NadavOsh/music-notes-detection-system/book/Project's Book.pdf

## הפקולטה להנדסת חשמל ואלקטרוניקה

ספר פרויקט – תואר ראשון

## פיתוח מערכת לזיהוי תווים מוסיקליים

## מאת:

## נדב אושרוב

## מנחה: ד"ר נונל טירר

## תאריך: 06/06/2025

Faculty of Electrical Engineering and Electronics

Bachelor’s Degree Project Book

## Development of a System for Musical Note Recognition

BY:

Nadav Osherov

## Supervisor: Dr. Nonel Tirer

## Date:06/06/2025

תקצירים

תקציר

הפרויקט הוא מערכת לזיהוי תווים מוסיקליים המשתמשת בחומרה ותוכנה משולבת.

המערכת כוללת בין היתר:מצלמה ,FPGA ,ארדואינו וממשק משתמש גרפי ב Python.

המצלמה לוכדת תמונה של תווים על תווים מוסיקליים, ה FPGA-מעבד את התמונה ושולח אותה למחשב, שם ממשק ה GUI-מזהה את התו המוסיקלי בעזרת אלגוריתם זיהוי קווים אדומים ושחורים. לאחר מכן, הארדואינו מפיק את הצליל המתאים דרך באזר פסיבי. הפרויקט משלב רכיבי חומרה ותוכנה לפתרון מעשי לזיהוי תווים בזמן אמת.

Summary

The project is a system for musical note recognition that uses integrated hardware and software. The system includes, among other components, a camera, FPGA, Arduino, and a Python-based graphical user interface. The camera captures an image of notes on a musical staff, the FPGA processes the image and sends it to a computer, where the GUI identifies the musical note using an algorithm that detects red and black lines. Then, the Arduino generates the corresponding sound through a passive buzzer. The project combines hardware and software components to provide a practical solution for real-time note recognition.

EXECUTIVE SUMMARY

Abstract

Music is an integral part of human culture and graphic records of it can be found since the early Middle Ages. Almost a millennium ago, the most common method of graphically recording notes that has survived to this day was developed, the "Staff" method, in which notes are written on five horizontal lines.

Despite the great affinity people have for music, the vast majority of them do not know how to read musical notes, let alone know how they sound from reading alone (which is a skill that most musicians do not have neither).

In recent years, there have been numerous attempts to develop systems that can play notes by photographing them. Most of them are applications rather than stand-alone systems and use machine learning models to perform the OMR, although the models do not work optimally at recognizing musical notes at the same level as they do on other characters [1].

Target

The goal of the project is to develop a system that includes a camera and a passive buzzer, which will enable capturing musical notes from a sheet and playing them using the buzzer.

Project Process:

This project integrates FPGA, Arduino, a camera module, and a Python-based GUI to identify and play musical notes. The system captures a photo of a musical note (with a red line below it), processes the image to detect the note, and then plays the corresponding sound through a passive buzzer.

The project involves four main development parts:

1. Writing code for the FPGA
2. Writing code for the Arduino
3. Developing the Python GUI
4. Creating the note recognition mechanism in Python
1. FPGA Code Development

The FPGA (implemented using a development board with MicroBlaze soft processor) handles the following tasks:

OV7670 Camera Configuration:
The camera is initialized using the SCCB protocol (similar to I2C). A dedicated module with a configuration ROM sends the necessary settings.

Image Capture:
The cam_capture module receives pixel data from the camera and stores it into BRAM (Block RAM). Only a 170×200 pixel region containing the note is captured.

VGA Display Output:
A VGA module reads from BRAM and displays the image on a screen using standard 640×480 VGA timing. A red reference line is drawn to help in note identification.

UART Communication with PC:
MicroBlaze sends the stored image over UART to the PC in text format (as pixel values). The data is processed later by the GUI.

Additional Components:

Clock Generator: Produces 25 MHz and 24 MHz clocks for VGA and camera.

Debouncer: Stabilizes push-button input.

Rising Edge Detector: Ensures single BRAM read per press.

Seven-Segment Display: Shows photo index and total requests.

LED Indicators: Reflect system status (controlled by C code).

2. Arduino Code Development

The Arduino receives the detected musical note via UART and plays the appropriate sound using a passive buzzer connected to pin 8. The code uses a frequency mapping of notes (e.g., DO, RE, MI...) to output PWM signals with the correct tone and duration.

3. GUI Development (Python)

The GUI, built with tkinter, allows the user to:

Initiate the photo-taking process.

Visualize the received image.

Trigger note recognition.

Send the detected note to the Arduino.

It acts as the central interface that connects the FPGA's image output with the Arduino’s sound output.

4. Note Recognition Mechanism in Python

Once the image (with the red line) is received from the FPGA in text format, the recognition process includes several steps:

Step 1: Image Reconstruction

The image is reconstructed from the text file using cv2 and numpy.

Step 2: Binarization and Preprocessing

The image is converted to binary (black and white).

A Gaussian blur is applied to reduce noise and improve line detection accuracy.

Step 3: Detecting the Staff Lines

A function is used to find the five black lines of the musical staff:

staff_lines = find_and_filter_staff_lines(binary, max_lines=5)

Uses np.sum(binary_image, axis=1) to project image brightness along rows.

A threshold is set at 70% of the maximum intensity to identify potential horizontal lines:

threshold = 0.7 * np.max(projection)

potential_lines = np.where(projection > threshold)[0]

The code then merges lines that appear in continuous rows (i.e., thick lines), treating them as one.

Further filtering is done to eliminate false positives: if two lines are closer than 60% of the average distance between staff lines, one of them is removed.

Only the first five valid staff lines are stored for further comparison.

Step 4: Red Line Detection

The RGB image is loaded using:

image = cv2.imread(uploaded_filename)

The image is converted to HSV (Hue, Saturation, Value) color space, which is more effective for color-based segmentation.

The red hue is found in two ranges: 0–10 and 170–180. Additional constraints on saturation (70–255) and value (50–255) ensure only strong reds are captured.

A binary mask is created where the red line appears as white, and everything else is black.

The vertical position (row) of the red line is then calculated.

Step 5: Note Identification

Now with:

An array of five staff line heights (from black line detection)

The vertical height of the red line

The system identifies the note by comparing the red line’s position relative to the black lines.

A predefined array of note names (from highest to lowest) is declared.

The red line's location is compared with each pair of adjacent black lines.

If it falls between two lines, the note is interpolated based on its relative distance.

Slight deviations are accounted for to correct minor noise or imperfect placement.

To sum up, this project demonstrates an end-to-end system combining hardware and software:

Hardware (FPGA + Camera + VGA + UART + BRAM)

Software (Python + OpenCV + GUI + UART)

Microcontroller (Arduino + Buzzer)

The modular design and well-defined stages make it a strong educational example of real-time embedded image processing.

Project Result Summary

In our project, we implemented a musical note recognition system based on simple image processing algorithms. We achieved nearly 100% accuracy in identifying basic white musical notes using a red reference line for detection.

While the recognition was highly successful within our limited set of test images, the project faced several constraints, mainly due to the low-quality camera and the slow UART communication between the FPGA and PC, which limited both data transfer speed and the number of samples we could test.

Some of the key limitations observed:

1. The system cannot currently recognize sharps, flats, or natural signs.
2. It does not identify note durations (whole, half, quarter).
3. Initial attempts using ellipse detection yielded less reliable results on low-resolution images, leading us to switch to the red-line method, which proved more robust under our conditions.

Overall, the system demonstrates that simple tools can achieve effective results in note recognition, and it provides a solid foundation for future enhancements such as duration detection and full music sheet interpretation.

## תוכן עניינים

### 1 מבוא

### 1.2 מטרת הפרויקט14 |

### 1.3 דרישות הפרויקט14 | 2 רקע תיאורטי 14

15 | | FPGA | 2.1
17 | I2C | פרוטוקול | 2.3.3
19 | | VGA | 2.4.2
21 | OpenCV | 2.4.4

### 3 פיתוח מערכת לזיהוי תויוים מוסיקליים 24

### 3.2 פתרונות אלטרנטיביים26 |

### 3.3 שאלת המחקר 27 | 4 מהלך העבודה 28

### 4.2 מימוש 28 |

31 | cam_init 4.2.1.3.1.1

31 | cam_capture 4.2.1.3.1.2
31 | debouncer 4.2.1.3.2
32 | VGA_TOP 4.2.1.3.3
32 | design_1 4.2.1.3.4
33 | simple_seven_segment 4.2.1.3.5
33 | Signal_generator 4.2.1.3.6
33 | BRAM 4.2.1.3.7
33 | Rising_edge_detector 4.2.1.3.8
34 | Clock_gen 4.2.1.3.9
34 | ILA 4.2.1.3.10

### 4.2.1.3.11 תיאור לחצנים, LEDS ו SW בשימוש בערכת הפיתוח פרויקט | 34

35 | Python | מבוסס | GUI | 4.2.2

### 4.2.2.1 מסך -1 פתיחה | 35

36 | Power UP -2 | מסך | 4.2.2.2

4.2.2.3 מסך -3 שאלה למשתמש | 37 4.2.2.4 מסך -4 כמות התמונות | 38 4.2.2.5 מסך -5 הוראות לצילום התמונה | 39 4.2.2.6 מסך -6 הגדרות | 39 4.2.2.7 מסך -7 הרצת ויטיס | 40 4.2.2.8 מסך -8 העלאת קובץ טקסט | 41 4.2.2.9 מסך -9 מסך הזיהוי | 42 4.2.2.10 מסך -10 מסך החלטה | 44 4.2.2.11 מסך -11 מסך ניגון התווים | 45 4.2.2.12 מסך -12 מסך פרידה | 46
47 | | | Arduino | 4.2.3
48 | | | OV7670 | 4.2.4

### 4.2.5 תרשים זרימה של הפרויקט | 48 5 תוצאות והצעות להמשך מחקר 49 6 מסקנות 57 7 ביבליוגרפיה 59

## רשימת איורים

## רשימת טבלאות

טבלה :1 תיאור לחצנים, LEDS ו- SW בשימוש בערכת הפיתוח פרויקט 34 |
טבלה :2 תוצאות של מספר דגימות של תמונות של תווים49 |
טבלה :3 תוצאות של רצף תווים עם משקלים שונים 51 |
טבלה :4 תוצאות של רצף תווים עם סימנים שונים 54 |
טבלה :5 תוצאות של רצף התווים הראשונים של יונתן הקטן55 |

## רשימת קיצורים

OMR – Optical Music Recognition

FPGA – Field-Programmable Gate Array

IP- Instruction Pointer

IC- Integrated Circuit

CPU- Central Processing Unit

I/O- Input/Output

RISC- Reduced Instruction Set Computing

PWM- Pulse-Width Modulation

ICSP- In-Circuit Serial Programming

EEPROM- Electronically Erasable Programmable Read-Only Memory

UART- Universal Asynchronous Receiver-Transmitter

SPI – Serial Peripheral interface

SCLK- Serial Clock

MOSI- Master Out Slave In

MISO- Master In Slave Out

SS- Slave Select

I

2C- Inter-Integrated Circuit

SDA- Serial Data

SCL- Serial Clock

RGB- Red Green Blue

VGA- Video Graphics Array

HDMI- High-Definition Multimedia Interface

RAM- Random Access Memory

USB- Universal Serial Bus

PMOD- Peripheral Module Interface

PC- Personal Computer

SCCB – Serial Camera Control Bus

ROM – Read-Only Memory

LED – Light Emitting Diode

GUI – Graphical User Interface

ILA-Integereted Logic Analyzer

## 1 מבוא 1.1 רקע כללי

מוזיקה היא חלק בלתי נפרד מהתרבות האנושית וניתן למצוא תיעודים גרפים שלה עוד מימי הביניים המוקדמים. לפני כמעט מילניום התפתחה השיטה הנפוצה ביותר לרישום תווים שנופצה עד ימינו אנו, היא שיטת ה"חַ מְ שָׁ ה" בה התווים כתובים על גבי חמישה קווים אופקיים.

אף על פי הזיקה הרבה שיש לאנשים למוזיקה, רובם המוחלט לא יודע לקרוא תווים מוסיקליים, על אחת כמה וכמה לדעת איך הם נשמעים מקריאה בלבד )שזו מיונות שגם למרבית המוזיקאים אין(.

בשנים האחרונות נעשה מספר רב של ניסיונות לפתח מערכות שיידעו לנגן תווים על ידי צילום שלהם. רובן ככולן הן אפליקציות ולא מערכות שעומדות בפני עצמן ומשתמשות במודלים של למידת מכונה על מנת לבצע את ה OMR, אם כי המודלים אינם עובדים בצורה מיטבית על זיהוי תווים מוסיקליים באותה רמה של זיהוי תווים שאינם מוסיקליים ]1[.

## 1.2 מטרת הפרויקט

מטרת הפרויקט היא לפתח מערכת הכוללת מצלמה ובאזר פאסיבי שבאמצעותה יהיה ניתן לצלם את התווים השונים מתוך דף התווים לשמוע אותם מתנגנים על ידי הבאזר.

## 1.3 דרישות הפרויקט

- הכרת העקרונות של כתיבת תווים ברמה בסיסית
- שימוש במצלמה בעזרת FPGA
- למידת והכרת העקרונות של עיבוד תמונה וראייה ממוחשבת
- מימוש התקשורת בין הרכיבים השונים
- תיעוד בספר הפרויקט
- עמידה בלוחות זמנים

## 2 רקע תאורטי

– FPGA 2.1
רכיב חומרה הניתן לתכנות ומאפשר יצירת מעגלים דיגטליים מותאמים אישית. ההבדל העיקרי בינוי לבין מעבד הוא שה-FPGA יכול לעבוד בצורה מקבילית כלומר לבצע מספר פעולות במקביל.
ה-FPGA בנוי ממספר חלקים עיקריים: א. בלוקים לוגיים- יחידות עיבוד בסיסיות שמבצעות פעולות לוגיות ואריתמטיות. ב. רשת חיבור- מערכת של קווים שמחברת בין הבלוקים הלוגיים השונים. ג. יחידות זיכרון- מאפשרות אחסון נתונים. ד. חיבורי O/I- מאפשרים תקשורת עם רכיבים חיצוניים.

ה-FPGA יכול להגיע לקצבים גבוהים מאוד וניתן למצוא אותו בתעשיות הביטחוניות והרפואיות.

-MICROBLAZE 2.1.1
מעבד תוכנתי שנמצא בשימוש בפךטפורמות FPGA של חברת XILINX. הוא נבנה כמעבד גמיש אשר ניתן להגדירו בקלות. המיקרובלייז נותן אפשרות למפתחים לכתוב קוד בשפת תכנות ספציפיות )לדוגמה: שפת C ) ו"להשתיל" את הקוד הזה בתוך ה-FPGA. יתרון מרכזי של מיקרובלייז הוא שדרכו ניתן לכתוב ולקרוא מתוך רגיסטרים של s'IP מסוימים של חברת XILINX דרך קריאה וכתיבה של מזיכרון בשפת תכנות ספציפיות וללא צורך בכתיבת קוד בשפת חומרה.

### 2.2 מיקרובקרים –

מיקרובקר הוא מערכת מחשב קטנה ועצמאית המיועדת לבצע משימות ספציפיות. המיקרובקרים הם בעצם מעגלים משולבים )IC )המשלבים מעבד )CPU), רכיבי זיכרון, רכיבי קלט\פלט )O/I )ועוד.
מיקרו בקרים נמצאים בשימוש נרחב ביישומים שונים כגון רובוטיקה, מכשור רפואי, אוטומצייה תעשייתית וכו'.
למיקרו בקרים יש זיכון שאינו נדיף, מה שמאפשר להם לשמור נתונים גם לאחר שהם מנותקים מהחשמל.

-Arduino Uno 2.2.1
בין מוצרי המיקרו בקרים הנפוצים למשל ניתן למצוא את Uno Arduino. ערכה זו מכילה את המיקרובקר 328ATmega ממשפחת megaAVR של Atmel. מיקרובקר זה מכיל יחידת עיבוד שבנויה בארכיטקטורת הרווארד )בה יש הפרדה בין הזיכרון קוד לזיכרון דאטה( RISC bit8-)מקבלת בכל פעם דאטה של 8 בתים ומשתמשת בסט הוראות פשוטות ומהירות(. ה Uno Arduino מכיל 14 כניסות\יציאות דיגיטליות )מתוכם 6 יכולות לשמל כ יציאות PWM, 6 כניסות אנלוגיות, כניסת USB ואפשרות לחבר לחשמל ישירות ע"י Jack Power, ICSP )המאפשרים להעלות את התוכנה באופן ישיר מבלי לגעת בחומרה( כפתור אתחול ושעון בתדר 16 MHz. ה ATmega מכיל EEPROM( זיכרון לקריאה בלבד הניתן למחיקה אלקטרונית( בגודל kb.1 בתמונה למטה ניתן לראות את הערכה עם הפורטים השונים שלה.

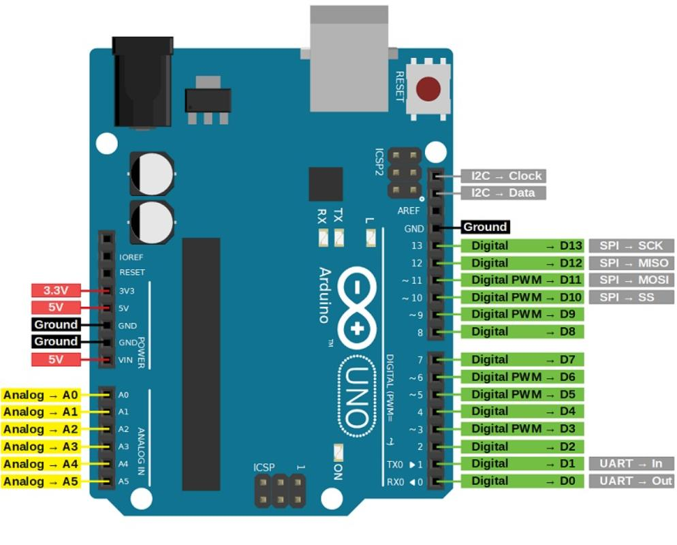
[picture p1: figure]

איור :1 הפורטים של ארדואינו אונו

-Raspberry Pi 2.2.2
עוד ערכה שנחשבת לעיתים דחופות למיקרובקר היא רסאפברי פאי. דבר זה הוא למעשה טעות מאחר מכיוון שראספברי פאי אינו מיקרו בקר אלא מחשב board-single. לעומת המיקרו בקרים, ראספברי פאי מריץ מערכת הפעלה שלמה )למשל לינוקס( ויכול לעשות פעולות רבות במקביל. ניתן בעזרתו להתחבר לאינטרנט, להריץ סקריפטים של פייתון ועוד. עם זאת עקב הדמיון הרב נהוג לעיתים להתייחס אליו כאל מיקרובקר.

### 2.3 פרוטוקולי תקשורת-

פרוטוקול תקשורת מתייחס למערכת של כללים, מוסכמות ונהלים המסדירים את חילופי המידע בין שתי ישויות או יותר ברשת תקשורת. הוא מגדיר כיצד נתונים מועברים מתקבלים ומתפרשים, יכול להכיל אימותים ותיקוני שיגאות ומבטיח תקשורת אמינה ויעילה בין מכשירים או מערכות.

### 2.3.1 פרוטוקול UART-

פרוטוקול תקשורת סדרתית שמטרתו העברת נתונים בין שני מכשירים בצורה פשוטה ויעילה.

בין המכשירים אין חיבור של שעון, כלומר התקשורת היא אסינכרונית.

כל מכשיר שולח את הנתונים בקצב גבוה והקבלה מתבצעת לי הזמן המתואם בין שני הקווים.

בפרוטוקול זה יש שני קווים עיקריים:

TX- משמש לשליחת המידע.

RX- משמש לקבלת המידע.

הפרוטוקול כולל סנכרון כמו bit start לסימון התחלת העברת המידע ו- bit stop לסימון סיום העברת המידע.

ה-UART נמצא בשימוש רחב מכיוון שכמות ההקווים הדרוש לשימוש הוא נמוך מאוד )2 עבור השימוש הפשוט בפרוטוקול( ובשל הפשטות שלו.

### 2.3.2 פרוטוקול SPI-

פרוטוקול של תקשורת טורית סינכרונית בשימוש רב. פרוטוקול זה הוא דופלקס מלא המאפשר העברת נתונים בין התקן מאסטר למספר התקני עבדים. הממשק מכיל ארבעה קווים.

קו SCLK המשמש לסנכרון העברת הנתונים בין המאסטר לעבדים.

קו MOSI המשמש להעברת הנתונים מהמאסטר לעבד.

קו MISO המשמש להעברת הנתונים מהעבד למאסטר.

קו SS המשמש לבחירת התקן העבד שיתקשר עם המאסטר.

פרוטוקול זה נחשב לפרוטוקול פשוט ומהיר.

| 2.3.3 פרוטוקול
- C
2 | פרוטוקול
הוא פרוטוקול תקשורת סינכרונית טורית. בתקשורת זו משתמשים בשני חוטים בלבד.

קו SDA המשמש להעברת הנתונים מהמאסטר לעבד ולהפך.

קו SCL המשמש לסנכרון התקשורת בין המכשירים.

פרוטוקול C2I משתמש בשיטת התחלה-עצירה של תקשורת.

לפני שהמכשיר הראשי יכול לתקשר עם התקן עבד, עליו לשלוח תחילה אות התחלה כדי לציין את תחילת השידור.

אות ההתחלה הוא מעבר נמוך לגבוה בקו SDA בעוד קו SCL גבוה.

לאחר שליחת אות ההתחלה, המכשיר הראשי שולח את הכתובת של מכשיר העבד איתו הוא רוצה לתקשר.

הכתובת היא בדרך כלל באורך של 7 ביטים, אך ניתן להרחיב אותה ל10- ביטים עבור מערכות גדולות יותר.

מכשיר העובד עם הכתובת המתאימה יגיב באות אישור.

לאחר שהתקן העבד אישר את ההתקן הראשי, המאסטר יכול לשלוח או לקבל נתונים מהעבד.

המאסטר שולח נתונים על קו SDA בעוד קו SCL גבוה. התקן העבד מקבל את הנתונים ושולח אות אישור למכשיר הראשי.

כאשר המכשיר הראשי סיים לשלוח או לקבל נתונים, הוא שולח אות עצור כדי לציין את סיום השידור.

אות העצירה הוא מעבר גבוה לנמוך בקו SDA בעוד שקו SCL גבוה.

### 2.4 ראייה ממוחשבת-

ראייה ממוחשבת היא ענף מרכזי של מדעי המחשב העוסק בעיבוד אוטומטי של תמונות, במטרה לחלץ ולפרש מידע חזותי. דבר זה משמש לזיהוי עצמים, סיווג תמונות, זיהוי תמונות וכו'. אלגוריתמים של ראייה ממוחשבת עושים זאת ע"י שימוש במודלים מתמטיים על התמונות. התמונות מיוצגות מתמטית ע"י מטריצות המייצגות את ערכי הפיקסלים. ניתן לעשות זאת במודלים שונים, כגון RGB, Grayscale, ייצוג בינארי ועוד.

### 2.4.1 מודלים לקידוד תמונות-

RGB

מודל צבעים שבו כל צבע נוצר משילוב של שלושה צבעים בסיסיים: אדום,ירוק וכחול.

המודל מבוסס על עקרון של שילוב צבעים כך שכל ערוץ מקבל ערך בטווח מסויים וכך ניתן לייצר צבעים רבים.

נמצא בשימוש נרחב במכשירים אלקטרוניים כמו מסכים ומצלמות דיגיטליות.

מודל זה מאפשר יצירת צבעים רבים תוך השתמשות בשלושה צבעים בלבד.

Grayscale

מודל בו המטריציות הן דו מימדיות וכל ערך מייצג צבע "אפור" שנע בין לבן )לרוב 255( לשחור )לרוב 0(

Binary

תמונות בינאריות מכילות ערכים 0 או 1 וכך מציגות רק את הצבעים שחור ולבן מבלי האפור שבאמצע.

בתמונה הבאה ניתן לראות תמונה של פרח בשלושת המודלים המוזכרים לעיל )כש a זה RGB, b זה Grayscale ו c זה binary)

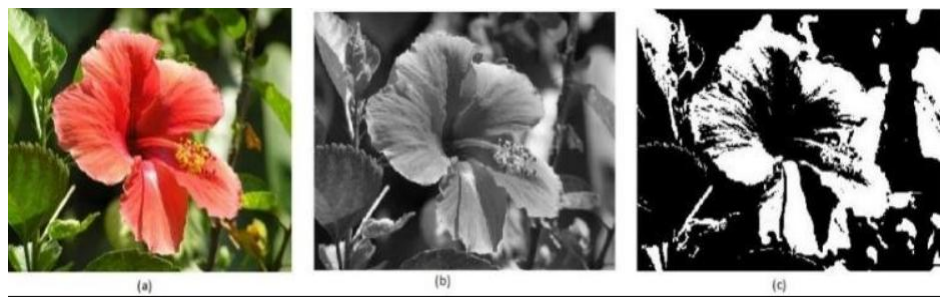
[picture p2: figure]

איור :2 תמונה של פרח ב RGB Grayscale ו Binary[ 2]

## -VGA 2.4.2

פורמט תצוגה ותקן לקישור בין מחשב למסך.

הוא תומך ברזולוציה של 640 על 480 פיקסלים ומשתמש במספר פורטים למעבר נתוני ה-RGB ומספר פורטים לסנכרון.

למרות שה-VGA הוא תקן ישן יחסית ובתעשייה ישנם ממשקים אחרים כמו DisplayPort ו-HDMI ה-VGA נשאר תקן נפוץ במערכות מסוימות.

### 2.4.3 פילטרים לעיבוד תמונה-

בשביל להריץ אלגוריתמים של ראייה ממוחשבת צריך תחילה לבצע עיבוד תמונה ברמה המיטבית. חלק חשוב בתהליך זה הוא שימוש במסננים )פילטרים( שישנו את התמונה כך שיהיה ניתן לעבוד איתה ביתר קלות. קיים מספר רב של פילטרים בתחום עיבוד תמונה.

Median Filter

מסנן זה הוא מסנן נפוץ בתחום העיבוד תמונה. הוא משמש בעיקר להורדת רעש "פלפל ומלח". המסנן הוא מסנן לא לינארי והוא עובד כך שהוא לוקח "חלון" עם מספר מסויים של ערכים, מוצא בין ערכים אלו את המספר שהוא החציון ומשאיר רק אותו.

לדוגמה עבור חלון בגדול 3x3 שמקבל את הערכים הבאים
[

1 2 3
4 8 6
7 5 9

]

האלגוריתם תחילה יסדר את המספרים לפי סדר עולה [1,2,3,4,5,6,7,8,9], ואז ייקח את המספר באמצע, זה החציון. החציון הוא ,5 לכן הערך במרכז, ,8 יוחלף ב .5
[

1 2 3
4 5 6
7 5 9

]

ככה עושים עבור כל הערכים. עבור הקצוות יש גישות שונות, הנפוצה מבניהן היא להוסיף ריפוד של ערכים שזהים לערכים בקצוות. כך למשל מקבלים בסוף את מהמטריצה הראשונה את המטריצה
[

2 3 3
4 5 6
7 7 8

]

Gaussian Filter
טשטוש גאוסיאני הינו טשטוש המשתמש בעקומת גאוס כבסיס ההתמרה. פילטר זה גורם לקווי המתאר בתמונה להיות קלים יותר לזיהוי. הוא גורם לכך שהערכים במרכז מקבלים ערכים גבוהים יותר לפי עקומת גאוס. הפילטר פועל לפי הפונקציה הבאה:

G(x, y) =

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
כש (y,x (הן הקואורדינטות

זה הסטיית תקן. הגדלת סיגמא תיצור טשטוש גדול יותר.

ניקח לדוגמה חלון 3x.3 הסטיית תקן תהיה .1 ערכי y,x יראו כך:
[
(−1,1) | (0,1) | (1,1)
(−1,0) | (0,0) | (1,0)
(−1, −1) (0, −1) (1, −1)

]

לאחר מכן נבצע את החישובים:

G(0,0) =

1
2π ∙ 1

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
≅ 0.159

G(−1,0) =

1
2π ∙ 1

2

e

−

(−1)

2+0

2
2∙1

2 =

1
2π

e

−0.5 ≅ 0.096

וכן הלאה. ניתן לשים לב לסימטריה של הפונקציה וכך לחסוך בחישובים מיותרים. לבסוף נקבל את המטריצה:
[

0.058 0.096 0.058
0.096 0.159 0.096
0.058 0.096 0.058

]

השלב הבא הוא ביצוע נורמליזציה. כלומר לחלק כל ערך הסכום של כל הערכים יחדיו.

SUM = 0.058 + 0.096 + 0.058 + 0.096 + 0.159 + 0.096 + 0.058 + 0.096
+ 0.058 = 0.775

כעת מקבלים את המטריצה
[

0.075 0.124 0.075
0.124 0.205 0.124
0.075 0.124 0.075

]

בקירוב ניתן להציג את המטריצה הזאת כ

1

16 [

1 2 1
2 4 2
1 2 1

]

לצורך הדגמה ניקח שוב את המטריצה הקודמת
[

1 2 3
4 8 6
7 5 9

]

כעת הערך שבמרכז )8( יקבל את הערך הבא:

(1x0.075) + (2x0.124) + (3x0.075) + (4x0.124) + (8x0.205) + (6x0.124) + (7x0.075) + (5x0.124) + (9x0.075) = 5.25

אם עובדים עם תמונות עם point floating( bit32- או bit64- )הערך יוכל להישאר כך. אם עובדים עם תמונות bit8- המספר יעוגל ל .5
[

1 2 3
4 5 6
7 5 9

]

כך ממשיכים עבור כל הפיקסלים. עבור הקצוות עושים padding בדומה ל Filter Median.

-OpenCV 2.4.4

OpenCV היא חבילת תוכנה שנועדה לעזור למתכנתים לפתח יישומים של ראייה ממוחשבת. התוכנה היא בעלת קוד פתוח. התוכנה נכתבה ב ++C אך עם השנים פותחה ספרייה עבור פייתון )2cv )שמאפשרת להשתמש באלגוריתמים אלה בפייתון וכך מקלה על השימוש בהם. החבילה מכילה פילטרים, זיהוי אובייקטים, הסרת אובייקטים ועוד.

### 2.5 בסיס תאורטי במוזיקה:

### 2.5.1 צליל כתופעה פיזיקלית-

התופעה של קול נוצרת כתוצאה של עלייה וירידה של לחץ בתווך מסוים. על תופעה זאת ניתן לחשוב כעל גל המייצג את התפשטות התופעה של שינוי הלחץ בזמן ובמרחב. כך למשל באיור הבא ניתן לראות גרף בו הציר האנכי מייצג את הלחץ )מה שמתורגם לאמפליטודה, או לווליום של הצליל, אשר לרוב נמדד בדציבלים( והאופקי את הזמן:

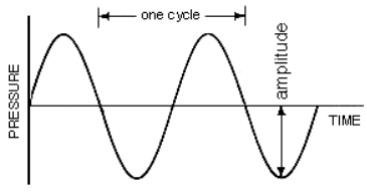
[picture p3: figure]

איור :3 גרף סינוסואידלי של לחץ כתלות בזמן נהוג לחשוב על צליל "טהור" כגל סינוס, אז ניתן גם להגדיר את התדירות של הגל. במקרה הריאלי הגל הוא אינו גל סינוס, עדיין לפי התמרות פורייה ]3[ אפשר לפרק אותו למספר )סופי או אינסופי( של גלים סינוסואידלים שונים ולקבוע את תדר הצליל לפי הדומיננטי מבניהם. כך אפשר למשל לקבוע תווים מוזיקליים. למשל גל בעל Hz440 בעולם המוזיקה ייקרא 4A( לה באוקטבה הרביעית( וכו'. ככל שהתדירות תהיה נמוכה יותר, כך גובה הצליל יהיה נמוך יותר ולהפך. באיור הבא למשל ניתן לראות בצורה איכותית את ההבדל בין התו דו )בכחול( לתו סול שגבוה ממנו )באדום(.

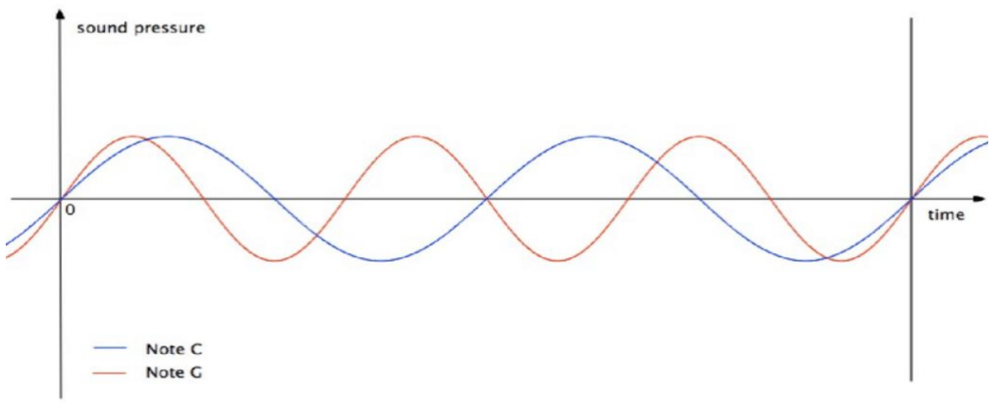
[picture p4: figure]

איור :4 השוואה גרפית בין תווים שונים

### 2.5.2 באזרים-

באזר, או בעברית זמזם, הוא רכיב המפיק צליל. באזרים יכולים להיות מכאניים, אלקטרומכניים, או פיאזואלקטרים. פיאזואלקטריות היא תכונה של גבישים קרמיים מסוימים ליצור מתח חשמלי כתוצאה מלחץ מכני ולהפך. עוד הבחנה חשובה היא ההבחנה בין באזרים אקטיביים לבאזרים פאסיביים. באזרים אקטיביים מכילים מעגל פנימי שמפיק צליל קבוע כאשר הוא מקבל זרם חשמלי. באזרים פאסיביים לעומת זאת יכולים להפיק תדרים שונים לפי המתח שמופעל עליהם.

### 2.5.3 רקע בסיסי בקריאת תווים-

על מנת להבין הפרויקט נדרש ידע בסיסי בקריאת תווים מוזיקליים. כאמור השיטה שמשתמשים בה היום היא שיטת החמשה, בה יש חמישה קווים ואליפסה עליהם\ביניהם. האליפסה מייצגת את גובה הצליל. ככל שהאליפסה נמצאת גבוה יותר כך גם התו נמצא גבוה יותר. האליפסה יכולה להיות מתחת לקו, על הקו או מעליו, כל עלייה אחת כזאת מייצגת עליה בתו אחד. בתמונה הבאה ניתן לראות את רצף התווים דו, רה, מי, פה, סול, לה, סי, דו.

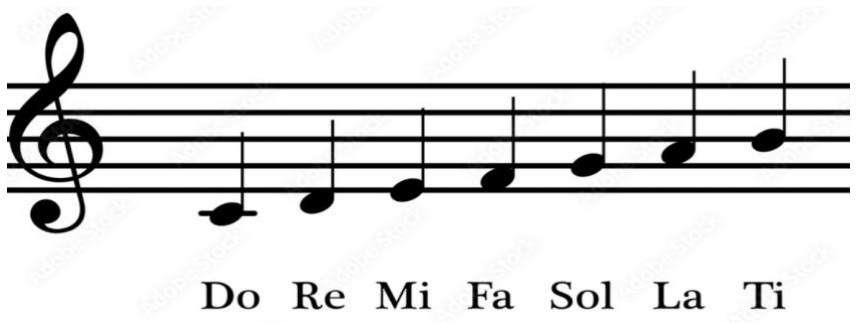
[picture p5: figure]

איור :5 רצף תווים של אוקטבה רביעית הדבר הבסיסי השני שצריך לדעת בקריאת תווים הוא זיהוי המשקלים. המשקל של התו אומר כמה זמן הוא נמשך )זמן זה הוא היחס בינו לבין אורך התיבה, אך אין צורך להתעמק בזה כעת(. עיגול חלול בלי קו הוא שלם, אחריו עיגול חלול עם קו שמסמל חצי, אחריו עיגול מלא עם קו שמסמן רבע, אם מוסיפים עוד קו אחד הצידה זה שמינית. ניתן לראות את התווים באיור הבא.

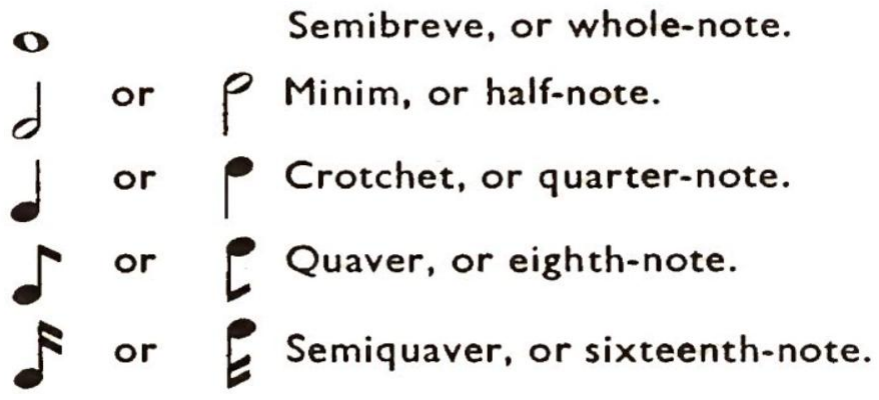
[picture p6: figure]

איור :6 צורות שונות של התווים לפי משקלים

### 3 פיתוח מערכת לזיהוי תווים מוזיקליים:

### 3.1 הצגת המערכת-

תרשים בלוקים:

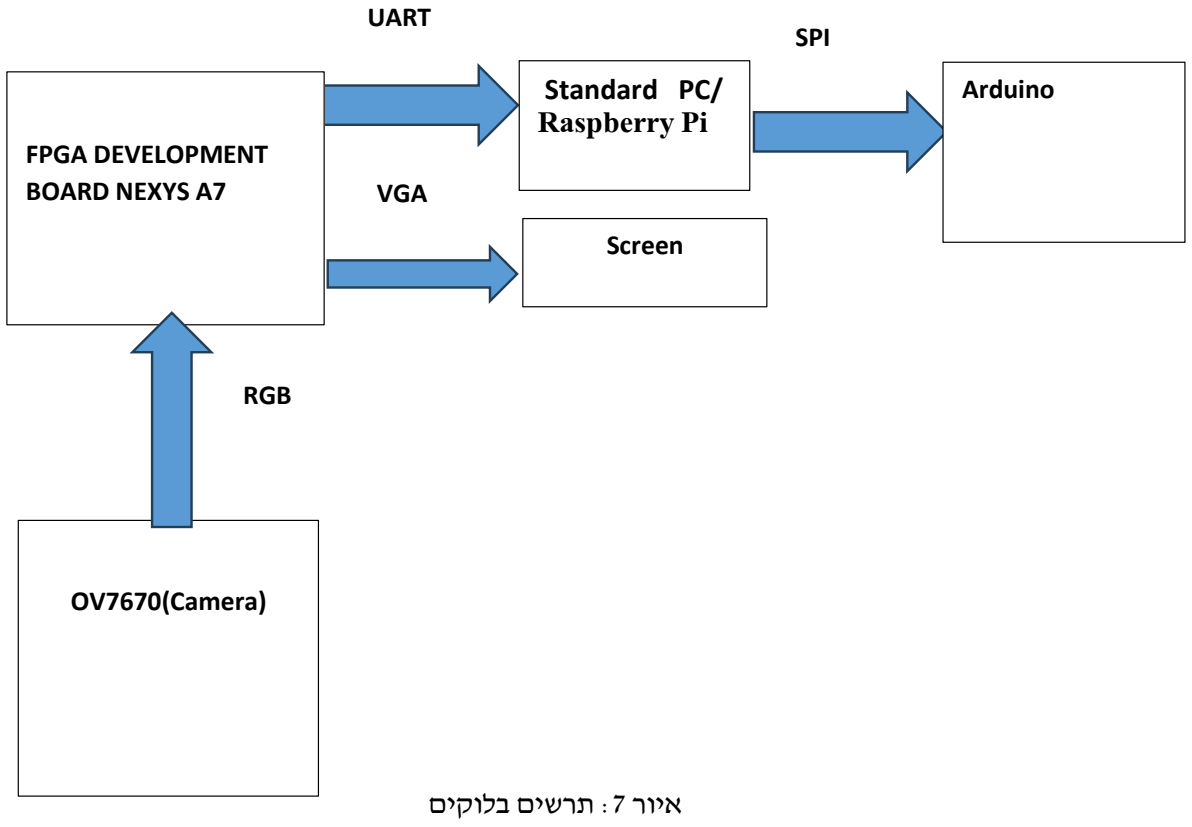
[picture p7: figure]
איור :7 תרשים בלוקים; FPGA DEVELOPMENT BOARD NEXYS A7; Standard PC/ Raspberry Pi; Arduino; OV7670(Camera); UART; SPI; RGB; Screen; VGA

הסבר על הבלוקים:
– OV7670(Camera)
מודל מצלמה בסיס וקטן.
המודל מצויד בחיישן תמונה מסוג CIS ומספק תמונות בחדות גבוהה יחסית למצלמות אחרות בגודל דומה.
פועל על פי פרוטוקול RGB המצלמה מצוידת בפרוטוקול C2I לשליטה בהגדרות המצלמה. בפרויקט שלנו המצלמה מחוברת דרך פרוטוקול RGB לערכת הפיתוח הכוללת FPGA.
חברת | של FPGA | מבוסס | פיתוח | לוח - FPGA DEVELOPMENT BOARD NEXYS A7
.XILINX
הלוח מציע מגוון רחב של יישום פרויקטים בתחומים רבים. הלוח כולל בין היתר:

- 7A ARTIX XILINX ה-FPGA עליו מבוססת ערכת הפיתוח.
- זיכרון RAM.
- כניסות ויציאות.
- חיבור USB לשם צריבה ו-DEBUG. בפרויקט שלנו ערכת הפיתוח משמשת לקבלת המידע מהמצלמה דרך חיבור ה-PMOD בפרוטוקול RGB ,שליטה בפעולות המצלמה ושליחת הפיקסלים של התמונה שצולמה לכיוון ה-PC דרך פרוטוקול UART.
Screen - מסך מחשב סטנדרטי שתפקידו להראות על המסך את התמונה המשודרת מהמצלמה. PC Standard – מחשב סטנדרטי שתפקידו לקבל את התמונה המצולמת על ידי המשתמש ודרך כלים מתקדמים בשפת python לבצע עיבוד לתמונה ולזהות באיזה תו מדובר. את התו המזוהה המחשב שולח דרך ממשק USB וממיר USB ל-SPI אל הארדואינו. Arduino – פלטפורמת חומרה פתוחה פשוטה ונגישה במיוחד. הפלטפורמה כולל לוחות מיקרובקרים שמאפשרים למשתמשים ליצור ולבצע פרויקטים אלקטרוניים בצור קלה ומהירה. תפקיד הפלטפורמה בפרויקט שלנו הוא לקבל את הנתונים לאחר זיהוי התו בתמונה במחשב הסטנדרטי בפרוטוקול SPI ולפי התו שיתקבל מהמחשב לנגן אותו דרך הבאזר.

תיאור הפתרון המוצע בפרויקט: תפקידו המרכזי של הפרויקט הינו לעזור בלימודי המוזיקה כך שדף תווים יוכל להישמע בצורה קלה כך שהנגן יוכל להבין איך נשמעת המנגינה שעליו לנגן. המשתמש ישתמש בממשק המשתמש ושם יובאו הוראות מדויקת מרגע סריקת התווים ועד להשמעתם.
לאחר מסך הפתיחה בממשק על המשתמש לכוון את המצלמה לכיוון התווים שאותם הוא רוצה לנגן.
הוא יצטרך לבחור לכמה תווים הוא מעוניין להאזין ובהתאם לכך יהיה מספר התמונות שעליו לצלם.
לדוגמה: אם ירצה להאזין למנגינה בת 8 תווים עליו לצלם 8 תמונות. במסך הסטנדרטי תופיע התמונה מהמצלמה ועליה קו אדום. על המשתמש לכוון את הקו האדום לקצה התחתון של התו שאותו הוא מצלם. לאחר צילום התו עליו לעקוב אחר ההוראות על מנת לשלוח את התמונה המצולמת אל המחשב שם.
לאחר כל שליחה למחשב, המחשב יבצע באופן אוטומטי את זיהוי התו מתוך התמונה ויאגור את התוצאות במקום המיועד לכך.
כך שוב ושוב עד לקבלה וזיהוי של כל התווים אותם המשתמש מעוניין לסרוק. לאחר מכן, התווים יישלחו אל ערכת הארדואינו והבאזר שאליו מחוברת ערכת הארדואינו ינגן את התווים שצולמו על ידי המשתמש.

### 3.2 פתרונות אלטרנטיביים:

### 3.2.1 שימוש במודלים של למידה עמוקה-

בעידן בו אנו חיים כיום השימוש במודלים של למידה עמוקה נהיה יותר ויותר נפוץ והמודלים נהיים יותר ויותר טובים. בנוסף לכך השימוש בשיטה זו יכול להיות מתאים בעיקר כשהתווים אותם אנו מנסים לזהות כתובים ע"י מחשב בפורמטים די אחידים. עם זאת השימוש במודלים של למידת מכונה לא תמיד תואם את התחום של זיהוי תווים מוזיקליים כמו שכבר צוין קודם לכן ]1[. צריך גם לקחת בחשבון ששימוש במודלים אלו יכול להכביד על המכשירים בהם אנו עובדים. הבעיה העיקרית בשימוש ביצירת מודלים של למידת מכונה הוא שנרדש dataset גדול ומתאים לבעיה עליה אנו עובדים. עם זאת לא נראה שקיימים dataset-ים מספיק טובים לבעיה שאנו מנסים לפתור. רובם נועדו לזיהוי של תווים בכתב יד ולא נותנים תוצאות של תווים בודדים אלא של כל העמוד ביחד. דבר זה נועד לבעיה הרבה יותר קשה ולכן גם בתחומם הם לא תמיד מביאים תוצאות מספקות ולשימוש בבעיות כמו שלנו הם פשוט לא תואמים. עם זאת ניתן למצוא dataset-ים שהם יותר תואמים לבעיה שלנו, אך התמונות שם הן הומוגניות מדי, וכמו שכבר ניסינו במהלך הפרויקט אפשר לפתח עליהם מודלים שמגיעים למעל ל 95% על סט המבחן שלנקח מהדאטה סט ועדיין לא לקבל תוצאות טובות בתמונות אחרות. בנוסף חלק גדול מהם נועד לזהות רק את צורת התו )כלומר את המשקל שלו( ולא את התו עצמו )דבר שלמעשה גם מקשה לזיהוי הצורה של התו בגלל השוני בתמונות(. ייתכן והפתרון האידיאלי עבור הבעיה שלנו היה יצירת dataset תואם בעזרת הכלים בהם אנו עובדים, אך בהינתן הזמן, המאשבים ועצם העובדה שמספר הלייבלים בדאטה סט יהיה כה רב וכל לייבל יצטרך כמה מאות או אלפי תמונות פתרון זה אינו ראליסטי אך ייתכן שאם מערכת כזאת הייתה מפותחת עבור חברה או יזמים עם מספיק זמן משאבים פתרון זה היה הפתרון המועדף.

### 3.2.2 יצירת כל המערכת על מחשב בודד-

פתרון מתבקש אחר לבעיה בה אנו עוסקים הוא עבודה על מחשב בודד. דבר זה יכול להיות אפשרי על מחשב אישי סטנדרטי או אפילו על ראספבריי פאי. ככה ניתן לחסוך את העבודה של התקשורת בין הרכיבים, להוריד מכמות הרעשים וההפרעות, ואולי לעבוד עם מכשיר קומפקטי יותר ולזרז תהליכים. עוד יתרון למשל בשימוש במחשב אישי או פלאפון זה שאין בהכרח צורך במצלמה חיצונית ובאזר. אנחנו בחרנו לא ללכת בדרך זו בעיקר למטרות למידה ולרכישת ניסיון במהלך הפרויקט עם כלים וטכניקות שונות.

### 3.2.3 שימוש באלגוריתמים של ראייה ממוחשבת בלבד-

השימוש במערכת נעשה כך שהמשתמש מצלם בכל פעם תו אחד בנפרד ויש אפשרות לסמן בקו אדום את האליפסה ואז לשלוח את התמונה. אומנם ניתן לחסוך זאת על ידי שימוש באלגוריתמים לזיהוי אובייקטים, אז היה ניתן לצלם את כל התווים בתמונה אחת, ובאלגוריתם של זיהוי אליפסות. כאן בנו צריכים להזכיר שהציוד איתו אנו עובדים נחשב ליחסית פשוט וישן והמצלמה עצמה שאנחנו מחברים ל FPGA אינה נותנת תוצאות מספיק איכותיות. כך למשל יצרנו קוד המכיל שימוש בפונקציה של זיהוי אליפסות עם המון עיבוד מקדים וקיבלנו תוצאות די מספקות על תמונות שנלקחו מהאינטרנט אך תוצאות עם הרבה יותר שגיאות על תמונות שלקנו מה FPGA עמו אנו עובדים. בעקבות כך הועלה הרעיון של שימוש בקו עזר אותו המשתמש ישים ולאחר שליחת התמונה יהיה צורך לזהות רק את הקווים האופקים, שזה אלגוריתם עם הרבה פחות שגיאות מאלגוריתמים של זיהוי אליפסות, ויהיה ניתן לזהות את מיקום האליפסה לפי זיהוי הקו האדום ביחס לשאר הקווים.

### 3.3 שאלת המחקר:

כפי שכבר צוין לעיל, מערכות שיודעות לקרוא תווים הן נדירות וקשות ליישום. אנו ניסינו לבחון דרך מקורית לגשת לבעיה בה אנו משתמשים בכלים שונים )FPGA, מיקרובקר ומחשב( ובעזרתם מפרקים את הבעיה לחלקים שונים ומנסים לפתור אותה. בנוסף אנחנו לא השתמשנו בלמידת מכונה, כך שאין חשש לאוברפיטינג של המודל. ניסנו לבדוק איך ניתן לנסות לגשת לבעיה המורכבת הזאת על ידי שימוש בכלים פשוטים יותר ובגישה חדשה ומקורית.

### 4 מהלך העבודה:

### 4.1 מתודולוגיה-

בחלק התוצאות בהמשך הספר מפורטים אופן איסוף התוצאות בפרויקט שלנו. שיטת איסוף התוצאות שבה נעשה שימוש היא בדיקה כמותית של כמה שיותר תווים מסוגים שונים ובדיקת הזיהוי שלהם.
קיימים כמה מודלים לזיהוי תווים העיקריים ביניהם נותנים דיוק של מעל 90% בזיהוי התו. הפרויקט שלנו התקרב מאוד ל100%- מבחינת זיהוי התווים, אך יש לזכור שבדקנו מספר מאוד מוגבל של תווים.
בין המגבלות המשמעותיות שחווינו בפרויקט זה היה איכות המצלמה. רצינו לבצע את הפרויקט עם כמה שפחות משאבים ושיהיה שווה לכל כיס, ולכן היה צריך להשתמש במודל מצלמה לא יקר. בנוסף מפאת חוסר הזמן נאלצנו להשתמש בפרוטוקול UART בין ה-FPGA למחשב שהוא יחסית איטי מה שגרם לזמני המתנה ארוכים לזיהוי של כל תו. זמן נוסף בפרויקט היה גורם לנו לנסות להשתמש בפרוטוקולים חדשים ומהירים )כמו SPI ) לשליחת התמונה מה שהיה יכול לקצר מאוד את זמני הזיהוי עבור כל תו. בנוסף, לשם הפשטות החלטנו לוותר על השימוש ב-SPI בפרויקט עבור התקשורת בין המחשב ל-.Arduino

### 4.2 מימוש-

בפרויקט שלנו יש ארבעה חלקים מרכזיים: .1 ערכת פיתוח מבוססת FPGA- אחראית על הגדרת המצלמה ,צילום, הצגת התמונה במסך ושמירת התמונה בזיכרון הפנימי של ה-FPGA וכן שליחת התמונה דרך פרוטוקול ה-UART אל המחשב.
.2 GUI מבוסס פייתון- אחראי על ממשק המשתמש, קבלת התמונה מה-FPGA שליחת התמונה אל הArduino וזיהוי התו שצולם. .3 Arduino- אחראי על קבלת התמונה דרך הUART והפקת הצלילים בהתאם לתמונה. .4 7670OV מודל מצלמה שאחראי על הפקת התמונה ושליחתו דרך קווי המידע )להוסיף פרוטוקול( אל ערכת הפיתוח.

בפרק זה נפרט על כל חלק ונתאר איך הוא בנוי ואיך הוא מתחבר לשאר הרכיבים בפרויקט.

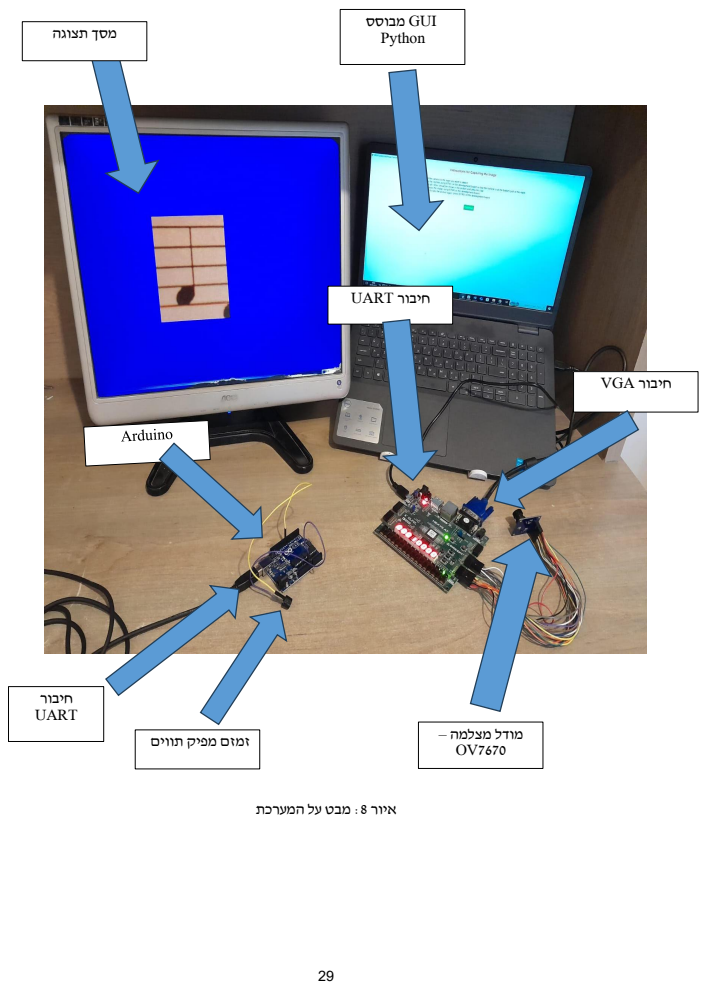
[picture p8: page 29]
מודל מצלמה – OV7670; חיבור VGA; מסך תצוגה; GUI מבוסס Python; חיבור UART

זמזם מפיק תווים

איור :8 מבט על המערכת

### 4.2.1 ערכת פיתוח מבוססת FPGA 4.2.1.1 דיאגרמת בלוקים

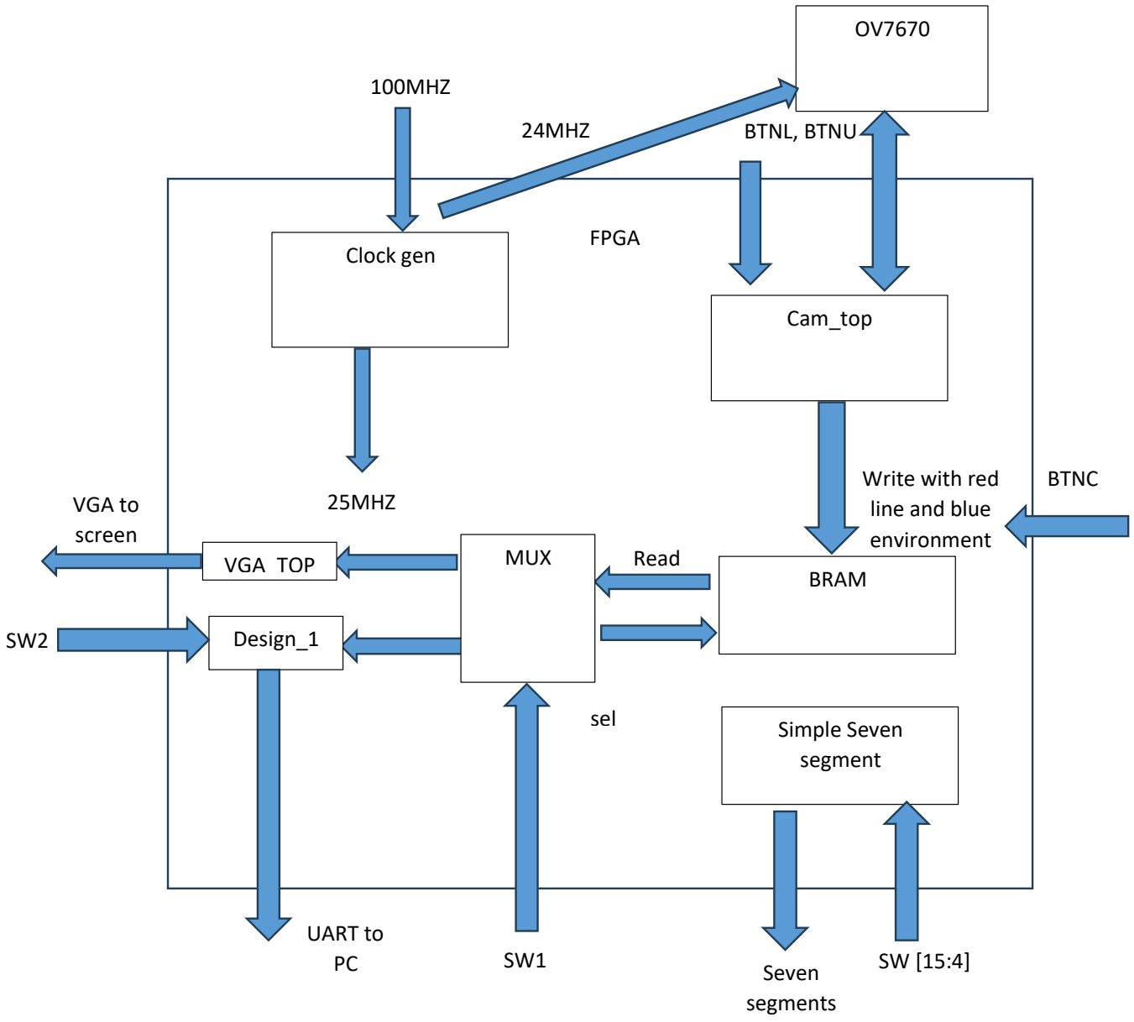
[picture p9: figure]
Cam_top; BRAM; MUX VGA_TOP; Design_1; VGA to screen; UART to PC; Write with red line and blue environment; Read; sel; Clock gen; 100MHZ; 24MHZ; 25MHZ; BTNL, BTNU; BTNC; Simple Seven segment; Seven segments; FPGA

איור :9 דיאגרמת בלוקים

### 4.2.1.2 תיאור שעונים:

בפרויקט קיימים שני domains clock. הראשון הוא domain clock של MHz100 שאיתו עובד החלק של המצלמה ב-FPGA והכתיבה ל-.BRAM

השני הוא domain clock של MHz25 שאיתו עובד החלק של ה-VGA והקריאה מה-BRAM. קיים שעון נוסף בפרויקט שהוא של MHz24 שהולך אל מודל המצלמה מחוץ ל-FPGA.

### 4.2.1.3 תיאור חלקי ה-FPGA:

4.2.1.3.1 מודל המצלמה 7670OV – מודל Verilog שמבוסס על קוד שפורסם בgit.

מודל זה אחראי על אתחול המצלמה מסוג 7670OV באמצעות פרוטוקול
.)I2C של | גרסה | )SCCB
גם מודל זה מחולק לכמה חלקים.: 4.2.1.3.1.1 init_cam –מודל שאחראי על שליחת ההגדרות הרצויות לרכיב המצלמה.

חלק זה בנוי משלושה תתי חלקים: א. זיכרון ROM שתפקידו לאחסן את הגדרות האתחול של המצלמה.
ב. מודל config שתפקידו לשלוף את הערכים מה-ROM ולשלוח למודל
ה- SCCB.
ג. מודל ה- SCCB מנהל את השליחה בפועל אל מודל המצלמה דרך קו
.SIO_C | השעון | וקו SIO_D | הנתונים
באופן כללי המודל עובד כך שהוא מחכה לאות start_init_cam_i ולאחר מכן המודל מחכה שהמודל SCCB יאותת כשהוא מוכן. רק לאחר מכן המודל יתחיל לקחת את ההגדרות השמורות ב- ROM ולשלוח אותם למודל המצלמה.
לאחר שכל ההגדרות נשלחו האות done_init_cam_o עולה ל-'1' מה שמעיד על סיום שלב ההגדרה של המצלמה.
בפרויקט שלנו done_init_cam_o מחובר ל- 1LED בערכת הפיתוח והדלקה שלו מעידה על כך ששלב הגדרות המצלמה הסתיים והמצלמה מוכנה לשימוש.

### 4.2.1.3.1.2 capture_cam – חלק זה מקבל את נתוני הפיקסלים מהמצלמה וממפה אותם

לכתובות בזיכרון ה-BRAM שנמצא ב-FPGA. המודל מתחיל לפעול לאחר סיום האתחול של המצלמה שתואר קודם. הוא כולל מכונת מצבים המורכבת מארבעה מצבים: init_Cam- המתנה לאתחול המצלמה וקליטת פריים חדש מהמצלמה. במודל זה קיימת מכונת מצבים נוספת אשר בוחרת על פי לחצני BTND( מעבר למצב וידאו( ולחצן BTNR( מעבר למצב סטילס-צילום התמונה( את מעברי המצבים במכונת המצבים הראשית שתוארה מוקדם יותר.
4.2.1.3.2 debouncer מודל לסינון רעשים המשמש עבור הלחצנים BTND ו- BTNR.

מטרת מודל זה הוא לוודא שהשינוי בלחצן הוא "אמיתי" ואינו זמני או שנגרם כתוצאה מרעש על הקו.
מודל זה משתמש ב-DELAY של מספר מחזורי שעון )240,000 במקרה שלנו( כאשר אם המצב של הלחצן שונה מהמצב האחרון שהוא שהה בו למספר מחזורי השעון כמו ב-DELAY מכניסים את הערך של הלחצן אל היציאה של המודל וזהו הערך האמיתי של הלחצן שאיתו משתמשים במודל המצלמה.
ה-debouncer במודל זה מוגדר ל-ms.2.4

כלומר שינוי ברמת הקלט תתקבל רק אם המשתמש לחץ על הלחצן למשך ms2.4 ויותר.

### 4.2.1.3.3 TOP_VGA - מודל שנלקח מה- git שתפקידו לקרוא את הנתונים מה-BRAM

ולהמיר אותם לנתונים בפרוטוקול VGA. מודל זה מארגן תזמון תצוגת הווידאו ואת קריאת הפיקסלים מהזיכרון לאורך הצגת התמונה. מודל זה משתמש במודל אחר שנקרא timing_vga שתפקידו לספק תזמון VGA תקני לפורמט )640x480 )שבו אנו משתמשים בפרויקט. בסטנדרט VGA תקני יש כמה שלבים חוץ משלב בתצוגה שבו נתוני הפיקסל האמיתיים של התמונה.
מודל ה- timing_vga מספק את הקואורדינטות של כל פיקסל כך שניתן לדעת מתי יש אות וידאו תקף ומתי הפיקסל שייך לשוליים או לסנכרון. לפי מודל זה מודל ה- top_vga יודע מתי יש לשלוח נתוני תמונה ומתי יש לשלוח אותו סנכרון וכך ניתן לדעת מתי ניתן לקרוא נתונים מה-BRAM. גודל יציאת bus הנתונים של המודל הוא 12 סיביות שמורכבות מארבע סיביות לכל צבע מבין אדום, ירוק וכחול וכך מורכב הפיקסל השלם שנשלח למסך התצוגה ובו גם אנחנו נשתמש לשם זיהוי התו המוסיקלי.
4.2.1.3.4 1 design – מודל מבוסס Microblaze שהוא ליבת מעבד שתפקידה בפרויקט הוא לקבל את נתוני הפיקסלים ולשלוח אותם למודל ה-UART_AXI שמקבל את נתוני הפיקסלים דרך פרוטוקול )Mapped Memory AXI (MM_AXI ושולח אותם דרך פרוטוקול UART אל המחשב.
ה-Microblaze הוא בסופו של דבר ליבת מעבד לכן הוספנו לפרויקט קוד C שרץ על ה Microblaze והוא זה שאחראי על העברת הנתונים אל ה-UART AXI דרך דרייברים מובנים שמסופקים עם אפליקציית Vitis שזוהי הסביבה שעליה נכתב קוד ה- C. בשל שיקולי זמן והאיטיות היחסית של ה-UART החלטנו שהתמונה הנשלחת תהיה קטנה יותר מגודל ה- frame בפרוטוקול ה-VGA שבחרנו. כלומר במקום לשלוח אל המחשב נתוני פיקסלים של 640x480 פיקסלים אנו שולחים רק נתונים רק של 200x170 וכך אנו חוסכים זמן שליחה יקר. עוד לפני השליחה הקוד ממתין ל2-SW בערכת הפיתוח שיהיה ב-'1' ורק לאחר מכן מתחילה הקריאה מה-BRAM ושליחת הנתונים אל ה-UART.ה-MICROBALZE קורא ערכים מה-BRAM שם נשמרת התמונה אך ורק מכתובות שם נמצאת התמונה ורק אותן הוא שולח לUART. לאחר סיום קריאה ושליחת הערכים הרלוונטיים דרך ה-UART יש המתנה ל4-SW שיהיה ב-'1' וזה מסמן על תמונה חדשה שצריכה להישלח ושוב מחכים ל- 2SW שיהיה ב-'1' ושליחה של תמונה נוספת תתחיל לאחר מכן ה MICROBLAZE מקבל את ערכי נתוני החומרה )4SW2,SW )ושולח אל נתוני החומרה דרך CORE IP של חברת Xilinx שנקרא GPIO AXI.ב-IP זה הנתונים מועברים דרך פרוטוקול MM-AXI שממפה את נתוני החומרה אל כתובות AXI שאליהם ניתן לגשת דרך המעבד בקלות. כלומר, כדי לקרוא את מצב ה-SW נצטרך לקרוא מכתובת מסוימת דרך קוד ה- C וכדי לשלוט על רכיבי חומרה אחרים )לדוגמה LEDS )נצטרך לכתוב לכתובות מסוימות שאליהן מופו ה-LEDS. מיפוי הכתובות מתבצע דרך tab ה-Editor Address ביצירת הdesign block ב- Vivado. ה-MICROBLAZE שלנו שולט גם על כמה LEDS: 1LED - חיווי שקוד ה- C עלה בצורה תקינה. 2LED- חיווי שמתבצעת שליחה של נתוני התמונה. 3LED- חיווי ששליחת נתוני התמונה אל המחשב הסתיימה.

### 4.2.1.3.5 segment_seven_simple- מודל זה נועד להציג 8 ספרות על 2 מסכי ה seven

segment בערכת הפיתוח בסדר הבא: 4 הספרות הימיניות מציגות את הערך הדצימלי של [15:5]SW וזה נועד לחיווי מספר התמונות אותם רוצים לצלם.
4 הספרות השמאליות מציגות את ערך התמונה הנוכחית שמנותחת. ערך זה עולה בכל עלייה של 4SW.
במודל זה קיים גם debouncer בשביל 4SW שפועל כמתואר קודם, אך עם DELAY של 1,000,000 מחזורי שעון.
כלומר ms.10

### 4.2.1.3.6 generator Signal- מודל שנועד לייצור אות שעולה בקפיצות של 10 בכל פעם שיש

עלייה בלחצן BTNC בערכת הפיתוח. כאשר עוברים את 340 שהוא הקו התחתון של התמונה חוזרים חזרה לתחילת התמונה שהיא 140 )גבולות התמונה האמיתיים ללא הרקע הכחול(. לשם זיהוי התו במחשב יש לשלוח תמונה שבה יש קו אדום מתחת לתו המוזיקלי. בפרויקט שלנו אנו נותנים הוראה למשתמש למקם את הקו האדום שנוצר בתמונת הווידאו מתחת לתו המצולם.
כדי שלמשתמש תהיה גמישות מרבית במיקום הקו יש לו אופציה לשנות את מיקום התו בתוך התמונה שהוא מצלם וזה קורה דרך המודל הזה.

### 4.2.1.3.7 BRAM- זיכרון פנימי בתוך ה-FPGA שנועד לשמור את נתוני הפיקסלים של

התמונה המצולמת.
ערכי הנתונים שנשלחים אל ה-BRAM נבחרים דרך MUX שנשלט על ידי ערך הכתובת ב-.BRAM
אם ערך הכתובת הוא באחד בין ערכי התמונה האמיתיים נשלח אל ה-BRAM הערך שהגיע מהמצלמה.
אם ערך הכתובת הוא בערך אחד מהערכים התקניים של הקו האדום נשלח פיקסל בצבע אדום בלבד )כך נוצר קוד אדום אנכי שתואר בסעיף הקודם(. אם ערך הכתובת אינו בין ערכי התמונה האמיתיים )170-340 עבור ערכי ה-x ו- 140-340 עבור ערכי ה-y )נשלח אל ה-BRAM פיקסל בצבע כחול בלבד. כך מתקבלת תמונה שמורכבת מרקע בצבע כחול, תמונה מהמצלמה וקו אדום)ניתן לראות דוגמה באיור 8(.
שינוי זה נעשה כדי לחסוך זמן יקר בשליחת התמונה למחשב. אנו שולחים אל המחשב רק את התמונה ללא הרקע הכחול לכן אנו שולחים פחות פיקסלים וזמן זיהוי התו הכולל מתקצר.
היעד של הנתונים הנשלחים מה-BRAM נבחרים על ידי MUX שנשלט על ידי 1SW. אם 1SW נמצא ב-'0' הנתונים יישלחו אל המודל ה-VGA והתמונה תופיע על מסך התצוגה. אם 1SW נמצא ב-'1' הנתונים יישלחו אל מודל ה-wrapper_design ונתוני התמונה )ללא הרקע הכחול אך כולל הקו האדום( יישלחו דרך ה-UART אל המחשב.

### 4.2.1.3.8 detector edge Rising- - מודל שתפקידו לזהות עלייה של signal ודרכו לבצע

פקודת read מה- BRAM.

דרך קוד ה-C אנו גורמים לעלייה של סיגנל זה אך אנו רוצים לקרוא כל פעם רק מכתובת אחת לכן יש צורך לזהות עלייה שכזאת ושהסיגנל ביציאה שקורא מה- BRAM יהיה ב-'1' למחזור שעון אחד בלבד.
100MHz | בתדר | clock | לקבל | שנועד | Xililnx | חברת | של IP CORE -Clock gen 4.2.1.3.9
ולייצר שני שעונים חדשים בתדרים של:MHz25 עבור ה-DOMAIN VGA ו-MHz24 עבור מודל המצלמה החיצוני.
4.2.1.3.10 ILA- CORE IP של חברת Xilinx הנועד ל-debug של סיגנלים מסוימים.

פועל כמעין סקופ דיגיטלי.

### 4.2.1.3.11 תיאור לחצנים, LEDS ו-SW בשימוש בערכת הפיתוח פרויקט:

| שם תפקיד
| BTNC שולט במיקום הקו האדום בתמונה
| BTNR צילום תמונה
| BTNL התחלת הגדרות מודל המצלמה
| BTND מעבר מצב מסטילס לוידאו
| BTNU אתחול מודל המצלמה
| 0LED סיום אתחול מודל המצלמה
| 1LED טעינה מוצלחת של ה-FPGA
המחשב | 2LED התחלת שליחת נתוני התמונה אל
| 3LED סיום שליחת נתוני התמונה אל המחשב
ל-VGA(0). | 1SW בחירה בין שליחת נתונים למחשב)1( או
| 2SW התחל בשליחת נתוני התמונה למחשב
| 4SW העלה את מונה התמונות ב1-
| 15-5SW שליטת בתצוגת ה-segment 7

טבלה :1 תיאור לחצנים, LEDS ו- SW בשימוש בערכת הפיתוח פרויקט

:Python | מבוסס | GUI 4.2.2

ממשק משתמש שנועד להדריך את המשתמש להשתמש באופן נכון בפרויקט שלנו. אנו משתמשים בספריית tkinter לשם יצירת ממשק המשתמש. תיאור המסכים ב-GUI:

4.2.2.1 מסך -1פתיחה- מסך פתיחה יש ללחוץ Start כדי להתחיל.

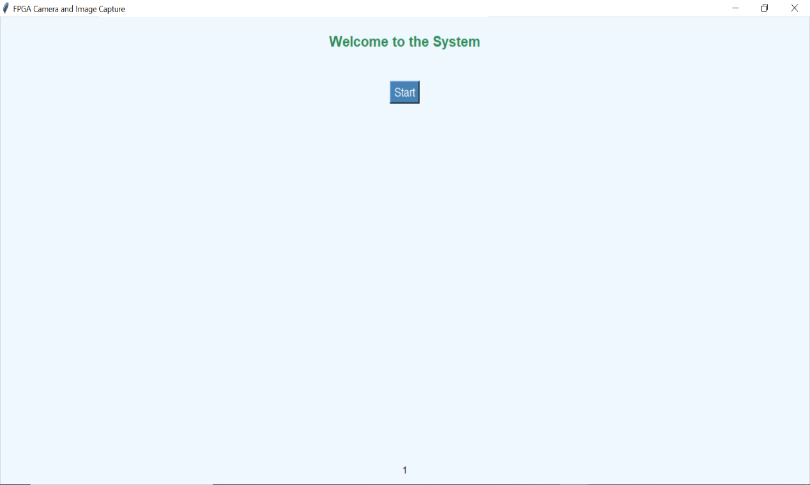
[picture p10: figure]

איור :10 מסך 1 - פתיחה

### 4.2.2.2 מסך 2 – UP Power- הדלקת ערכת הפיתוח והמתנה ל- 1 LED שיהיה דלוק

)נותן חיווי על טעינה מוצלחת של הערכה( לאחר מכן יש ללחוץ על BTNL אמורה להתחיל את כתיבת ההגדרות למצלמה.
לעיתים ה-FPGA אינו נטען כראוי ואז יש ללחוץ על לחצן PROG בערכת הפיתוח לטעינה חוזרת שלו. ה-bitfile שהוא קובץ הצריבה של ה-FPGA נמצא ברכיב FLASH בערכת הפיתוח כך שלחיצה של PROG גורמת לטעינה שלו מחדש.

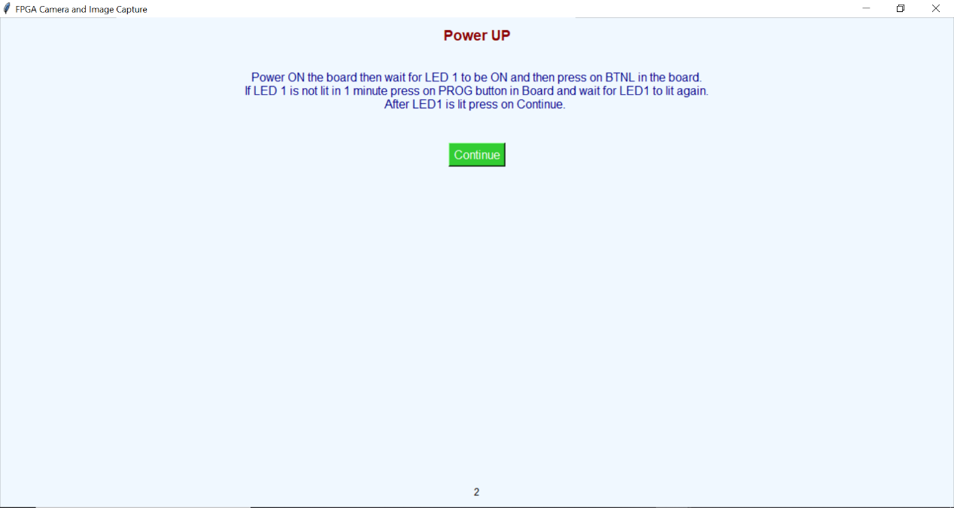
[picture p11: figure]

איור :11 מסך 2 – UP Power

### 4.2.2.3 מסך -3 שאלה למשתמש- שאלה האם רואים את התמונה על המסך. אם כן

מתקדמים הלאה.

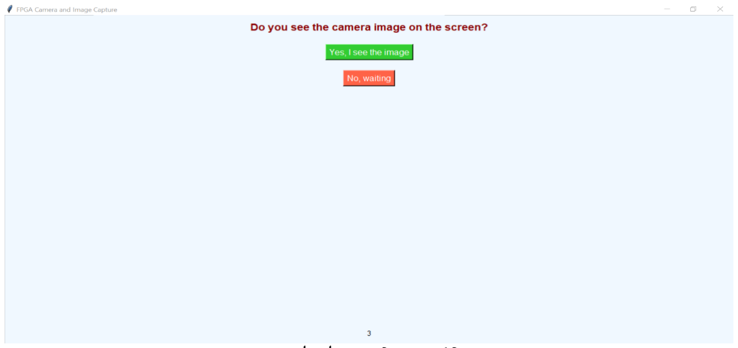
[picture p12: figure]

איור :12 מסך 3 - שאלה למשתמש

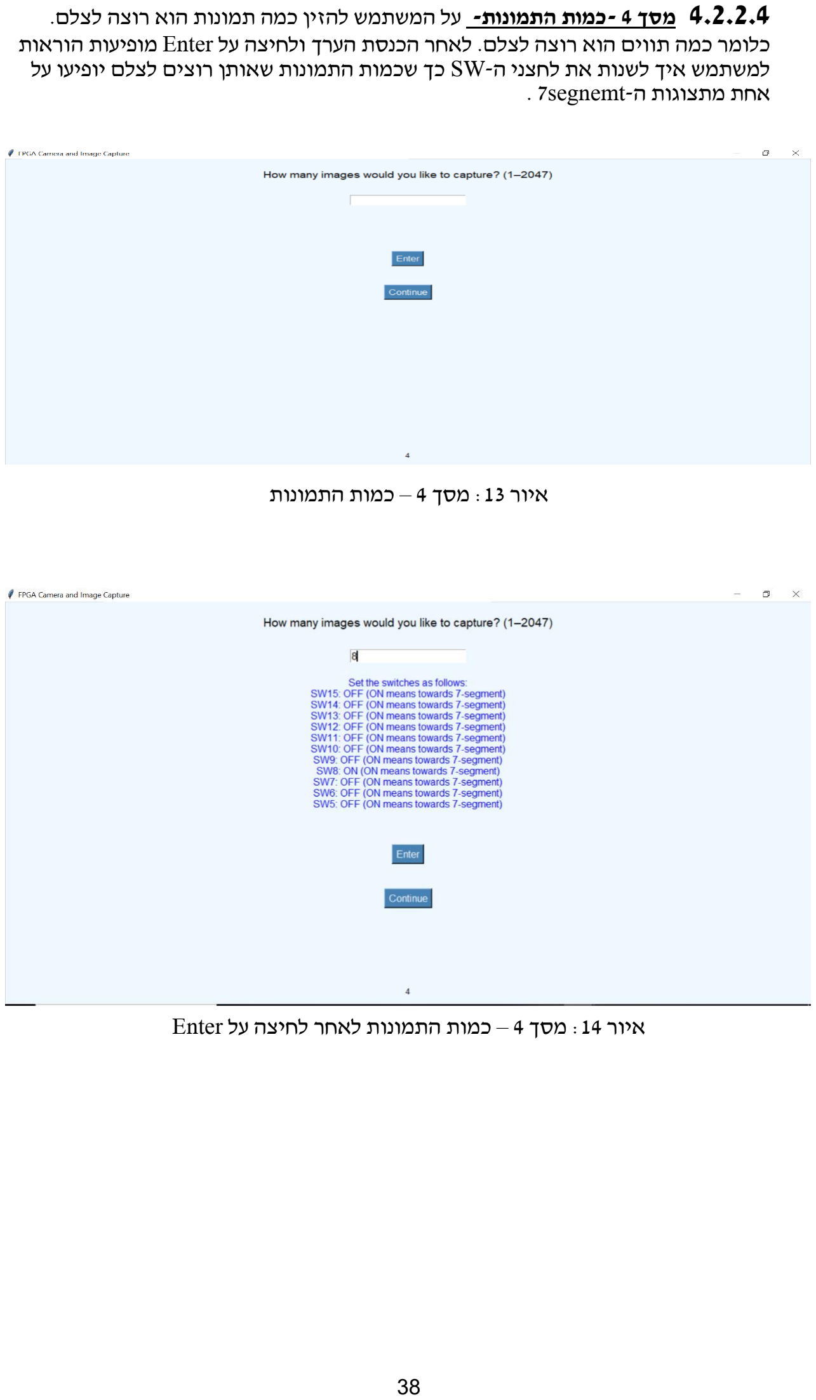
[picture p13: page 38]

4.2.2.4 מסך 4 -כמות התמונות- על המשתמש להזין כמה תמונות הוא רוצה לצלם. כלומר כמה תווים הוא רוצה לצלם. לאחר הכנסת הערך ולחיצה על Enter מופיעות הוראות למשתמש איך לשנות את לחצני ה-SW כך שכמות התמונות שאותן רוצים לצלם יופיעו על אחת מתצוגות ה-segnemt7 .

איור :13 מסך 4 – כמות התמונות

איור :14 מסך 4 – כמות התמונות לאחר לחיצה על Enter

### 4.2.2.5 מסך -5הוראות לצילום התמונה- מסך זה נותן דגשים לצילום התמונה. יש לכוון

את הקו האדום דרך לחצן BTNC בערכת הפיתוח כך שהקו האדום יופי מתחת לתו המצולם. לחיצה על BTNR תגרום לצילום התמונה. אם המשתמש לא מרוצה מהתמונה שצילם הוא יכול ללחוץ על BTND כדי לחוזר למצב ווידאו וצילום.

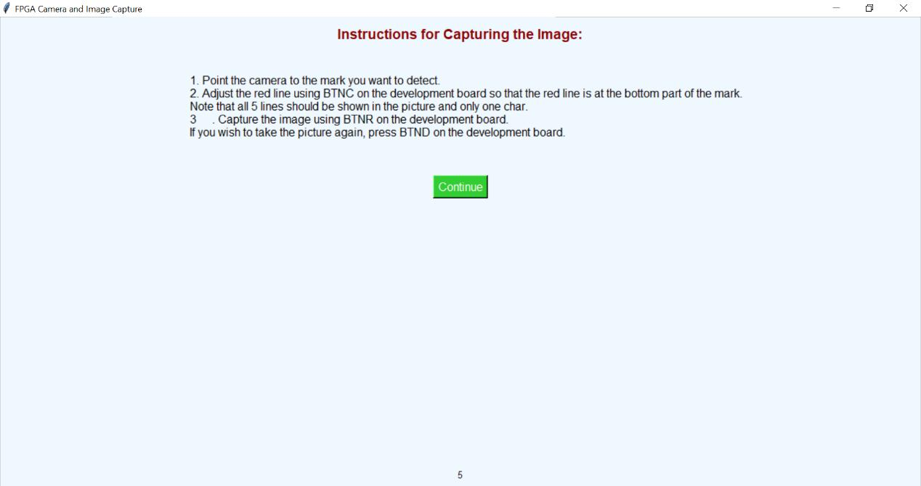
[picture p14: figure]

איור :15 מסך 5 – הוראות לצילום התמונה

### 4.2.2.6 מסך -6 הגדרות- במסך זה יש הוראות למשתמש כיצד להגדיר את תוכנת ה-

PuTTy שמקליטה את נתוני ה-UART שמגיעים אל המחשב מה-FPGA.נתוני ה-UART מכילים את התמונה שהמשתמש צילם. במסך זה על המשתמש להגדיר ל-PuTTy לכתוב את כל הנתונים שמתקבלים בקובץ. קובץ זה ישמש אותנו מאוחר יותר לזיהוי התו לפי נתוני הפיקסלים שמתקבלים. לאחר סיום ההגדרות על המשתמש לשנות את מצב 1sw לכיוון הלחצנים מה שיסמן ל-FPGA לשלוח נתונים אל ה-UART ולא אל ה-VGA.

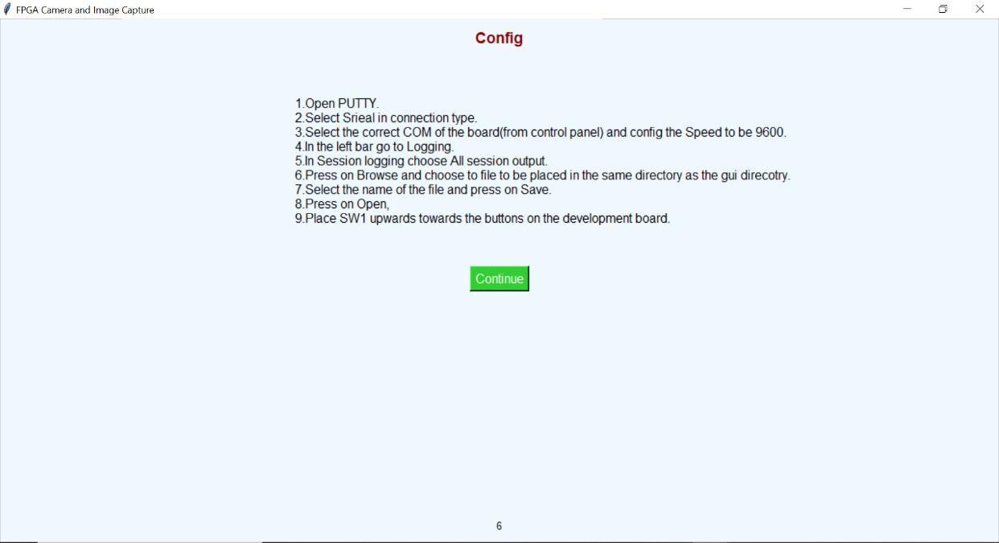
[picture p15: figure]

איור :16 מסך 6 – הגדרות

### 4.2.2.7 מסך -7 הרצת ויטיס- במסך זה על המשתמש לשנות את מצב 2sw לכיוון

הלחצנים מה שיסמן ל- Microblaze שבתוך ה-FPGA להתחיל לשלוח את נתוני התמונה אל המחשב דרך ממשק ה-UART. תהליך זה נמשך בערך 15 דקות ולאחר שהתהליך נגמר 3led נדלק ועל המשתמש לסגור את חלון ה-PuTTy. בשלב זה יש לנו קובץ טקסט עם נתוני הפיקסלים של התמונה שהמשתמש צילם.

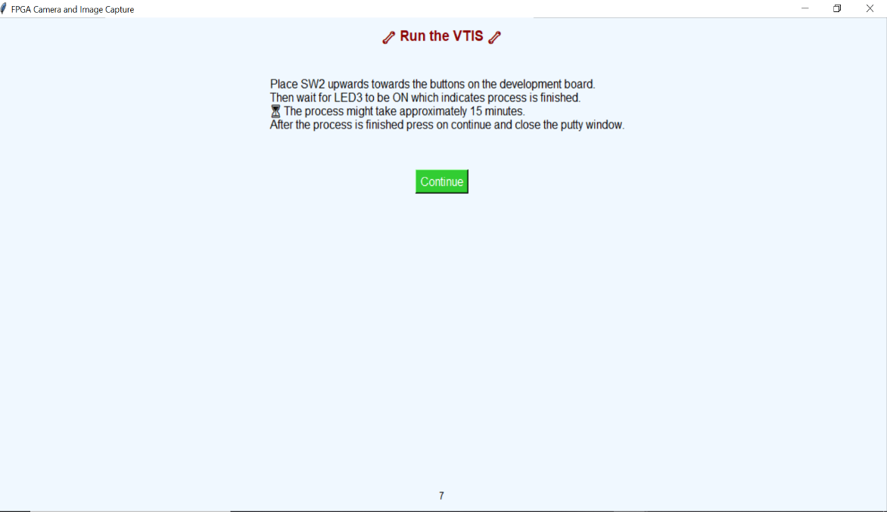
[picture p16: figure]

איור :17 מסך 7 – הרצת ויטיס

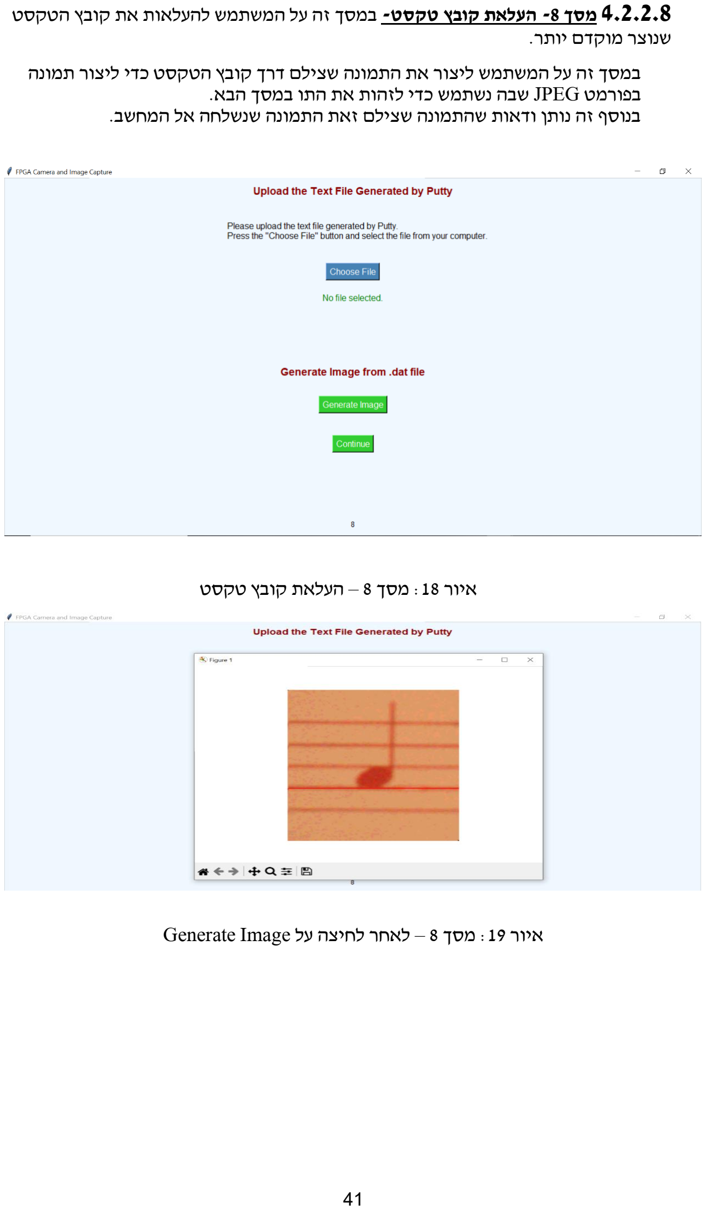
[picture p17: page 41]

### 4.2.2.8 מסך -8 העלאת קובץ טקסט- במסך זה על המשתמש להעלאות את קובץ הטקסט

שנוצר מוקדם יותר.
במסך זה על המשתמש ליצור את התמונה שצילם דרך קובץ הטקסט כדי ליצור תמונה בפורמט JPEG שבה נשתמש כדי לזהות את התו במסך הבא. בנוסף זה נותן ודאות שהתמונה שצילם זאת התמונה שנשלחה אל המחשב.

איור :18 מסך 8 – העלאת קובץ טקסט

איור :19 מסך 8 – לאחר לחיצה על Image Generate

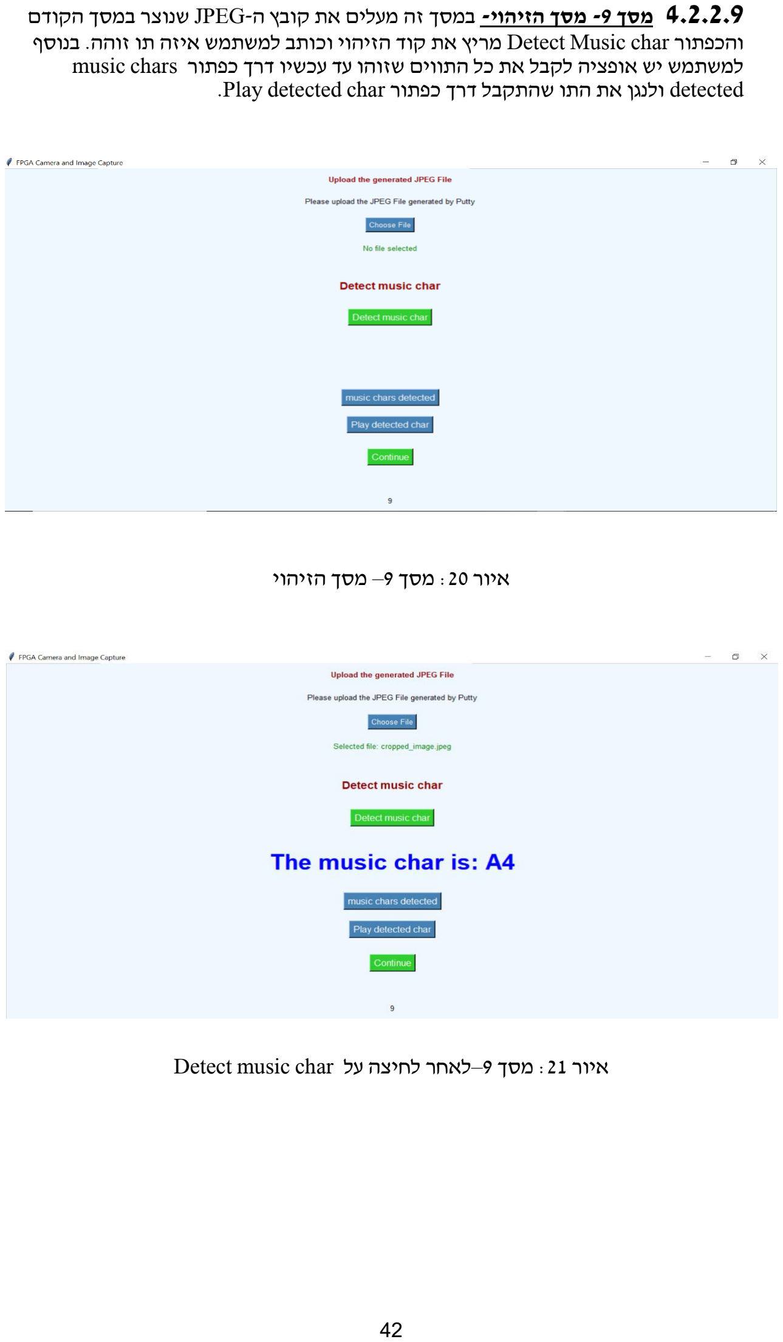
[picture p18: page 42]

### 4.2.2.9 מסך -9 מסך הזיהוי- במסך זה מעלים את קובץ ה-JPEG שנוצר במסך הקודם

והכפתור char Music Detect מריץ את קוד הזיהוי וכותב למשתמש איזה תו זוהה. בנוסף למשתמש יש אופציה לקבל את כל התווים שזוהו עד עכשיו דרך כפתור chars music detected ולנגן את התו שהתקבל דרך כפתור char detected Play.

איור :20 מסך 9– מסך הזיהוי

איור :21 מסך 9–לאחר לחיצה על char music Detect

מנגנון זיהוי התו:
לאחר קבלת התמונה מה FPGA שמכילה את התו עם הקו האדום כקובץ טקסט ושחזורה נעשה החלק של זיהוי התו. על מנת לבצע פעולה זו כתבנו קוד פייתון שמשתמש בעיקר בספריות 2cv ו .numpy
תחילה שחזרנו את התמונה מהקובץ טקסט. לאחר מכן העברנו את התמונה לפורמט בינארי ועשינו לה טשטוש גאוסייני על מנת להקל על הזיהוי. בשלב הבא יצרנו פונקציה שתזהה את חמשת הקווים השחורים בתמונה ותשים את הערכים של הגבהים שלהם במערך בערך חמישה איברים. קריאת הפונקציה נראית כך: staff_lines = find_and_filter_staff_lines(binary, max_lines=5) כש binary היא התמונה הבינארית לאחר הטשטוש. לאחר מכן השתמשנו בפונקציה sum של numpy שסוכמת את כל הערכים בציר שניתן לה. אנו השתמשנו ב 1=axis, כלומר ציר אופקי. projection = np.sum(binary_image, axis=1) הצעד הבא הוא זיהוי השורה עם הערך הכי גבוה ודרישה שהקווים יהיו לפחות 70% מהאינטנסיביות של אותה שורה, אותם אנו שומרים כקווים פוטנציאלים. threshold = 0.7 * np.max(projection) potential_lines = np.where(projection > threshold)[0] החלק הבא בקוד נועד לשלב בין קווים שנמצאים ברצף אחד אחרי השני, שהרי אם הם נמצאים ברצף מבחינת השורות של התמונה ניתן להסיק שמדובר בקו אחד עבה שתופס כמה שורות וצריך להתייחס אליו כאל קו אחד.
דבר דומה נעשה גם לאחר מכן כשאנו למעשה מחשבים את המרחק הממוצע בין שורות ומורידים שורות אם הן נמצאות בפחות מ 60% מהמרחק הממוצע, כך אנו נמנעים מזיהויים שגויים. בנוסף זה יכול לעזור להימנע מזיהוי הקו האדום שבלאו הכי הסיכוי יוסף לפונקציה הזאת קטן מאחר שהאינטנסיביות שלו לאחר ההמרה לבינארי קטנה באופן ניכר מהקווים השחורים. לבסוף אנו אוספים את הקווים עד שמגיעים לחמישה ערכים. הפונקציה הבאה היא זיהוי הקו האדום. לפונקציה זו אנו מעבירים את התמונה בפורמט RGB שנוצרת לאחר שיחזור התמונה: image = cv2.imread(uploaded_filename) בפונקציה עצמה תחילה אנו משנים את התמונה מ RGB ל HSV, זאת מכיוון שקל יותר לזהות צבעים בפורמט HSV שמייצג באופן ישיר את הצבע )מייצג גוון, רוויה וערך. הצבע יהיה לפי הגוון(. הצבע אדום נמצא בערכים שבין 0-10 וגם ב .170-180 בנוסף דרשנו שהרוויה תהיה בין 70-255 והערך 50-255 כך שנבטיח שזה יהיה צבע אדום בולט. לאחר מכן שינינו מחדש את התמונה כל שהאזור האדום נהיה לבן וכל השאר שחור, כך לאחר מכן זיהינו את גובה הקו. בשלב זה יש לנו משתנה אחד שמכיל את גובה חמשת הקווים השחורים ומשתנה אחר שמכיל את גובה הקו האדום. כעת נותר לנו להשתמש בעוד פונקציה אחת שתבע את התו לפי המיקום של הקו האדום ביחס לקווים השחורים. בפונקציה זו אנו תחילה מצהירים על מערך שמכיל את כל שמות התווים אותם אנו מצפים לקבל, מהגבוה לנמוך. בכל פעם אנו בודקים אם הקו האדום נמצא מתחת לקו השחור אותו אנו בודקים ולפי כך מתקדמים במערך. אם הקו האדום נמצא בין שני קווים אנו בודקים את המיקום היחסי שלו ולפי כך מחליטים אם הקו צריך להיות ביניהם או שמדובר בסטייה קלה.

4.2.2.10 מסך -10 מסך החלטה- במסך זה מספר הוראות הקשורות לערכת הפיתוח.

מעבר ל-OFF של 1SW ו2-SW מחזיר אותם לערכים ההתחלתיים שלהם לפני הזיהוי. עלייה וירידה של 4SW גורם לעלייה של מונה התמונות ב-segment 7 ולחיצה על BTND מחזירה את המצלמה למצב וידאו. לאחר מכן המשתמש אמור לראות תמונת וידאו על מסך התצוגה המחובר ל-VGA. על המשתמש לבחור אם המספר בתצוגת ה-segment 7 הימני גדול מהמספר בתצוגת ה- 7 segment השמאלי.
אם לא, יש להמשיך לתמונה הבאה ומתבצעת חזרה למסך .5 אם כן, יש מעבר לחלון הבא.

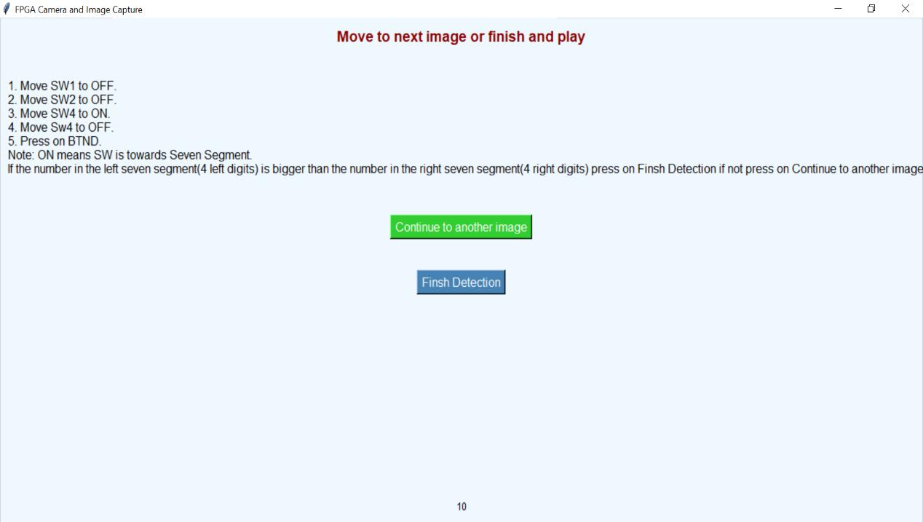
[picture p19: figure]

איור :22 מסך 10 – מסך החלטה

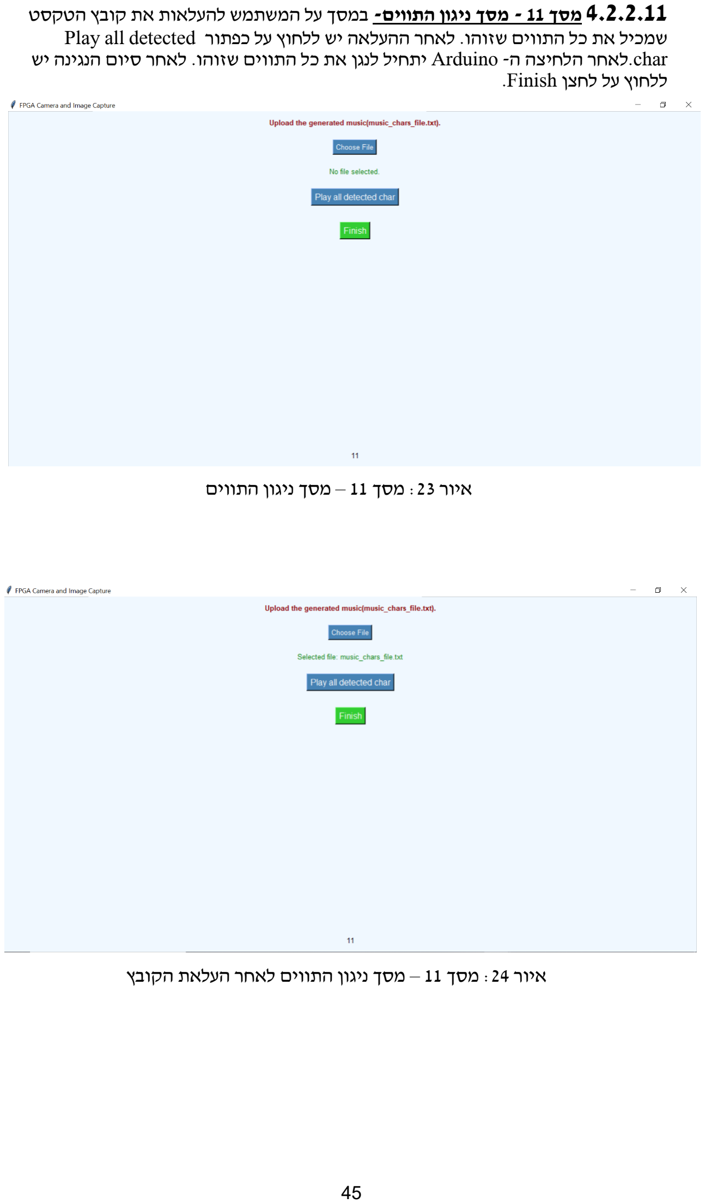
[picture p20: page 45]

### 4.2.2.11 מסך 11 - מסך ניגון התווים- במסך על המשתמש להעלאות את קובץ הטקסט

שמכיל את כל התווים שזוהו. לאחר ההעלאה יש ללחוץ על כפתור detected all Play char.לאחר הלחיצה ה- Arduino יתחיל לנגן את כל התווים שזוהו. לאחר סיום הנגינה יש ללחוץ על לחצן Finish.

איור :23 מסך 11 – מסך ניגון התווים

איור :24 מסך 11 – מסך ניגון התווים לאחר העלאת הקובץ

4.2.2.12 מסך 12 - מסך פרידה- סיום התהליך וברכת Goodbye על המסך.

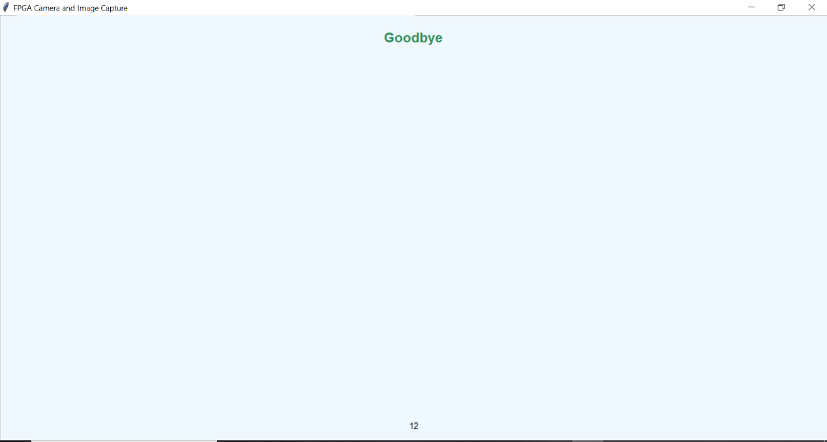
[picture p21: figure]

איור :25 מסך 12 – מסך פרידה

Arduino 4.2.3

פלטפורמה מבוססת מיקרובקר שתפקידה בפרויקט שלנו הוא לקבל דרך פרוטוקול UART את נתוני התווים שזוהו ודרך זמזם לנגן אותם. הזמזם מחובר ל8-PIN ול-GND והוא יודע להפיק תווים על פי התו שנשלח אליו. אנו שולח ב-UART את התו שזוהה אל הארדואינו שם הארדואינו שולח לזמזם את התו שזוהה ואנו שומעים את התווים שזוהו.

בקוד הארדואינו אנו תחילה מעניקים לשמות התווים את התדרים המתאימים באמצעות define #define B3 247
#define C4 262

#define D4 294

לאחר מכן אנו בודקים שנשלח מידע. במידה וכן אנו שומרים אותו במשתנה data. if (Serial.available() > 0) {
data = Serial.readStringUntil('\n'); // Read until newline

לבסוף אנו מנגנים את התו באמצעות הפונקציה tone. משך התווים מוגדר בקוד כחצי שנייה.

4.2.4 7670OV – מודל מצלמה דיגיטלית שמיועד ללכידת תמונות ווידאו ברזולוציה של 640*.480 בפרויקט שלנו אנו משתמשים במודל זה כדי לצלם את התו שברצוננו לזהות. המודל מתחבר ל-FPGA דרך קווי data- 8 ביט עבור זרם המידע וממשק SCCB להגדרות המצלמה. בנוסף קיימים קווי סנכרון, שעון ו-reset של המודל המחוברים ל-FPGA. שיקול מרכזי בבחירת מודל זה עבור הפרויקט שלנו היה מחיר יחסית נמוך שימוש נפוץ בפרויקטים אחרים מה שגורם למידע רב באינטרנט על המודל הזה וכמובן מודל ב-git עבור ההגדרה וההפעלה של המצלמה מה שהקל עלינו את עומס העבודה בפרויקט.

### 4.2.5 תרשים זרימה של הפרויקט:

פתיחת ממשק המשתמש

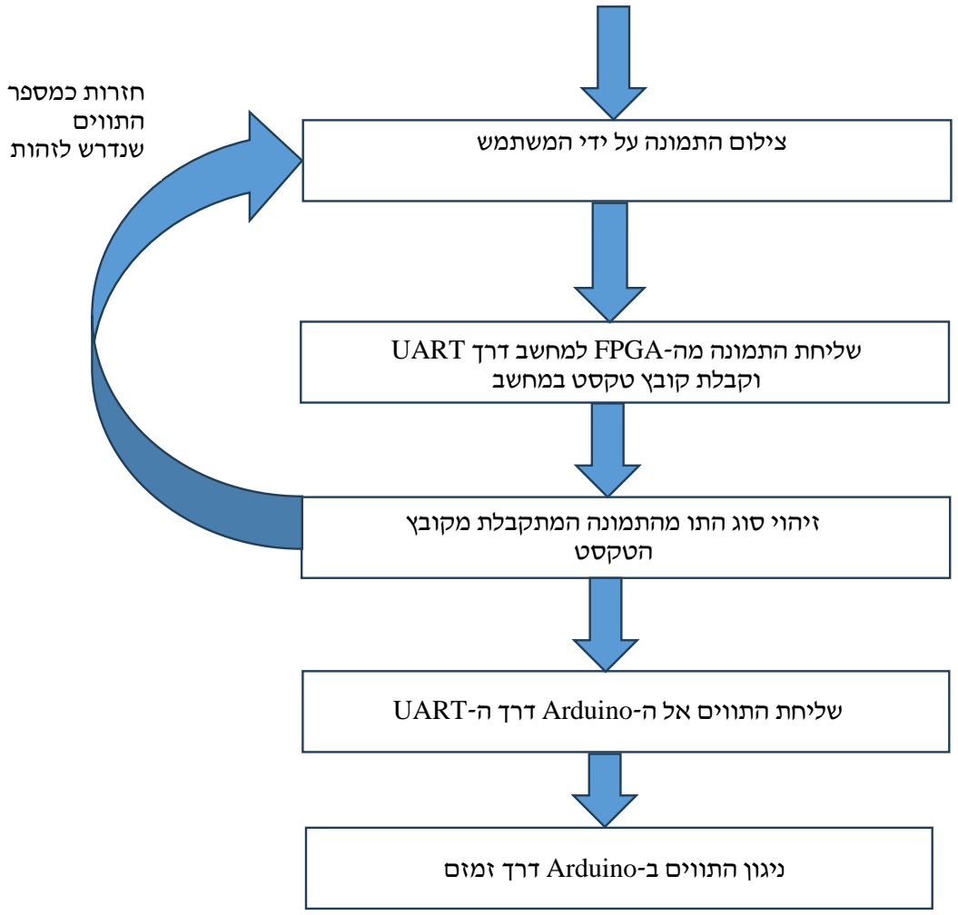
[picture p22: figure]
צילום התמונה על ידי המשתמש; שליחת התמונה מה-FPGA למחשב דרך UART וקבלת קובץ טקסט במחשב; זיהוי סוג התו מהתמונה המתקבלת מקובץ הטקסט; חזרות כמספר התווים שנדרש לזהות; ניגון התווים ב-Arduino דרך זמזם; שליחת התווים אל ה-Arduino דרך ה-UART

איור :26 תרשים זרימה של הפרויקט

### 5 תוצאות:

בטבלאות למטה ניתן לראות תיבות שנבדקו ואת התוצאות של הזיהוי תווים.

הבהרה: בטבלאות הבאות וכן בכל הפרויקט עצמו השתמשנו בשמות הלועזיים של התווים. כך יוצא ש דו- C, רה- D, מי- E, פה- F, סול- G, לה- A, סי- B. בנוסף לכל תו מוצמד מספר שמסמן את מספר האוקטבה כשהדו האמצעי הוא באוקטבה הרביעית. מיותר לציין שהתדירות של התווים עצמם מגיעה מהשיטה המודרנית בה 4A, לה באוקטבה הרביעית, הוא Hz.440

ראשית נתחיל ברצף של מספר תווים שנלקחו לבדיקה ראשונית בנפרד.

תמונה של התיבות:

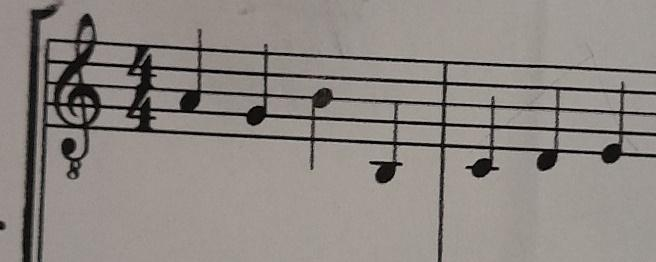
[picture p23: figure]

איור :27 רצף של תווים

| | | התמונה שנלקחה התו התו שזוהה התדר שנוגן

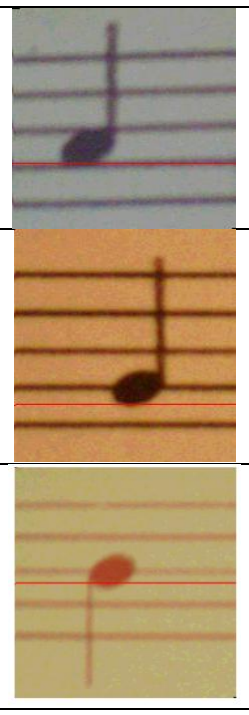
[picture p24: figure]

440Hz | A4 | A4
392Hz | G4 | G4
494Hz | B4 | B4

247Hz | B3 | B3
262Hz | C4 | C4
294Hz | D4 | D4
330Hz | E4 | E4

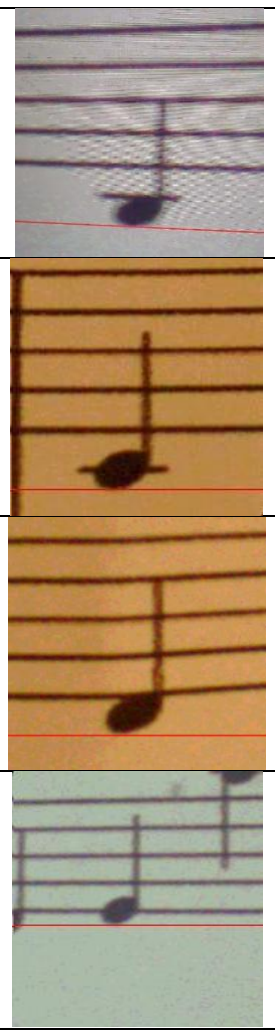
[picture p25: figure]

טבלה :2 תוצאות של מספר דגימות של תמונות של תווים

כעת נתבונן בתיבות הבאות המכילות תווים במשקלים שונים )כאן יש להזכיר שהמערכת אינה מזהה את המשקלים, אלא רק את התווים עצמם(.

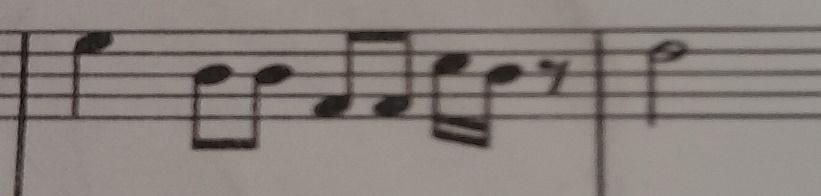
[picture p26: figure]

איור :28 רצף של תווים במשקלים שונים

| | | התמונה שנלקחה התו התו שזוהה התדר שנוגן

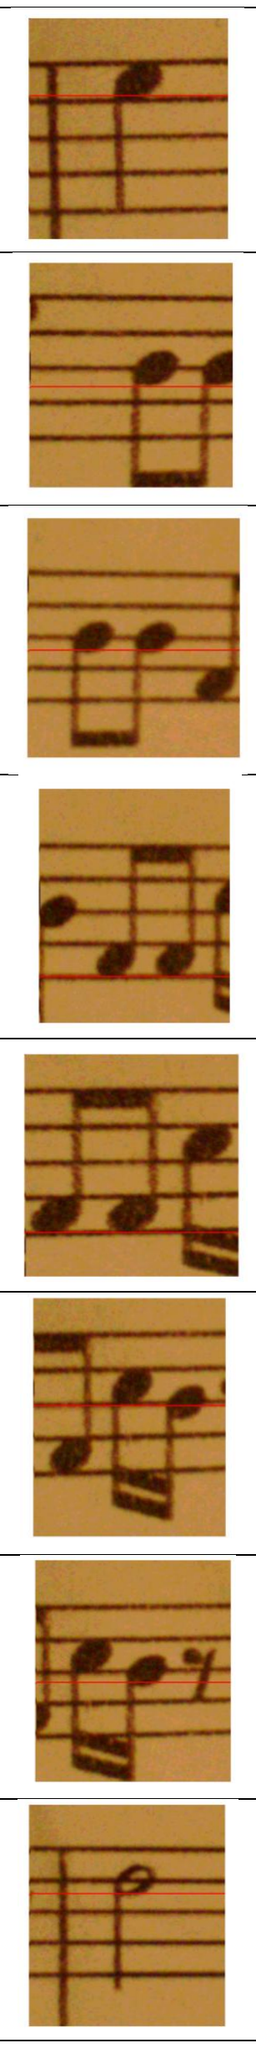
[picture p27: figure]

659Hz | E5 | E5
440Hz | A4 | B4
494Hz | B4 | B4
349Hz | F4 | F4
349Hz | F4 | F4
494Hz | B4 | C5
494Hz | B4 | B4
587Hz | D5 | D5

טבלה :3 תוצאות של רצף תווים עם משקלים שונים

לאחר זיהוי תווים אלו התקבל קובץ טקסט בו רשומים התווים שצריכים להתנגן בסוף הזיהוי.

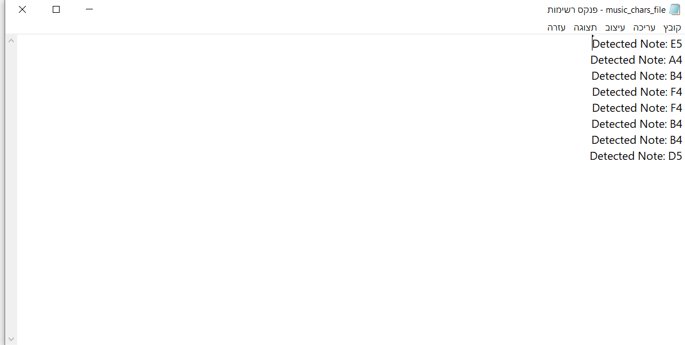
[picture p28: figure]

איור :29 קובץ טקסט של התווים שצריכים להתנגן

כעת נתבונן בתיבה בעלת תווים עם סימנים שונים סימנים שונים )שני תווים עם סימן דיאז, אחד עם במול ועוד אחד עם בקר(. גם כאן נזכיר שהמערכת אינה מזהה סימנים ולכן התווים שיתקבלו בסוף יהיו תווים "לבנים" )מבלי סימן(.

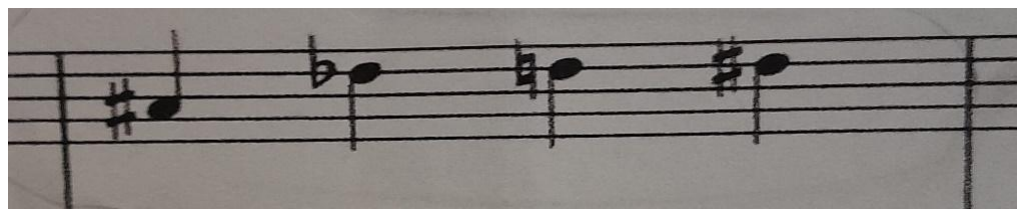
[picture p29: figure]

איור :30 רצף של תווים עם סימנים שונים

| | | התמונה שנלקחה התו התו שזוהה התדר שנוגן

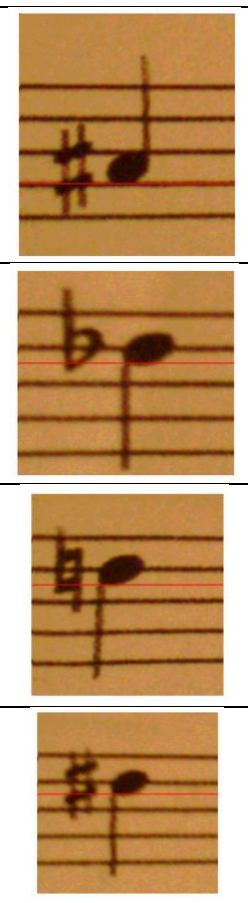
[picture p30: figure]

440Hz | A4 | A#4
587Hz | D5 | Db5
587Hz | D5 | D5
587Hz | D5 | D#5

טבלה :4 תוצאות של רצף תווים עם סימנים שונים

לאחר זיהוי תווים אלו התקבל קובץ טקסט בו רשומים התווים שצריכים להתנגן בסוף הזיהוי.

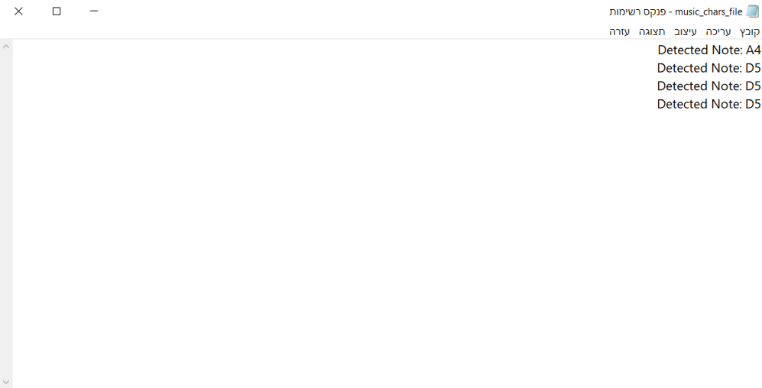
[picture p31: figure]

איור :31 קובץ טקסט של התווים

לסיום נבחן את ששת התווים הראשונים של יונתן הקטן.

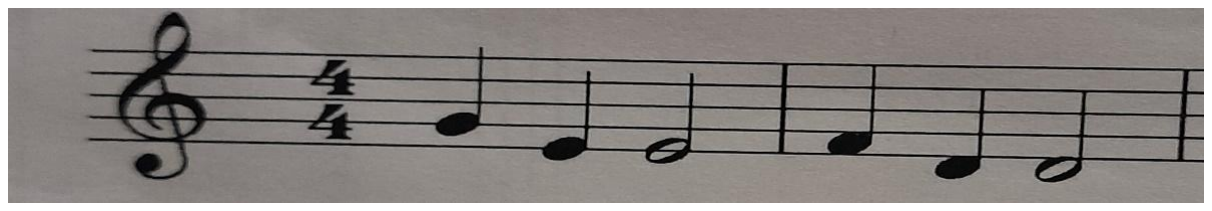
[picture p32: figure]

איור :32 רצף התווים הראשונים של יונתן הקטן

| | | התמונה שנלקחה התו התו שזוהה התדר שנוגן
392Hz | G4 | G4
330Hz | E4 | E4
330Hz | E4 | E4
349Hz | F4 | F4
294Hz | D4 | D4
294Hz | D4 | D4

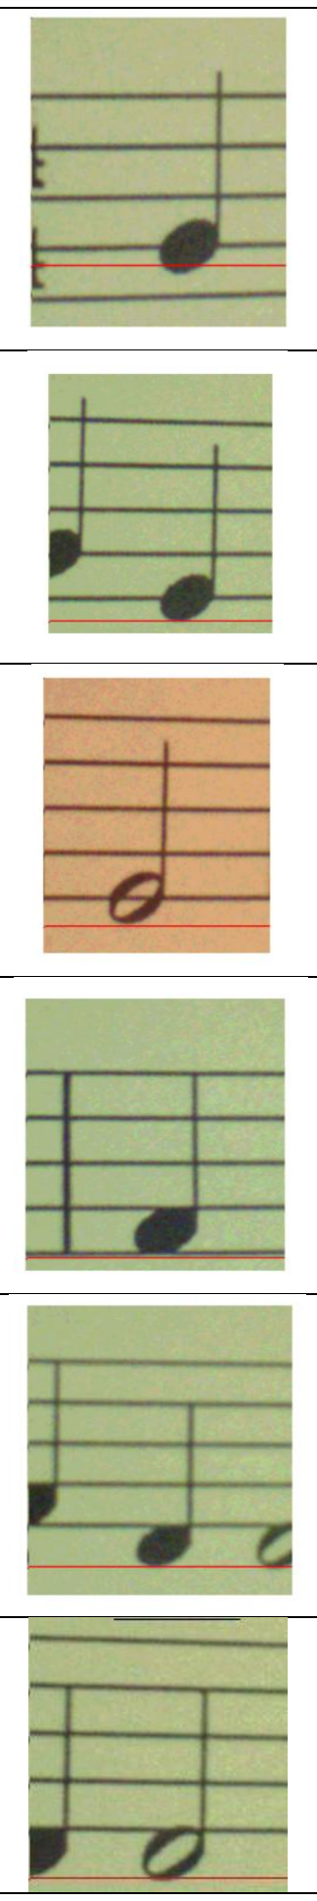
[picture p33: figure]

טבלה :5 תוצאות של רצף התווים הראשונים של יונתן הקטן

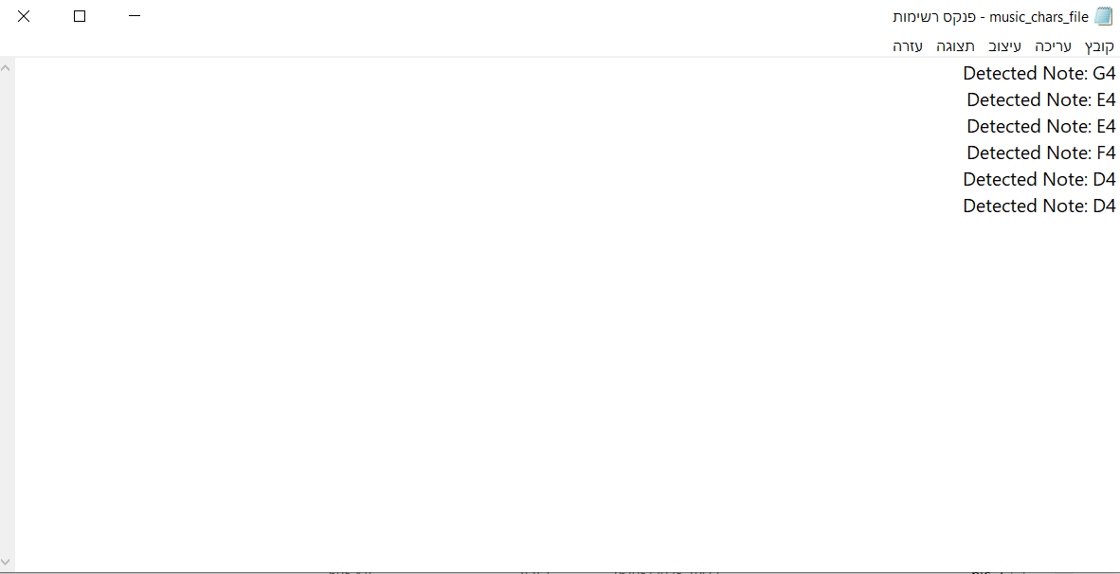
[picture p34: figure]

איור :33 קובץ טקסט של התווים הראשונים של יונתן הקטן

### 6 מסקנות והצעות להמשך מחקר:

מהבדיקות שנעשו ניתן להסיק מספר מסקנות. ראשית ניתן לראות שהדיוק בזיהוי התווים הלבנים )חסרי הסימן( הוא כמעט אבסולוטי, את השגיאות המועטות שהיו במקרים האלו סביר להניח שהיה ניתן למנוע על ידי הוספת דיוקים בלוגיקה של הזיהוי תווים, דבר שבהינתן יותר זמן וניסיונות היה ניתן בהחלט. עם זאת בבדיקות מוצגים שני החסרונות העיקריים של שיטה זאת. הראשונה היא זיהוי סימן. התוכנה אינה יודעת לזהות במולים ודיאזים. בעיה זו היא בעיה שקשה מאוד להתגבר עלייה, בעיקר מעצם העובדה שגם אם יש מודל שיודע לזהות את שלושת הסימנים האלה )דיאז, במול ובקר במקרה הצורך( עדיין סימנים אלה יכולים להופיע במקומות שונים על הדף, כלומר ליד התו, בתחילת השורה או ליד תו אחר שבאותה תיבה, ולפי כל אחד מהמקרים האלה צריך לנהוג בהתאם, כלומר יהיה צריך בנוסף לזהות גם התחלה של שורות והתחלה\סיום של תיבות, ועל כך לבנות לוגיקה מתאימה )כלומר להכפיל את התדר בפקטור של כ- 1.059463 במקרים המתאימים(. סביר להניח שהדרך הכי פשוטה לבצע פעולה זאת יהיה בעזרת למידה עמוקה, אבל לכך יידרש סט נתונים מתאים.

החיסרון השני שעולה מהתוצאות הוא זיהוי משקל התווים. המודל אינו יודע לזהות את המשקל של התו ומנגן את כולם באותו משך זמן. בשלב זה חשוב לחזור על הנאמר לעיל להזכיר שבגרסה מוקדמת יותר של המודל זיהוי התווים נעשה גם על ידי שימוש בפונקציה של פייתון מחבילת OpenCV שמשמשת לזיהוי אליפסות. שיטה זו הניבה תוצאות טובות עבור תמונות באיכויות גבוהות ותוצאות גבוליות על תמונות שנלקחו ישירות מהערכה שלנו. לבסוף החלטנו לשנות גישה ולהשתמש בשיטה של הקו האדום שמתכוונן לפי המשתמש. שיטה זו נתנה תוצאות הרבה יותר טובות עם דיוק כמעט אבסולוטי עבור התווים הלבנים. עם זאת ייתכן שאם היינו נשארים בגישה הראשונה של זיהוי האליפסה באמצעות ראייה ממוחשבת היה קל לנו יותר לאחר פיתוח המודל להוסיף לו את האפשרות לזהות אם האליפסה חלולה או לאו, ובכך להתחיל לזאת את משקל התו. לאחר מכן להוסיף זיהוי של קו אנכי )שאורכו לא יהיה כל התמונה, אלא מרחק מסוים שיינתן ביחס למרחק הממוצע בין הקווים האופקיים, שמחושב במודל בלאו הכי( ובכך יהיה אפשר לכסות את המקרים של שלם, חצי ורבע. סביר להניח שהמקרים שהם מתחת לרבע יהיו קשיים יותר לזיהוי בגלל הוורסטיליות שלהם והשינויים שקשה יותר לתפוס אותם באמצעות ראייה ממוחשבת )אם כי זה אפשרי(. בכל מקרה אנחנו העדפנו לבסוף לשנות גישה כך שמה שיהיה לנו ביד יהיה טוב יותר ולא ללכת בגישה שיהיה לנו דבר פחות טוב ביד אבל עם פוטנציאל עתידי טוב יותר. ככל הנראה אם היינו יכולים להמשיך מכאן את הפרויקט היה עדיף לנו לקחת את הדגימות שכבר יש לנו ולנסות לפתח עליהן את האלגוריתמים הנוספים של הראייה ממוחשבת. גם כאן יש לסייג את הדברים שוב ולהוסיף עוד שתי נקודות חשובות של המסקנות שמכריעות גם בנושא הזה. הראשונה היא שעדיין איכות המצלמה תישאר ירודה, וגם לאחר הפילטרים השונים שאנו משתמשים בקוד )מטשטוש גאוסייאני, לטשטוש מדיין, להעברת התמונות מצורות תצוגה שונות( התמונה יכולה לצאת באיכות שתקשה על אותם אלגוריתמים. הנקודה השנייה שמנעה מאיתנו לעשות מספיק בדיקות במהלך הפיתוח היא משך הזמן שלוקח לשלוח תמונה. כאמור בתחילת הפרויקט משך הזמן היה כשעה, אבל בהמשך הצלחנו להוריד את זמן השליחה משעה לבערך 15 דקות. שינוי זה נעשה בעזרת הקטנת גודל התמונה הנשלחת. עדיין

הדבר הקשה עלינו במהלך הפרויקט לקחת מספיק דגימות ולבנות את האלגוריתמים עליהן )שהרי אלגוריתמים של ראייה ממוחשבת דורשים המון ניסוי וטעייה(. משך הזמן של השליחה הוא בעיה שנשארה גם למוצר הסופי. ככל הנראה היה ניתן למנוע זאת על ידי שינוי הבאוד רייט ועל ידי שימוש שונה או באלטרנטיבה מתאימה ל PuTTY, למשל Term Tera או RealTerm שפועלות בצורה מהירה יותר.

לסיכום נראה שהתוצאות עבורן המודל מכוון הן מטיבות ביותר, ויחד עם זאת, התחום של קריאת תווים מוסיקליים הוא עצום ובעל המון אספקטים שונים שרובם אפילו לא נזכרו בכל הכתוב לעיל )למשל תיבות שחוזרות על עצמן, עם שינויים ובלי שינויים, מפתחות שונים כמו מפתח פה ודו וכו'( ולכן לבנות מודל שייחסה את כל המקרים הנ"ל זה דבר שאפתני שדורש זמן ומשאבים הרבה מעבר למה שניתן לנו בפרויקט. עם זאת הצלחנו להראות איך בכלים יחסית פשוטים ו"טפשיים" )כלומר ללא בינה מלאכותית( אפשר לבנות מודל פשוט, אינטראקטיבי, שעובד טוב בתחומו ומהווה תשתית טובה לפיתוחים עתידיים.

## 7 ביבליוגרפיה

[1] Calvo-Zaragoza, J.; Jr, J.H.; Pacha, A. Understanding Optical Music Recognition. ACM Comput. Surv. 2020, 53, 1–35.Pacha* , TU Wien
[2] I. Patel, S. Patel and A. Patel, “Analysis of various image preprocessing techniques for denoising of flower images,” International Journal of Computer Sciences and Engineering, vol. 6, pp. 1111–1117, 2018.
[3] N. Lenssen and D. Needell, "An Introduction to Fourier Analysis with Applications to Music", Journal of Humanistic Mathematics, vol. 4, no. 1, pp. 72-91, 2014.
