NadavOsh/music-notes-detection-system/src/FPGA/hardware/cam_top.v

`timescale 1ns / 1ps
`default_nettype none 

/*
 *  Instantiates debouncer to debounce cam start initialization button,
 *  cam_init to send cam ROM data to sccb_master, cam_capture to  
 *  sample and output incoming pixel data after cam is done initializing 
 *  based off frame sync signals (i_vsync, i_href)
 *
 */

module cam_top
#(parameter CAM_CONFIG_CLK = 100_000_000)
     (  input wire          i_clk,
        input wire          i_rstn_clk,
        input wire          i_rstn_pclk, 
       
        // Start/Done signals for cam init      
        input wire          i_cam_start,
        output wire         o_cam_done,
        input wire          i_top_cam_capture,
        input wire          i_top_cam_video,
        // I/O camera
        input wire          i_pclk, 
        input wire [7:0]    i_pix_byte, 
        input wire          i_vsync,
        input wire          i_href,
        output wire         o_reset,     
        output wire         o_pwdn,       
        output wire         o_siod,
        output wire         o_sioc,
        
        // Outputs to BRAM
        output wire         o_pix_wr, 
        output wire [11:0]  o_pix_data,
        output wire [18:0]  o_pix_addr,
        output wire [1:0]  state_out
    );
    
    assign o_reset = 1;       // 0: reset registers   1: normal mode
    assign o_pwdn  = 0;       // 0: normal mode       1: power down mode
       
    wire       w_start_db,w_capture_db,w_video_db;
        
    debouncer 
    #(  .DELAY(240_000)         )    
    cam_btn_start_db
    (   .i_clk(i_clk            ), 
        .i_btn_in(i_cam_start   ),
        
        // Debounced button to start cam init 
        .o_btn_db(w_start_db    )
    );
    
    debouncer 
    #(  .DELAY(240_000)         )    
    cam_btn_capture_db
    (   .i_clk(i_clk            ), 
        .i_btn_in(i_top_cam_capture   ),
        
        // Debounced button to start cam init 
        .o_btn_db(w_capture_db    )
    );
    
    debouncer 
    #(  .DELAY(240_000)         )    
    cam_btn_video_db
    (   .i_clk(i_clk            ), 
        .i_btn_in(i_top_cam_video   ),
        
        // Debounced button to start cam init 
        .o_btn_db(w_video_db    )
    );
    
    
    
    cam_init 
    #(  .CLK_F(CAM_CONFIG_CLK       ), 
        .SCCB_F(400_000)            )
    configure_cam
    (   .i_clk(i_clk                ),
        .i_rstn(i_rstn_clk          ),
        
        // Start/Done signals for cam init    
        .i_cam_init_start(w_start_db),
        .o_cam_init_done(o_cam_done ),
        
       
        
        // SCCB lines
        .o_siod(o_siod              ),
        .o_sioc(o_sioc              ),
        
        // Signals used for testbench
        .o_data_sent_done(          ),
        .o_SCCB_dout(               )
    );
    
    cam_capture
    cam_pixels
    (   // Cam VGA frame timing signals
        .i_pclk(i_pclk         ), 
        .i_vsync(i_vsync       ),
        .i_href(i_href         ),
        
        // Poll for when the cam is done init
        .i_cam_done(o_cam_done ),
        .i_cam_capture(w_capture_db),
        .i_cam_video(w_video_db),
        
        
        
        .i_D(i_pix_byte        ),
        .o_pix_addr(o_pix_addr ),
        .o_wr(o_pix_wr         ),           
        .o_pix_data(o_pix_data ),
        .state_out(state_out)  
    );
      
endmodule
