NadavOsh/music-notes-detection-system/src/FPGA/hardware/design_1.v

//Copyright 1986-2021 Xilinx, Inc. All Rights Reserved.
//--------------------------------------------------------------------------------
//Tool Version: Vivado v.2021.1 (win64) Build 3247384 Thu Jun 10 19:36:33 MDT 2021
//Date        : Fri Apr 11 18:01:51 2025
//Host        : DESKTOP-VHJE80L running 64-bit major release  (build 9200)
//Command     : generate_target design_1.bd
//Design      : design_1
//Purpose     : IP block netlist
//--------------------------------------------------------------------------------
`timescale 1 ps / 1 ps

(* CORE_GENERATION_INFO = "design_1,IP_Integrator,{x_ipVendor=xilinx.com,x_ipLibrary=BlockDiagram,x_ipName=design_1,x_ipVersion=1.00.a,x_ipLanguage=VERILOG,numBlks=25,numReposBlks=18,numNonXlnxBlks=0,numHierBlks=7,maxHierDepth=1,numSysgenBlks=0,numHlsBlks=0,numHdlrefBlks=0,numPkgbdBlks=0,bdsource=USER,da_axi4_cnt=2,da_board_cnt=1,da_mb_cnt=2,synth_mode=OOC_per_IP}" *) (* HW_HANDOFF = "design_1.hwdef" *) 
module design_1
   (Clk,
    ext_reset_in_0,
    gpio2_io_o_0,
    gpio2_io_o_1,
    gpio_io_i_0,
    gpio_io_o_0,
    run_vitis,
    usb_uart_rxd,
    usb_uart_txd,
    vitis_finish,
    vitis_led,
    vitis_led_for);
  (* X_INTERFACE_INFO = "xilinx.com:signal:clock:1.0 CLK.CLK CLK" *) (* X_INTERFACE_PARAMETER = "XIL_INTERFACENAME CLK.CLK, CLK_DOMAIN design_1_Clk, FREQ_HZ 25000000, FREQ_TOLERANCE_HZ 0, INSERT_VIP 0, PHASE 0.0" *) input Clk;
  (* X_INTERFACE_INFO = "xilinx.com:signal:reset:1.0 RST.EXT_RESET_IN_0 RST" *) (* X_INTERFACE_PARAMETER = "XIL_INTERFACENAME RST.EXT_RESET_IN_0, INSERT_VIP 0, POLARITY ACTIVE_HIGH" *) input ext_reset_in_0;
  output [31:0]gpio2_io_o_0;
  output [31:0]gpio2_io_o_1;
  input [31:0]gpio_io_i_0;
  output [31:0]gpio_io_o_0;
  input [0:0]run_vitis;
  (* X_INTERFACE_INFO = "xilinx.com:interface:uart:1.0 usb_uart RxD" *) input usb_uart_rxd;
  (* X_INTERFACE_INFO = "xilinx.com:interface:uart:1.0 usb_uart TxD" *) output usb_uart_txd;
  output [0:0]vitis_finish;
  output [0:0]vitis_led;
  output [0:0]vitis_led_for;

  wire [0:0]In0_0_1;
  wire [31:0]axi_gpio_0_gpio2_io_o;
  wire [31:0]axi_gpio_0_gpio_io_o;
  wire [31:0]axi_gpio_1_gpio2_io_o;
  wire [31:0]axi_gpio_2_gpio_io_o;
  wire [31:0]axi_interconnect_0_M00_AXI_ARADDR;
  wire axi_interconnect_0_M00_AXI_ARREADY;
  wire axi_interconnect_0_M00_AXI_ARVALID;
  wire [31:0]axi_interconnect_0_M00_AXI_AWADDR;
  wire axi_interconnect_0_M00_AXI_AWREADY;
  wire axi_interconnect_0_M00_AXI_AWVALID;
  wire axi_interconnect_0_M00_AXI_BREADY;
  wire [1:0]axi_interconnect_0_M00_AXI_BRESP;
  wire axi_interconnect_0_M00_AXI_BVALID;
  wire [31:0]axi_interconnect_0_M00_AXI_RDATA;
  wire axi_interconnect_0_M00_AXI_RREADY;
  wire [1:0]axi_interconnect_0_M00_AXI_RRESP;
  wire axi_interconnect_0_M00_AXI_RVALID;
  wire [31:0]axi_interconnect_0_M00_AXI_WDATA;
  wire axi_interconnect_0_M00_AXI_WREADY;
  wire [3:0]axi_interconnect_0_M00_AXI_WSTRB;
  wire axi_interconnect_0_M00_AXI_WVALID;
  wire [31:0]axi_interconnect_0_M01_AXI_ARADDR;
  wire axi_interconnect_0_M01_AXI_ARREADY;
  wire axi_interconnect_0_M01_AXI_ARVALID;
  wire [31:0]axi_interconnect_0_M01_AXI_AWADDR;
  wire axi_interconnect_0_M01_AXI_AWREADY;
  wire axi_interconnect_0_M01_AXI_AWVALID;
  wire axi_interconnect_0_M01_AXI_BREADY;
  wire [1:0]axi_interconnect_0_M01_AXI_BRESP;
  wire axi_interconnect_0_M01_AXI_BVALID;
  wire [31:0]axi_interconnect_0_M01_AXI_RDATA;
  wire axi_interconnect_0_M01_AXI_RREADY;
  wire [1:0]axi_interconnect_0_M01_AXI_RRESP;
  wire axi_interconnect_0_M01_AXI_RVALID;
  wire [31:0]axi_interconnect_0_M01_AXI_WDATA;
  wire axi_interconnect_0_M01_AXI_WREADY;
  wire [3:0]axi_interconnect_0_M01_AXI_WSTRB;
  wire axi_interconnect_0_M01_AXI_WVALID;
  wire [31:0]axi_interconnect_0_M02_AXI_ARADDR;
  wire axi_interconnect_0_M02_AXI_ARREADY;
  wire axi_interconnect_0_M02_AXI_ARVALID;
  wire [31:0]axi_interconnect_0_M02_AXI_AWADDR;
  wire axi_interconnect_0_M02_AXI_AWREADY;
  wire axi_interconnect_0_M02_AXI_AWVALID;
  wire axi_interconnect_0_M02_AXI_BREADY;
  wire [1:0]axi_interconnect_0_M02_AXI_BRESP;
  wire axi_interconnect_0_M02_AXI_BVALID;
  wire [31:0]axi_interconnect_0_M02_AXI_RDATA;
  wire axi_interconnect_0_M02_AXI_RREADY;
  wire [1:0]axi_interconnect_0_M02_AXI_RRESP;
  wire axi_interconnect_0_M02_AXI_RVALID;
  wire [31:0]axi_interconnect_0_M02_AXI_WDATA;
  wire axi_interconnect_0_M02_AXI_WREADY;
  wire [3:0]axi_interconnect_0_M02_AXI_WSTRB;
  wire axi_interconnect_0_M02_AXI_WVALID;
  wire [31:0]axi_interconnect_0_M03_AXI_ARADDR;
  wire axi_interconnect_0_M03_AXI_ARREADY;
  wire axi_interconnect_0_M03_AXI_ARVALID;
  wire [31:0]axi_interconnect_0_M03_AXI_AWADDR;
  wire axi_interconnect_0_M03_AXI_AWREADY;
  wire axi_interconnect_0_M03_AXI_AWVALID;
  wire axi_interconnect_0_M03_AXI_BREADY;
  wire [1:0]axi_interconnect_0_M03_AXI_BRESP;
  wire axi_interconnect_0_M03_AXI_BVALID;
  wire [31:0]axi_interconnect_0_M03_AXI_RDATA;
  wire axi_interconnect_0_M03_AXI_RREADY;
  wire [1:0]axi_interconnect_0_M03_AXI_RRESP;
  wire axi_interconnect_0_M03_AXI_RVALID;
  wire [31:0]axi_interconnect_0_M03_AXI_WDATA;
  wire axi_interconnect_0_M03_AXI_WREADY;
  wire [3:0]axi_interconnect_0_M03_AXI_WSTRB;
  wire axi_interconnect_0_M03_AXI_WVALID;
  wire axi_uartlite_0_UART_RxD;
  wire axi_uartlite_0_UART_TxD;
  wire ext_reset_in_0_1;
  wire [31:0]gpio_io_i_0_1;
  wire mdm_1_debug_sys_rst;
  wire microblaze_0_Clk;
  wire [31:0]microblaze_0_M_AXI_DP_ARADDR;
  wire [2:0]microblaze_0_M_AXI_DP_ARPROT;
  wire [0:0]microblaze_0_M_AXI_DP_ARREADY;
  wire microblaze_0_M_AXI_DP_ARVALID;
  wire [31:0]microblaze_0_M_AXI_DP_AWADDR;
  wire [2:0]microblaze_0_M_AXI_DP_AWPROT;
  wire [0:0]microblaze_0_M_AXI_DP_AWREADY;
  wire microblaze_0_M_AXI_DP_AWVALID;
  wire microblaze_0_M_AXI_DP_BREADY;
  wire [1:0]microblaze_0_M_AXI_DP_BRESP;
  wire [0:0]microblaze_0_M_AXI_DP_BVALID;
  wire [31:0]microblaze_0_M_AXI_DP_RDATA;
  wire microblaze_0_M_AXI_DP_RREADY;
  wire [1:0]microblaze_0_M_AXI_DP_RRESP;
  wire [0:0]microblaze_0_M_AXI_DP_RVALID;
  wire [31:0]microblaze_0_M_AXI_DP_WDATA;
  wire [0:0]microblaze_0_M_AXI_DP_WREADY;
  wire [3:0]microblaze_0_M_AXI_DP_WSTRB;
  wire microblaze_0_M_AXI_DP_WVALID;
  wire microblaze_0_debug_CAPTURE;
  wire microblaze_0_debug_CLK;
  wire microblaze_0_debug_DISABLE;
  wire [0:7]microblaze_0_debug_REG_EN;
  wire microblaze_0_debug_RST;
  wire microblaze_0_debug_SHIFT;
  wire microblaze_0_debug_TDI;
  wire microblaze_0_debug_TDO;
  wire microblaze_0_debug_UPDATE;
  wire [0:31]microblaze_0_dlmb_1_ABUS;
  wire microblaze_0_dlmb_1_ADDRSTROBE;
  wire [0:3]microblaze_0_dlmb_1_BE;
  wire microblaze_0_dlmb_1_CE;
  wire [0:31]microblaze_0_dlmb_1_READDBUS;
  wire microblaze_0_dlmb_1_READSTROBE;
  wire microblaze_0_dlmb_1_READY;
  wire microblaze_0_dlmb_1_UE;
  wire microblaze_0_dlmb_1_WAIT;
  wire [0:31]microblaze_0_dlmb_1_WRITEDBUS;
  wire microblaze_0_dlmb_1_WRITESTROBE;
  wire [0:31]microblaze_0_ilmb_1_ABUS;
  wire microblaze_0_ilmb_1_ADDRSTROBE;
  wire microblaze_0_ilmb_1_CE;
  wire [0:31]microblaze_0_ilmb_1_READDBUS;
  wire microblaze_0_ilmb_1_READSTROBE;
  wire microblaze_0_ilmb_1_READY;
  wire microblaze_0_ilmb_1_UE;
  wire microblaze_0_ilmb_1_WAIT;
  wire [0:0]rst_Clk_100M_bus_struct_reset;
  wire [0:0]rst_Clk_100M_interconnect_aresetn;
  wire rst_Clk_100M_mb_reset;
  wire [0:0]rst_Clk_100M_peripheral_aresetn;
  wire [31:0]xlconcat_0_dout;
  wire [30:0]xlconstant_0_dout;
  wire [0:0]xlslice_0_Dout;
  wire [0:0]xlslice_1_Dout;
  wire [0:0]xlslice_2_Dout;

  assign In0_0_1 = run_vitis[0];
  assign axi_uartlite_0_UART_RxD = usb_uart_rxd;
  assign ext_reset_in_0_1 = ext_reset_in_0;
  assign gpio2_io_o_0[31:0] = axi_gpio_0_gpio2_io_o;
  assign gpio2_io_o_1[31:0] = axi_gpio_1_gpio2_io_o;
  assign gpio_io_i_0_1 = gpio_io_i_0[31:0];
  assign gpio_io_o_0[31:0] = axi_gpio_0_gpio_io_o;
  assign microblaze_0_Clk = Clk;
  assign usb_uart_txd = axi_uartlite_0_UART_TxD;
  assign vitis_finish[0] = xlslice_2_Dout;
  assign vitis_led[0] = xlslice_0_Dout;
  assign vitis_led_for[0] = xlslice_1_Dout;
  design_1_axi_gpio_0_0 axi_gpio_0
       (.gpio2_io_o(axi_gpio_0_gpio2_io_o),
        .gpio_io_o(axi_gpio_0_gpio_io_o),
        .s_axi_aclk(microblaze_0_Clk),
        .s_axi_araddr(axi_interconnect_0_M00_AXI_ARADDR[8:0]),
        .s_axi_aresetn(rst_Clk_100M_peripheral_aresetn),
        .s_axi_arready(axi_interconnect_0_M00_AXI_ARREADY),
        .s_axi_arvalid(axi_interconnect_0_M00_AXI_ARVALID),
        .s_axi_awaddr(axi_interconnect_0_M00_AXI_AWADDR[8:0]),
        .s_axi_awready(axi_interconnect_0_M00_AXI_AWREADY),
        .s_axi_awvalid(axi_interconnect_0_M00_AXI_AWVALID),
        .s_axi_bready(axi_interconnect_0_M00_AXI_BREADY),
        .s_axi_bresp(axi_interconnect_0_M00_AXI_BRESP),
        .s_axi_bvalid(axi_interconnect_0_M00_AXI_BVALID),
        .s_axi_rdata(axi_interconnect_0_M00_AXI_RDATA),
        .s_axi_rready(axi_interconnect_0_M00_AXI_RREADY),
        .s_axi_rresp(axi_interconnect_0_M00_AXI_RRESP),
        .s_axi_rvalid(axi_interconnect_0_M00_AXI_RVALID),
        .s_axi_wdata(axi_interconnect_0_M00_AXI_WDATA),
        .s_axi_wready(axi_interconnect_0_M00_AXI_WREADY),
        .s_axi_wstrb(axi_interconnect_0_M00_AXI_WSTRB),
        .s_axi_wvalid(axi_interconnect_0_M00_AXI_WVALID));
  design_1_axi_gpio_0_1 axi_gpio_1
       (.gpio2_io_o(axi_gpio_1_gpio2_io_o),
        .gpio_io_i(gpio_io_i_0_1),
        .s_axi_aclk(microblaze_0_Clk),
        .s_axi_araddr(axi_interconnect_0_M01_AXI_ARADDR[8:0]),
        .s_axi_aresetn(rst_Clk_100M_peripheral_aresetn),
        .s_axi_arready(axi_interconnect_0_M01_AXI_ARREADY),
        .s_axi_arvalid(axi_interconnect_0_M01_AXI_ARVALID),
        .s_axi_awaddr(axi_interconnect_0_M01_AXI_AWADDR[8:0]),
        .s_axi_awready(axi_interconnect_0_M01_AXI_AWREADY),
        .s_axi_awvalid(axi_interconnect_0_M01_AXI_AWVALID),
        .s_axi_bready(axi_interconnect_0_M01_AXI_BREADY),
        .s_axi_bresp(axi_interconnect_0_M01_AXI_BRESP),
        .s_axi_bvalid(axi_interconnect_0_M01_AXI_BVALID),
        .s_axi_rdata(axi_interconnect_0_M01_AXI_RDATA),
        .s_axi_rready(axi_interconnect_0_M01_AXI_RREADY),
        .s_axi_rresp(axi_interconnect_0_M01_AXI_RRESP),
        .s_axi_rvalid(axi_interconnect_0_M01_AXI_RVALID),
        .s_axi_wdata(axi_interconnect_0_M01_AXI_WDATA),
        .s_axi_wready(axi_interconnect_0_M01_AXI_WREADY),
        .s_axi_wstrb(axi_interconnect_0_M01_AXI_WSTRB),
        .s_axi_wvalid(axi_interconnect_0_M01_AXI_WVALID));
  design_1_axi_gpio_0_2 axi_gpio_2
       (.gpio2_io_i(xlconcat_0_dout),
        .gpio_io_o(axi_gpio_2_gpio_io_o),
        .s_axi_aclk(microblaze_0_Clk),
        .s_axi_araddr(axi_interconnect_0_M03_AXI_ARADDR[8:0]),
        .s_axi_aresetn(rst_Clk_100M_peripheral_aresetn),
        .s_axi_arready(axi_interconnect_0_M03_AXI_ARREADY),
        .s_axi_arvalid(axi_interconnect_0_M03_AXI_ARVALID),
        .s_axi_awaddr(axi_interconnect_0_M03_AXI_AWADDR[8:0]),
        .s_axi_awready(axi_interconnect_0_M03_AXI_AWREADY),
        .s_axi_awvalid(axi_interconnect_0_M03_AXI_AWVALID),
        .s_axi_bready(axi_interconnect_0_M03_AXI_BREADY),
        .s_axi_bresp(axi_interconnect_0_M03_AXI_BRESP),
        .s_axi_bvalid(axi_interconnect_0_M03_AXI_BVALID),
        .s_axi_rdata(axi_interconnect_0_M03_AXI_RDATA),
        .s_axi_rready(axi_interconnect_0_M03_AXI_RREADY),
        .s_axi_rresp(axi_interconnect_0_M03_AXI_RRESP),
        .s_axi_rvalid(axi_interconnect_0_M03_AXI_RVALID),
        .s_axi_wdata(axi_interconnect_0_M03_AXI_WDATA),
        .s_axi_wready(axi_interconnect_0_M03_AXI_WREADY),
        .s_axi_wstrb(axi_interconnect_0_M03_AXI_WSTRB),
        .s_axi_wvalid(axi_interconnect_0_M03_AXI_WVALID));
  design_1_axi_interconnect_0_0 axi_interconnect_0
       (.ACLK(microblaze_0_Clk),
        .ARESETN(rst_Clk_100M_interconnect_aresetn),
        .M00_ACLK(microblaze_0_Clk),
        .M00_ARESETN(rst_Clk_100M_peripheral_aresetn),
        .M00_AXI_araddr(axi_interconnect_0_M00_AXI_ARADDR),
        .M00_AXI_arready(axi_interconnect_0_M00_AXI_ARREADY),
        .M00_AXI_arvalid(axi_interconnect_0_M00_AXI_ARVALID),
        .M00_AXI_awaddr(axi_interconnect_0_M00_AXI_AWADDR),
        .M00_AXI_awready(axi_interconnect_0_M00_AXI_AWREADY),
        .M00_AXI_awvalid(axi_interconnect_0_M00_AXI_AWVALID),
        .M00_AXI_bready(axi_interconnect_0_M00_AXI_BREADY),
        .M00_AXI_bresp(axi_interconnect_0_M00_AXI_BRESP),
        .M00_AXI_bvalid(axi_interconnect_0_M00_AXI_BVALID),
        .M00_AXI_rdata(axi_interconnect_0_M00_AXI_RDATA),
        .M00_AXI_rready(axi_interconnect_0_M00_AXI_RREADY),
        .M00_AXI_rresp(axi_interconnect_0_M00_AXI_RRESP),
        .M00_AXI_rvalid(axi_interconnect_0_M00_AXI_RVALID),
        .M00_AXI_wdata(axi_interconnect_0_M00_AXI_WDATA),
        .M00_AXI_wready(axi_interconnect_0_M00_AXI_WREADY),
        .M00_AXI_wstrb(axi_interconnect_0_M00_AXI_WSTRB),
        .M00_AXI_wvalid(axi_interconnect_0_M00_AXI_WVALID),
        .M01_ACLK(microblaze_0_Clk),
        .M01_ARESETN(rst_Clk_100M_peripheral_aresetn),
        .M01_AXI_araddr(axi_interconnect_0_M01_AXI_ARADDR),
        .M01_AXI_arready(axi_interconnect_0_M01_AXI_ARREADY),
        .M01_AXI_arvalid(axi_interconnect_0_M01_AXI_ARVALID),
        .M01_AXI_awaddr(axi_interconnect_0_M01_AXI_AWADDR),
        .M01_AXI_awready(axi_interconnect_0_M01_AXI_AWREADY),
        .M01_AXI_awvalid(axi_interconnect_0_M01_AXI_AWVALID),
        .M01_AXI_bready(axi_interconnect_0_M01_AXI_BREADY),
        .M01_AXI_bresp(axi_interconnect_0_M01_AXI_BRESP),
        .M01_AXI_bvalid(axi_interconnect_0_M01_AXI_BVALID),
        .M01_AXI_rdata(axi_interconnect_0_M01_AXI_RDATA),
        .M01_AXI_rready(axi_interconnect_0_M01_AXI_RREADY),
        .M01_AXI_rresp(axi_interconnect_0_M01_AXI_RRESP),
        .M01_AXI_rvalid(axi_interconnect_0_M01_AXI_RVALID),
        .M01_AXI_wdata(axi_interconnect_0_M01_AXI_WDATA),
        .M01_AXI_wready(axi_interconnect_0_M01_AXI_WREADY),
        .M01_AXI_wstrb(axi_interconnect_0_M01_AXI_WSTRB),
        .M01_AXI_wvalid(axi_interconnect_0_M01_AXI_WVALID),
        .M02_ACLK(microblaze_0_Clk),
        .M02_ARESETN(rst_Clk_100M_peripheral_aresetn),
        .M02_AXI_araddr(axi_interconnect_0_M02_AXI_ARADDR),
        .M02_AXI_arready(axi_interconnect_0_M02_AXI_ARREADY),
        .M02_AXI_arvalid(axi_interconnect_0_M02_AXI_ARVALID),
        .M02_AXI_awaddr(axi_interconnect_0_M02_AXI_AWADDR),
        .M02_AXI_awready(axi_interconnect_0_M02_AXI_AWREADY),
        .M02_AXI_awvalid(axi_interconnect_0_M02_AXI_AWVALID),
        .M02_AXI_bready(axi_interconnect_0_M02_AXI_BREADY),
        .M02_AXI_bresp(axi_interconnect_0_M02_AXI_BRESP),
        .M02_AXI_bvalid(axi_interconnect_0_M02_AXI_BVALID),
        .M02_AXI_rdata(axi_interconnect_0_M02_AXI_RDATA),
        .M02_AXI_rready(axi_interconnect_0_M02_AXI_RREADY),
        .M02_AXI_rresp(axi_interconnect_0_M02_AXI_RRESP),
        .M02_AXI_rvalid(axi_interconnect_0_M02_AXI_RVALID),
        .M02_AXI_wdata(axi_interconnect_0_M02_AXI_WDATA),
        .M02_AXI_wready(axi_interconnect_0_M02_AXI_WREADY),
        .M02_AXI_wstrb(axi_interconnect_0_M02_AXI_WSTRB),
        .M02_AXI_wvalid(axi_interconnect_0_M02_AXI_WVALID),
        .M03_ACLK(microblaze_0_Clk),
        .M03_ARESETN(rst_Clk_100M_peripheral_aresetn),
        .M03_AXI_araddr(axi_interconnect_0_M03_AXI_ARADDR),
        .M03_AXI_arready(axi_interconnect_0_M03_AXI_ARREADY),
        .M03_AXI_arvalid(axi_interconnect_0_M03_AXI_ARVALID),
        .M03_AXI_awaddr(axi_interconnect_0_M03_AXI_AWADDR),
        .M03_AXI_awready(axi_interconnect_0_M03_AXI_AWREADY),
        .M03_AXI_awvalid(axi_interconnect_0_M03_AXI_AWVALID),
        .M03_AXI_bready(axi_interconnect_0_M03_AXI_BREADY),
        .M03_AXI_bresp(axi_interconnect_0_M03_AXI_BRESP),
        .M03_AXI_bvalid(axi_interconnect_0_M03_AXI_BVALID),
        .M03_AXI_rdata(axi_interconnect_0_M03_AXI_RDATA),
        .M03_AXI_rready(axi_interconnect_0_M03_AXI_RREADY),
        .M03_AXI_rresp(axi_interconnect_0_M03_AXI_RRESP),
        .M03_AXI_rvalid(axi_interconnect_0_M03_AXI_RVALID),
        .M03_AXI_wdata(axi_interconnect_0_M03_AXI_WDATA),
        .M03_AXI_wready(axi_interconnect_0_M03_AXI_WREADY),
        .M03_AXI_wstrb(axi_interconnect_0_M03_AXI_WSTRB),
        .M03_AXI_wvalid(axi_interconnect_0_M03_AXI_WVALID),
        .S00_ACLK(microblaze_0_Clk),
        .S00_ARESETN(rst_Clk_100M_peripheral_aresetn),
        .S00_AXI_araddr(microblaze_0_M_AXI_DP_ARADDR),
        .S00_AXI_arprot(microblaze_0_M_AXI_DP_ARPROT),
        .S00_AXI_arready(microblaze_0_M_AXI_DP_ARREADY),
        .S00_AXI_arvalid(microblaze_0_M_AXI_DP_ARVALID),
        .S00_AXI_awaddr(microblaze_0_M_AXI_DP_AWADDR),
        .S00_AXI_awprot(microblaze_0_M_AXI_DP_AWPROT),
        .S00_AXI_awready(microblaze_0_M_AXI_DP_AWREADY),
        .S00_AXI_awvalid(microblaze_0_M_AXI_DP_AWVALID),
        .S00_AXI_bready(microblaze_0_M_AXI_DP_BREADY),
        .S00_AXI_bresp(microblaze_0_M_AXI_DP_BRESP),
        .S00_AXI_bvalid(microblaze_0_M_AXI_DP_BVALID),
        .S00_AXI_rdata(microblaze_0_M_AXI_DP_RDATA),
        .S00_AXI_rready(microblaze_0_M_AXI_DP_RREADY),
        .S00_AXI_rresp(microblaze_0_M_AXI_DP_RRESP),
        .S00_AXI_rvalid(microblaze_0_M_AXI_DP_RVALID),
        .S00_AXI_wdata(microblaze_0_M_AXI_DP_WDATA),
        .S00_AXI_wready(microblaze_0_M_AXI_DP_WREADY),
        .S00_AXI_wstrb(microblaze_0_M_AXI_DP_WSTRB),
        .S00_AXI_wvalid(microblaze_0_M_AXI_DP_WVALID));
  design_1_axi_uartlite_0_1 axi_uartlite_0
       (.rx(axi_uartlite_0_UART_RxD),
        .s_axi_aclk(microblaze_0_Clk),
        .s_axi_araddr(axi_interconnect_0_M02_AXI_ARADDR[3:0]),
        .s_axi_aresetn(rst_Clk_100M_peripheral_aresetn),
        .s_axi_arready(axi_interconnect_0_M02_AXI_ARREADY),
        .s_axi_arvalid(axi_interconnect_0_M02_AXI_ARVALID),
        .s_axi_awaddr(axi_interconnect_0_M02_AXI_AWADDR[3:0]),
        .s_axi_awready(axi_interconnect_0_M02_AXI_AWREADY),
        .s_axi_awvalid(axi_interconnect_0_M02_AXI_AWVALID),
        .s_axi_bready(axi_interconnect_0_M02_AXI_BREADY),
        .s_axi_bresp(axi_interconnect_0_M02_AXI_BRESP),
        .s_axi_bvalid(axi_interconnect_0_M02_AXI_BVALID),
        .s_axi_rdata(axi_interconnect_0_M02_AXI_RDATA),
        .s_axi_rready(axi_interconnect_0_M02_AXI_RREADY),
        .s_axi_rresp(axi_interconnect_0_M02_AXI_RRESP),
        .s_axi_rvalid(axi_interconnect_0_M02_AXI_RVALID),
        .s_axi_wdata(axi_interconnect_0_M02_AXI_WDATA),
        .s_axi_wready(axi_interconnect_0_M02_AXI_WREADY),
        .s_axi_wstrb(axi_interconnect_0_M02_AXI_WSTRB),
        .s_axi_wvalid(axi_interconnect_0_M02_AXI_WVALID),
        .tx(axi_uartlite_0_UART_TxD));
  design_1_mdm_1_1 mdm_1
       (.Dbg_Capture_0(microblaze_0_debug_CAPTURE),
        .Dbg_Clk_0(microblaze_0_debug_CLK),
        .Dbg_Disable_0(microblaze_0_debug_DISABLE),
        .Dbg_Reg_En_0(microblaze_0_debug_REG_EN),
        .Dbg_Rst_0(microblaze_0_debug_RST),
        .Dbg_Shift_0(microblaze_0_debug_SHIFT),
        .Dbg_TDI_0(microblaze_0_debug_TDI),
        .Dbg_TDO_0(microblaze_0_debug_TDO),
        .Dbg_Update_0(microblaze_0_debug_UPDATE),
        .Debug_SYS_Rst(mdm_1_debug_sys_rst));
  (* BMM_INFO_PROCESSOR = "microblaze-le > design_1 microblaze_0_local_memory/dlmb_bram_if_cntlr" *) 
  (* KEEP_HIERARCHY = "yes" *) 
  design_1_microblaze_0_1 microblaze_0
       (.Byte_Enable(microblaze_0_dlmb_1_BE),
        .Clk(microblaze_0_Clk),
        .DCE(microblaze_0_dlmb_1_CE),
        .DReady(microblaze_0_dlmb_1_READY),
        .DUE(microblaze_0_dlmb_1_UE),
        .DWait(microblaze_0_dlmb_1_WAIT),
        .D_AS(microblaze_0_dlmb_1_ADDRSTROBE),
        .Data_Addr(microblaze_0_dlmb_1_ABUS),
        .Data_Read(microblaze_0_dlmb_1_READDBUS),
        .Data_Write(microblaze_0_dlmb_1_WRITEDBUS),
        .Dbg_Capture(microblaze_0_debug_CAPTURE),
        .Dbg_Clk(microblaze_0_debug_CLK),
        .Dbg_Disable(microblaze_0_debug_DISABLE),
        .Dbg_Reg_En(microblaze_0_debug_REG_EN),
        .Dbg_Shift(microblaze_0_debug_SHIFT),
        .Dbg_TDI(microblaze_0_debug_TDI),
        .Dbg_TDO(microblaze_0_debug_TDO),
        .Dbg_Update(microblaze_0_debug_UPDATE),
        .Debug_Rst(microblaze_0_debug_RST),
        .ICE(microblaze_0_ilmb_1_CE),
        .IFetch(microblaze_0_ilmb_1_READSTROBE),
        .IReady(microblaze_0_ilmb_1_READY),
        .IUE(microblaze_0_ilmb_1_UE),
        .IWAIT(microblaze_0_ilmb_1_WAIT),
        .I_AS(microblaze_0_ilmb_1_ADDRSTROBE),
        .Instr(microblaze_0_ilmb_1_READDBUS),
        .Instr_Addr(microblaze_0_ilmb_1_ABUS),
        .Interrupt(1'b0),
        .Interrupt_Address({1'b0,1'b0,1'b0,1'b0,1'b0,1'b0,1'b0,1'b0,1'b0,1'b0,1'b0,1'b0,1'b0,1'b0,1'b0,1'b0,1'b0,1'b0,1'b0,1'b0,1'b0,1'b0,1'b0,1'b0,1'b0,1'b0,1'b0,1'b0,1'b0,1'b0,1'b0,1'b0}),
        .M_AXI_DP_ARADDR(microblaze_0_M_AXI_DP_ARADDR),
        .M_AXI_DP_ARPROT(microblaze_0_M_AXI_DP_ARPROT),
        .M_AXI_DP_ARREADY(microblaze_0_M_AXI_DP_ARREADY),
        .M_AXI_DP_ARVALID(microblaze_0_M_AXI_DP_ARVALID),
        .M_AXI_DP_AWADDR(microblaze_0_M_AXI_DP_AWADDR),
        .M_AXI_DP_AWPROT(microblaze_0_M_AXI_DP_AWPROT),
        .M_AXI_DP_AWREADY(microblaze_0_M_AXI_DP_AWREADY),
        .M_AXI_DP_AWVALID(microblaze_0_M_AXI_DP_AWVALID),
        .M_AXI_DP_BREADY(microblaze_0_M_AXI_DP_BREADY),
        .M_AXI_DP_BRESP(microblaze_0_M_AXI_DP_BRESP),
        .M_AXI_DP_BVALID(microblaze_0_M_AXI_DP_BVALID),
        .M_AXI_DP_RDATA(microblaze_0_M_AXI_DP_RDATA),
        .M_AXI_DP_RREADY(microblaze_0_M_AXI_DP_RREADY),
        .M_AXI_DP_RRESP(microblaze_0_M_AXI_DP_RRESP),
        .M_AXI_DP_RVALID(microblaze_0_M_AXI_DP_RVALID),
        .M_AXI_DP_WDATA(microblaze_0_M_AXI_DP_WDATA),
        .M_AXI_DP_WREADY(microblaze_0_M_AXI_DP_WREADY),
        .M_AXI_DP_WSTRB(microblaze_0_M_AXI_DP_WSTRB),
        .M_AXI_DP_WVALID(microblaze_0_M_AXI_DP_WVALID),
        .Read_Strobe(microblaze_0_dlmb_1_READSTROBE),
        .Reset(rst_Clk_100M_mb_reset),
        .Write_Strobe(microblaze_0_dlmb_1_WRITESTROBE));
  microblaze_0_local_memory_imp_1K0VQXK microblaze_0_local_memory
       (.Clk(microblaze_0_Clk),
        .DLMB_abus(microblaze_0_dlmb_1_ABUS),
        .DLMB_addrstrobe(microblaze_0_dlmb_1_ADDRSTROBE),
        .DLMB_be(microblaze_0_dlmb_1_BE),
        .DLMB_ce(microblaze_0_dlmb_1_CE),
        .DLMB_readdbus(microblaze_0_dlmb_1_READDBUS),
        .DLMB_readstrobe(microblaze_0_dlmb_1_READSTROBE),
        .DLMB_ready(microblaze_0_dlmb_1_READY),
        .DLMB_ue(microblaze_0_dlmb_1_UE),
        .DLMB_wait(microblaze_0_dlmb_1_WAIT),
        .DLMB_writedbus(microblaze_0_dlmb_1_WRITEDBUS),
        .DLMB_writestrobe(microblaze_0_dlmb_1_WRITESTROBE),
        .ILMB_abus(microblaze_0_ilmb_1_ABUS),
        .ILMB_addrstrobe(microblaze_0_ilmb_1_ADDRSTROBE),
        .ILMB_ce(microblaze_0_ilmb_1_CE),
        .ILMB_readdbus(microblaze_0_ilmb_1_READDBUS),
        .ILMB_readstrobe(microblaze_0_ilmb_1_READSTROBE),
        .ILMB_ready(microblaze_0_ilmb_1_READY),
        .ILMB_ue(microblaze_0_ilmb_1_UE),
        .ILMB_wait(microblaze_0_ilmb_1_WAIT),
        .SYS_Rst(rst_Clk_100M_bus_struct_reset));
  design_1_rst_Clk_100M_0 rst_Clk_100M
       (.aux_reset_in(1'b1),
        .bus_struct_reset(rst_Clk_100M_bus_struct_reset),
        .dcm_locked(1'b1),
        .ext_reset_in(ext_reset_in_0_1),
        .interconnect_aresetn(rst_Clk_100M_interconnect_aresetn),
        .mb_debug_sys_rst(mdm_1_debug_sys_rst),
        .mb_reset(rst_Clk_100M_mb_reset),
        .peripheral_aresetn(rst_Clk_100M_peripheral_aresetn),
        .slowest_sync_clk(microblaze_0_Clk));
  design_1_xlconcat_0_0 xlconcat_0
       (.In0(In0_0_1),
        .In1(xlconstant_0_dout),
        .dout(xlconcat_0_dout));
  design_1_xlconstant_0_0 xlconstant_0
       (.dout(xlconstant_0_dout));
  design_1_xlslice_0_0 xlslice_0
       (.Din(axi_gpio_2_gpio_io_o),
        .Dout(xlslice_0_Dout));
  design_1_xlslice_0_1 xlslice_1
       (.Din(axi_gpio_2_gpio_io_o),
        .Dout(xlslice_1_Dout));
  design_1_xlslice_1_0 xlslice_2
       (.Din(axi_gpio_2_gpio_io_o),
        .Dout(xlslice_2_Dout));
endmodule

module design_1_axi_interconnect_0_0
   (ACLK,
    ARESETN,
    M00_ACLK,
    M00_ARESETN,
    M00_AXI_araddr,
    M00_AXI_arready,
    M00_AXI_arvalid,
    M00_AXI_awaddr,
    M00_AXI_awready,
    M00_AXI_awvalid,
    M00_AXI_bready,
    M00_AXI_bresp,
    M00_AXI_bvalid,
    M00_AXI_rdata,
    M00_AXI_rready,
    M00_AXI_rresp,
    M00_AXI_rvalid,
    M00_AXI_wdata,
    M00_AXI_wready,
    M00_AXI_wstrb,
    M00_AXI_wvalid,
    M01_ACLK,
    M01_ARESETN,
    M01_AXI_araddr,
    M01_AXI_arready,
    M01_AXI_arvalid,
    M01_AXI_awaddr,
    M01_AXI_awready,
    M01_AXI_awvalid,
    M01_AXI_bready,
    M01_AXI_bresp,
    M01_AXI_bvalid,
    M01_AXI_rdata,
    M01_AXI_rready,
    M01_AXI_rresp,
    M01_AXI_rvalid,
    M01_AXI_wdata,
    M01_AXI_wready,
    M01_AXI_wstrb,
    M01_AXI_wvalid,
    M02_ACLK,
    M02_ARESETN,
    M02_AXI_araddr,
    M02_AXI_arready,
    M02_AXI_arvalid,
    M02_AXI_awaddr,
    M02_AXI_awready,
    M02_AXI_awvalid,
    M02_AXI_bready,
    M02_AXI_bresp,
    M02_AXI_bvalid,
    M02_AXI_rdata,
    M02_AXI_rready,
    M02_AXI_rresp,
    M02_AXI_rvalid,
    M02_AXI_wdata,
    M02_AXI_wready,
    M02_AXI_wstrb,
    M02_AXI_wvalid,
    M03_ACLK,
    M03_ARESETN,
    M03_AXI_araddr,
    M03_AXI_arready,
    M03_AXI_arvalid,
    M03_AXI_awaddr,
    M03_AXI_awready,
    M03_AXI_awvalid,
    M03_AXI_bready,
    M03_AXI_bresp,
    M03_AXI_bvalid,
    M03_AXI_rdata,
    M03_AXI_rready,
    M03_AXI_rresp,
    M03_AXI_rvalid,
    M03_AXI_wdata,
    M03_AXI_wready,
    M03_AXI_wstrb,
    M03_AXI_wvalid,
    S00_ACLK,
    S00_ARESETN,
    S00_AXI_araddr,
    S00_AXI_arprot,
    S00_AXI_arready,
    S00_AXI_arvalid,
    S00_AXI_awaddr,
    S00_AXI_awprot,
    S00_AXI_awready,
    S00_AXI_awvalid,
    S00_AXI_bready,
    S00_AXI_bresp,
    S00_AXI_bvalid,
    S00_AXI_rdata,
    S00_AXI_rready,
    S00_AXI_rresp,
    S00_AXI_rvalid,
    S00_AXI_wdata,
    S00_AXI_wready,
    S00_AXI_wstrb,
    S00_AXI_wvalid);
  input ACLK;
  input ARESETN;
  input M00_ACLK;
  input M00_ARESETN;
  output [31:0]M00_AXI_araddr;
  input M00_AXI_arready;
  output M00_AXI_arvalid;
  output [31:0]M00_AXI_awaddr;
  input M00_AXI_awready;
  output M00_AXI_awvalid;
  output M00_AXI_bready;
  input [1:0]M00_AXI_bresp;
  input M00_AXI_bvalid;
  input [31:0]M00_AXI_rdata;
  output M00_AXI_rready;
  input [1:0]M00_AXI_rresp;
  input M00_AXI_rvalid;
  output [31:0]M00_AXI_wdata;
  input M00_AXI_wready;
  output [3:0]M00_AXI_wstrb;
  output M00_AXI_wvalid;
  input M01_ACLK;
  input M01_ARESETN;
  output [31:0]M01_AXI_araddr;
  input M01_AXI_arready;
  output M01_AXI_arvalid;
  output [31:0]M01_AXI_awaddr;
  input M01_AXI_awready;
  output M01_AXI_awvalid;
  output M01_AXI_bready;
  input [1:0]M01_AXI_bresp;
  input M01_AXI_bvalid;
  input [31:0]M01_AXI_rdata;
  output M01_AXI_rready;
  input [1:0]M01_AXI_rresp;
  input M01_AXI_rvalid;
  output [31:0]M01_AXI_wdata;
  input M01_AXI_wready;
  output [3:0]M01_AXI_wstrb;
  output M01_AXI_wvalid;
  input M02_ACLK;
  input M02_ARESETN;
  output [31:0]M02_AXI_araddr;
  input M02_AXI_arready;
  output M02_AXI_arvalid;
  output [31:0]M02_AXI_awaddr;
  input M02_AXI_awready;
  output M02_AXI_awvalid;
  output M02_AXI_bready;
  input [1:0]M02_AXI_bresp;
  input M02_AXI_bvalid;
  input [31:0]M02_AXI_rdata;
  output M02_AXI_rready;
  input [1:0]M02_AXI_rresp;
  input M02_AXI_rvalid;
  output [31:0]M02_AXI_wdata;
  input M02_AXI_wready;
  output [3:0]M02_AXI_wstrb;
  output M02_AXI_wvalid;
  input M03_ACLK;
  input M03_ARESETN;
  output [31:0]M03_AXI_araddr;
  input M03_AXI_arready;
  output M03_AXI_arvalid;
  output [31:0]M03_AXI_awaddr;
  input M03_AXI_awready;
  output M03_AXI_awvalid;
  output M03_AXI_bready;
  input [1:0]M03_AXI_bresp;
  input M03_AXI_bvalid;
  input [31:0]M03_AXI_rdata;
  output M03_AXI_rready;
  input [1:0]M03_AXI_rresp;
  input M03_AXI_rvalid;
  output [31:0]M03_AXI_wdata;
  input M03_AXI_wready;
  output [3:0]M03_AXI_wstrb;
  output M03_AXI_wvalid;
  input S00_ACLK;
  input S00_ARESETN;
  input [31:0]S00_AXI_araddr;
  input [2:0]S00_AXI_arprot;
  output [0:0]S00_AXI_arready;
  input [0:0]S00_AXI_arvalid;
  input [31:0]S00_AXI_awaddr;
  input [2:0]S00_AXI_awprot;
  output [0:0]S00_AXI_awready;
  input [0:0]S00_AXI_awvalid;
  input [0:0]S00_AXI_bready;
  output [1:0]S00_AXI_bresp;
  output [0:0]S00_AXI_bvalid;
  output [31:0]S00_AXI_rdata;
  input [0:0]S00_AXI_rready;
  output [1:0]S00_AXI_rresp;
  output [0:0]S00_AXI_rvalid;
  input [31:0]S00_AXI_wdata;
  output [0:0]S00_AXI_wready;
  input [3:0]S00_AXI_wstrb;
  input [0:0]S00_AXI_wvalid;

  wire M00_ACLK_1;
  wire M00_ARESETN_1;
  wire M01_ACLK_1;
  wire M01_ARESETN_1;
  wire M02_ACLK_1;
  wire M02_ARESETN_1;
  wire M03_ACLK_1;
  wire M03_ARESETN_1;
  wire S00_ACLK_1;
  wire S00_ARESETN_1;
  wire axi_interconnect_0_ACLK_net;
  wire axi_interconnect_0_ARESETN_net;
  wire [31:0]axi_interconnect_0_to_s00_couplers_ARADDR;
  wire [2:0]axi_interconnect_0_to_s00_couplers_ARPROT;
  wire [0:0]axi_interconnect_0_to_s00_couplers_ARREADY;
  wire [0:0]axi_interconnect_0_to_s00_couplers_ARVALID;
  wire [31:0]axi_interconnect_0_to_s00_couplers_AWADDR;
  wire [2:0]axi_interconnect_0_to_s00_couplers_AWPROT;
  wire [0:0]axi_interconnect_0_to_s00_couplers_AWREADY;
  wire [0:0]axi_interconnect_0_to_s00_couplers_AWVALID;
  wire [0:0]axi_interconnect_0_to_s00_couplers_BREADY;
  wire [1:0]axi_interconnect_0_to_s00_couplers_BRESP;
  wire [0:0]axi_interconnect_0_to_s00_couplers_BVALID;
  wire [31:0]axi_interconnect_0_to_s00_couplers_RDATA;
  wire [0:0]axi_interconnect_0_to_s00_couplers_RREADY;
  wire [1:0]axi_interconnect_0_to_s00_couplers_RRESP;
  wire [0:0]axi_interconnect_0_to_s00_couplers_RVALID;
  wire [31:0]axi_interconnect_0_to_s00_couplers_WDATA;
  wire [0:0]axi_interconnect_0_to_s00_couplers_WREADY;
  wire [3:0]axi_interconnect_0_to_s00_couplers_WSTRB;
  wire [0:0]axi_interconnect_0_to_s00_couplers_WVALID;
  wire [31:0]m00_couplers_to_axi_interconnect_0_ARADDR;
  wire m00_couplers_to_axi_interconnect_0_ARREADY;
  wire m00_couplers_to_axi_interconnect_0_ARVALID;
  wire [31:0]m00_couplers_to_axi_interconnect_0_AWADDR;
  wire m00_couplers_to_axi_interconnect_0_AWREADY;
  wire m00_couplers_to_axi_interconnect_0_AWVALID;
  wire m00_couplers_to_axi_interconnect_0_BREADY;
  wire [1:0]m00_couplers_to_axi_interconnect_0_BRESP;
  wire m00_couplers_to_axi_interconnect_0_BVALID;
  wire [31:0]m00_couplers_to_axi_interconnect_0_RDATA;
  wire m00_couplers_to_axi_interconnect_0_RREADY;
  wire [1:0]m00_couplers_to_axi_interconnect_0_RRESP;
  wire m00_couplers_to_axi_interconnect_0_RVALID;
  wire [31:0]m00_couplers_to_axi_interconnect_0_WDATA;
  wire m00_couplers_to_axi_interconnect_0_WREADY;
  wire [3:0]m00_couplers_to_axi_interconnect_0_WSTRB;
  wire m00_couplers_to_axi_interconnect_0_WVALID;
  wire [31:0]m01_couplers_to_axi_interconnect_0_ARADDR;
  wire m01_couplers_to_axi_interconnect_0_ARREADY;
  wire m01_couplers_to_axi_interconnect_0_ARVALID;
  wire [31:0]m01_couplers_to_axi_interconnect_0_AWADDR;
  wire m01_couplers_to_axi_interconnect_0_AWREADY;
  wire m01_couplers_to_axi_interconnect_0_AWVALID;
  wire m01_couplers_to_axi_interconnect_0_BREADY;
  wire [1:0]m01_couplers_to_axi_interconnect_0_BRESP;
  wire m01_couplers_to_axi_interconnect_0_BVALID;
  wire [31:0]m01_couplers_to_axi_interconnect_0_RDATA;
  wire m01_couplers_to_axi_interconnect_0_RREADY;
  wire [1:0]m01_couplers_to_axi_interconnect_0_RRESP;
  wire m01_couplers_to_axi_interconnect_0_RVALID;
  wire [31:0]m01_couplers_to_axi_interconnect_0_WDATA;
  wire m01_couplers_to_axi_interconnect_0_WREADY;
  wire [3:0]m01_couplers_to_axi_interconnect_0_WSTRB;
  wire m01_couplers_to_axi_interconnect_0_WVALID;
  wire [31:0]m02_couplers_to_axi_interconnect_0_ARADDR;
  wire m02_couplers_to_axi_interconnect_0_ARREADY;
  wire m02_couplers_to_axi_interconnect_0_ARVALID;
  wire [31:0]m02_couplers_to_axi_interconnect_0_AWADDR;
  wire m02_couplers_to_axi_interconnect_0_AWREADY;
  wire m02_couplers_to_axi_interconnect_0_AWVALID;
  wire m02_couplers_to_axi_interconnect_0_BREADY;
  wire [1:0]m02_couplers_to_axi_interconnect_0_BRESP;
  wire m02_couplers_to_axi_interconnect_0_BVALID;
  wire [31:0]m02_couplers_to_axi_interconnect_0_RDATA;
  wire m02_couplers_to_axi_interconnect_0_RREADY;
  wire [1:0]m02_couplers_to_axi_interconnect_0_RRESP;
  wire m02_couplers_to_axi_interconnect_0_RVALID;
  wire [31:0]m02_couplers_to_axi_interconnect_0_WDATA;
  wire m02_couplers_to_axi_interconnect_0_WREADY;
  wire [3:0]m02_couplers_to_axi_interconnect_0_WSTRB;
  wire m02_couplers_to_axi_interconnect_0_WVALID;
  wire [31:0]m03_couplers_to_axi_interconnect_0_ARADDR;
  wire m03_couplers_to_axi_interconnect_0_ARREADY;
  wire m03_couplers_to_axi_interconnect_0_ARVALID;
  wire [31:0]m03_couplers_to_axi_interconnect_0_AWADDR;
  wire m03_couplers_to_axi_interconnect_0_AWREADY;
  wire m03_couplers_to_axi_interconnect_0_AWVALID;
  wire m03_couplers_to_axi_interconnect_0_BREADY;
  wire [1:0]m03_couplers_to_axi_interconnect_0_BRESP;
  wire m03_couplers_to_axi_interconnect_0_BVALID;
  wire [31:0]m03_couplers_to_axi_interconnect_0_RDATA;
  wire m03_couplers_to_axi_interconnect_0_RREADY;
  wire [1:0]m03_couplers_to_axi_interconnect_0_RRESP;
  wire m03_couplers_to_axi_interconnect_0_RVALID;
  wire [31:0]m03_couplers_to_axi_interconnect_0_WDATA;
  wire m03_couplers_to_axi_interconnect_0_WREADY;
  wire [3:0]m03_couplers_to_axi_interconnect_0_WSTRB;
  wire m03_couplers_to_axi_interconnect_0_WVALID;
  wire [31:0]s00_couplers_to_xbar_ARADDR;
  wire [2:0]s00_couplers_to_xbar_ARPROT;
  wire [0:0]s00_couplers_to_xbar_ARREADY;
  wire [0:0]s00_couplers_to_xbar_ARVALID;
  wire [31:0]s00_couplers_to_xbar_AWADDR;
  wire [2:0]s00_couplers_to_xbar_AWPROT;
  wire [0:0]s00_couplers_to_xbar_AWREADY;
  wire [0:0]s00_couplers_to_xbar_AWVALID;
  wire [0:0]s00_couplers_to_xbar_BREADY;
  wire [1:0]s00_couplers_to_xbar_BRESP;
  wire [0:0]s00_couplers_to_xbar_BVALID;
  wire [31:0]s00_couplers_to_xbar_RDATA;
  wire [0:0]s00_couplers_to_xbar_RREADY;
  wire [1:0]s00_couplers_to_xbar_RRESP;
  wire [0:0]s00_couplers_to_xbar_RVALID;
  wire [31:0]s00_couplers_to_xbar_WDATA;
  wire [0:0]s00_couplers_to_xbar_WREADY;
  wire [3:0]s00_couplers_to_xbar_WSTRB;
  wire [0:0]s00_couplers_to_xbar_WVALID;
  wire [31:0]xbar_to_m00_couplers_ARADDR;
  wire xbar_to_m00_couplers_ARREADY;
  wire [0:0]xbar_to_m00_couplers_ARVALID;
  wire [31:0]xbar_to_m00_couplers_AWADDR;
  wire xbar_to_m00_couplers_AWREADY;
  wire [0:0]xbar_to_m00_couplers_AWVALID;
  wire [0:0]xbar_to_m00_couplers_BREADY;
  wire [1:0]xbar_to_m00_couplers_BRESP;
  wire xbar_to_m00_couplers_BVALID;
  wire [31:0]xbar_to_m00_couplers_RDATA;
  wire [0:0]xbar_to_m00_couplers_RREADY;
  wire [1:0]xbar_to_m00_couplers_RRESP;
  wire xbar_to_m00_couplers_RVALID;
  wire [31:0]xbar_to_m00_couplers_WDATA;
  wire xbar_to_m00_couplers_WREADY;
  wire [3:0]xbar_to_m00_couplers_WSTRB;
  wire [0:0]xbar_to_m00_couplers_WVALID;
  wire [63:32]xbar_to_m01_couplers_ARADDR;
  wire xbar_to_m01_couplers_ARREADY;
  wire [1:1]xbar_to_m01_couplers_ARVALID;
  wire [63:32]xbar_to_m01_couplers_AWADDR;
  wire xbar_to_m01_couplers_AWREADY;
  wire [1:1]xbar_to_m01_couplers_AWVALID;
  wire [1:1]xbar_to_m01_couplers_BREADY;
  wire [1:0]xbar_to_m01_couplers_BRESP;
  wire xbar_to_m01_couplers_BVALID;
  wire [31:0]xbar_to_m01_couplers_RDATA;
  wire [1:1]xbar_to_m01_couplers_RREADY;
  wire [1:0]xbar_to_m01_couplers_RRESP;
  wire xbar_to_m01_couplers_RVALID;
  wire [63:32]xbar_to_m01_couplers_WDATA;
  wire xbar_to_m01_couplers_WREADY;
  wire [7:4]xbar_to_m01_couplers_WSTRB;
  wire [1:1]xbar_to_m01_couplers_WVALID;
  wire [95:64]xbar_to_m02_couplers_ARADDR;
  wire xbar_to_m02_couplers_ARREADY;
  wire [2:2]xbar_to_m02_couplers_ARVALID;
  wire [95:64]xbar_to_m02_couplers_AWADDR;
  wire xbar_to_m02_couplers_AWREADY;
  wire [2:2]xbar_to_m02_couplers_AWVALID;
  wire [2:2]xbar_to_m02_couplers_BREADY;
  wire [1:0]xbar_to_m02_couplers_BRESP;
  wire xbar_to_m02_couplers_BVALID;
  wire [31:0]xbar_to_m02_couplers_RDATA;
  wire [2:2]xbar_to_m02_couplers_RREADY;
  wire [1:0]xbar_to_m02_couplers_RRESP;
  wire xbar_to_m02_couplers_RVALID;
  wire [95:64]xbar_to_m02_couplers_WDATA;
  wire xbar_to_m02_couplers_WREADY;
  wire [11:8]xbar_to_m02_couplers_WSTRB;
  wire [2:2]xbar_to_m02_couplers_WVALID;
  wire [127:96]xbar_to_m03_couplers_ARADDR;
  wire xbar_to_m03_couplers_ARREADY;
  wire [3:3]xbar_to_m03_couplers_ARVALID;
  wire [127:96]xbar_to_m03_couplers_AWADDR;
  wire xbar_to_m03_couplers_AWREADY;
  wire [3:3]xbar_to_m03_couplers_AWVALID;
  wire [3:3]xbar_to_m03_couplers_BREADY;
  wire [1:0]xbar_to_m03_couplers_BRESP;
  wire xbar_to_m03_couplers_BVALID;
  wire [31:0]xbar_to_m03_couplers_RDATA;
  wire [3:3]xbar_to_m03_couplers_RREADY;
  wire [1:0]xbar_to_m03_couplers_RRESP;
  wire xbar_to_m03_couplers_RVALID;
  wire [127:96]xbar_to_m03_couplers_WDATA;
  wire xbar_to_m03_couplers_WREADY;
  wire [15:12]xbar_to_m03_couplers_WSTRB;
  wire [3:3]xbar_to_m03_couplers_WVALID;

  assign M00_ACLK_1 = M00_ACLK;
  assign M00_ARESETN_1 = M00_ARESETN;
  assign M00_AXI_araddr[31:0] = m00_couplers_to_axi_interconnect_0_ARADDR;
  assign M00_AXI_arvalid = m00_couplers_to_axi_interconnect_0_ARVALID;
  assign M00_AXI_awaddr[31:0] = m00_couplers_to_axi_interconnect_0_AWADDR;
  assign M00_AXI_awvalid = m00_couplers_to_axi_interconnect_0_AWVALID;
  assign M00_AXI_bready = m00_couplers_to_axi_interconnect_0_BREADY;
  assign M00_AXI_rready = m00_couplers_to_axi_interconnect_0_RREADY;
  assign M00_AXI_wdata[31:0] = m00_couplers_to_axi_interconnect_0_WDATA;
  assign M00_AXI_wstrb[3:0] = m00_couplers_to_axi_interconnect_0_WSTRB;
  assign M00_AXI_wvalid = m00_couplers_to_axi_interconnect_0_WVALID;
  assign M01_ACLK_1 = M01_ACLK;
  assign M01_ARESETN_1 = M01_ARESETN;
  assign M01_AXI_araddr[31:0] = m01_couplers_to_axi_interconnect_0_ARADDR;
  assign M01_AXI_arvalid = m01_couplers_to_axi_interconnect_0_ARVALID;
  assign M01_AXI_awaddr[31:0] = m01_couplers_to_axi_interconnect_0_AWADDR;
  assign M01_AXI_awvalid = m01_couplers_to_axi_interconnect_0_AWVALID;
  assign M01_AXI_bready = m01_couplers_to_axi_interconnect_0_BREADY;
  assign M01_AXI_rready = m01_couplers_to_axi_interconnect_0_RREADY;
  assign M01_AXI_wdata[31:0] = m01_couplers_to_axi_interconnect_0_WDATA;
  assign M01_AXI_wstrb[3:0] = m01_couplers_to_axi_interconnect_0_WSTRB;
  assign M01_AXI_wvalid = m01_couplers_to_axi_interconnect_0_WVALID;
  assign M02_ACLK_1 = M02_ACLK;
  assign M02_ARESETN_1 = M02_ARESETN;
  assign M02_AXI_araddr[31:0] = m02_couplers_to_axi_interconnect_0_ARADDR;
  assign M02_AXI_arvalid = m02_couplers_to_axi_interconnect_0_ARVALID;
  assign M02_AXI_awaddr[31:0] = m02_couplers_to_axi_interconnect_0_AWADDR;
  assign M02_AXI_awvalid = m02_couplers_to_axi_interconnect_0_AWVALID;
  assign M02_AXI_bready = m02_couplers_to_axi_interconnect_0_BREADY;
  assign M02_AXI_rready = m02_couplers_to_axi_interconnect_0_RREADY;
  assign M02_AXI_wdata[31:0] = m02_couplers_to_axi_interconnect_0_WDATA;
  assign M02_AXI_wstrb[3:0] = m02_couplers_to_axi_interconnect_0_WSTRB;
  assign M02_AXI_wvalid = m02_couplers_to_axi_interconnect_0_WVALID;
  assign M03_ACLK_1 = M03_ACLK;
  assign M03_ARESETN_1 = M03_ARESETN;
  assign M03_AXI_araddr[31:0] = m03_couplers_to_axi_interconnect_0_ARADDR;
  assign M03_AXI_arvalid = m03_couplers_to_axi_interconnect_0_ARVALID;
  assign M03_AXI_awaddr[31:0] = m03_couplers_to_axi_interconnect_0_AWADDR;
  assign M03_AXI_awvalid = m03_couplers_to_axi_interconnect_0_AWVALID;
  assign M03_AXI_bready = m03_couplers_to_axi_interconnect_0_BREADY;
  assign M03_AXI_rready = m03_couplers_to_axi_interconnect_0_RREADY;
  assign M03_AXI_wdata[31:0] = m03_couplers_to_axi_interconnect_0_WDATA;
  assign M03_AXI_wstrb[3:0] = m03_couplers_to_axi_interconnect_0_WSTRB;
  assign M03_AXI_wvalid = m03_couplers_to_axi_interconnect_0_WVALID;
  assign S00_ACLK_1 = S00_ACLK;
  assign S00_ARESETN_1 = S00_ARESETN;
  assign S00_AXI_arready[0] = axi_interconnect_0_to_s00_couplers_ARREADY;
  assign S00_AXI_awready[0] = axi_interconnect_0_to_s00_couplers_AWREADY;
  assign S00_AXI_bresp[1:0] = axi_interconnect_0_to_s00_couplers_BRESP;
  assign S00_AXI_bvalid[0] = axi_interconnect_0_to_s00_couplers_BVALID;
  assign S00_AXI_rdata[31:0] = axi_interconnect_0_to_s00_couplers_RDATA;
  assign S00_AXI_rresp[1:0] = axi_interconnect_0_to_s00_couplers_RRESP;
  assign S00_AXI_rvalid[0] = axi_interconnect_0_to_s00_couplers_RVALID;
  assign S00_AXI_wready[0] = axi_interconnect_0_to_s00_couplers_WREADY;
  assign axi_interconnect_0_ACLK_net = ACLK;
  assign axi_interconnect_0_ARESETN_net = ARESETN;
  assign axi_interconnect_0_to_s00_couplers_ARADDR = S00_AXI_araddr[31:0];
  assign axi_interconnect_0_to_s00_couplers_ARPROT = S00_AXI_arprot[2:0];
  assign axi_interconnect_0_to_s00_couplers_ARVALID = S00_AXI_arvalid[0];
  assign axi_interconnect_0_to_s00_couplers_AWADDR = S00_AXI_awaddr[31:0];
  assign axi_interconnect_0_to_s00_couplers_AWPROT = S00_AXI_awprot[2:0];
  assign axi_interconnect_0_to_s00_couplers_AWVALID = S00_AXI_awvalid[0];
  assign axi_interconnect_0_to_s00_couplers_BREADY = S00_AXI_bready[0];
  assign axi_interconnect_0_to_s00_couplers_RREADY = S00_AXI_rready[0];
  assign axi_interconnect_0_to_s00_couplers_WDATA = S00_AXI_wdata[31:0];
  assign axi_interconnect_0_to_s00_couplers_WSTRB = S00_AXI_wstrb[3:0];
  assign axi_interconnect_0_to_s00_couplers_WVALID = S00_AXI_wvalid[0];
  assign m00_couplers_to_axi_interconnect_0_ARREADY = M00_AXI_arready;
  assign m00_couplers_to_axi_interconnect_0_AWREADY = M00_AXI_awready;
  assign m00_couplers_to_axi_interconnect_0_BRESP = M00_AXI_bresp[1:0];
  assign m00_couplers_to_axi_interconnect_0_BVALID = M00_AXI_bvalid;
  assign m00_couplers_to_axi_interconnect_0_RDATA = M00_AXI_rdata[31:0];
  assign m00_couplers_to_axi_interconnect_0_RRESP = M00_AXI_rresp[1:0];
  assign m00_couplers_to_axi_interconnect_0_RVALID = M00_AXI_rvalid;
  assign m00_couplers_to_axi_interconnect_0_WREADY = M00_AXI_wready;
  assign m01_couplers_to_axi_interconnect_0_ARREADY = M01_AXI_arready;
  assign m01_couplers_to_axi_interconnect_0_AWREADY = M01_AXI_awready;
  assign m01_couplers_to_axi_interconnect_0_BRESP = M01_AXI_bresp[1:0];
  assign m01_couplers_to_axi_interconnect_0_BVALID = M01_AXI_bvalid;
  assign m01_couplers_to_axi_interconnect_0_RDATA = M01_AXI_rdata[31:0];
  assign m01_couplers_to_axi_interconnect_0_RRESP = M01_AXI_rresp[1:0];
  assign m01_couplers_to_axi_interconnect_0_RVALID = M01_AXI_rvalid;
  assign m01_couplers_to_axi_interconnect_0_WREADY = M01_AXI_wready;
  assign m02_couplers_to_axi_interconnect_0_ARREADY = M02_AXI_arready;
  assign m02_couplers_to_axi_interconnect_0_AWREADY = M02_AXI_awready;
  assign m02_couplers_to_axi_interconnect_0_BRESP = M02_AXI_bresp[1:0];
  assign m02_couplers_to_axi_interconnect_0_BVALID = M02_AXI_bvalid;
  assign m02_couplers_to_axi_interconnect_0_RDATA = M02_AXI_rdata[31:0];
  assign m02_couplers_to_axi_interconnect_0_RRESP = M02_AXI_rresp[1:0];
  assign m02_couplers_to_axi_interconnect_0_RVALID = M02_AXI_rvalid;
  assign m02_couplers_to_axi_interconnect_0_WREADY = M02_AXI_wready;
  assign m03_couplers_to_axi_interconnect_0_ARREADY = M03_AXI_arready;
  assign m03_couplers_to_axi_interconnect_0_AWREADY = M03_AXI_awready;
  assign m03_couplers_to_axi_interconnect_0_BRESP = M03_AXI_bresp[1:0];
  assign m03_couplers_to_axi_interconnect_0_BVALID = M03_AXI_bvalid;
  assign m03_couplers_to_axi_interconnect_0_RDATA = M03_AXI_rdata[31:0];
  assign m03_couplers_to_axi_interconnect_0_RRESP = M03_AXI_rresp[1:0];
  assign m03_couplers_to_axi_interconnect_0_RVALID = M03_AXI_rvalid;
  assign m03_couplers_to_axi_interconnect_0_WREADY = M03_AXI_wready;
  m00_couplers_imp_1CA5Z32 m00_couplers
       (.M_ACLK(M00_ACLK_1),
        .M_ARESETN(M00_ARESETN_1),
        .M_AXI_araddr(m00_couplers_to_axi_interconnect_0_ARADDR),
        .M_AXI_arready(m00_couplers_to_axi_interconnect_0_ARREADY),
        .M_AXI_arvalid(m00_couplers_to_axi_interconnect_0_ARVALID),
        .M_AXI_awaddr(m00_couplers_to_axi_interconnect_0_AWADDR),
        .M_AXI_awready(m00_couplers_to_axi_interconnect_0_AWREADY),
        .M_AXI_awvalid(m00_couplers_to_axi_interconnect_0_AWVALID),
        .M_AXI_bready(m00_couplers_to_axi_interconnect_0_BREADY),
        .M_AXI_bresp(m00_couplers_to_axi_interconnect_0_BRESP),
        .M_AXI_bvalid(m00_couplers_to_axi_interconnect_0_BVALID),
        .M_AXI_rdata(m00_couplers_to_axi_interconnect_0_RDATA),
        .M_AXI_rready(m00_couplers_to_axi_interconnect_0_RREADY),
        .M_AXI_rresp(m00_couplers_to_axi_interconnect_0_RRESP),
        .M_AXI_rvalid(m00_couplers_to_axi_interconnect_0_RVALID),
        .M_AXI_wdata(m00_couplers_to_axi_interconnect_0_WDATA),
        .M_AXI_wready(m00_couplers_to_axi_interconnect_0_WREADY),
        .M_AXI_wstrb(m00_couplers_to_axi_interconnect_0_WSTRB),
        .M_AXI_wvalid(m00_couplers_to_axi_interconnect_0_WVALID),
        .S_ACLK(axi_interconnect_0_ACLK_net),
        .S_ARESETN(axi_interconnect_0_ARESETN_net),
        .S_AXI_araddr(xbar_to_m00_couplers_ARADDR),
        .S_AXI_arready(xbar_to_m00_couplers_ARREADY),
        .S_AXI_arvalid(xbar_to_m00_couplers_ARVALID),
        .S_AXI_awaddr(xbar_to_m00_couplers_AWADDR),
        .S_AXI_awready(xbar_to_m00_couplers_AWREADY),
        .S_AXI_awvalid(xbar_to_m00_couplers_AWVALID),
        .S_AXI_bready(xbar_to_m00_couplers_BREADY),
        .S_AXI_bresp(xbar_to_m00_couplers_BRESP),
        .S_AXI_bvalid(xbar_to_m00_couplers_BVALID),
        .S_AXI_rdata(xbar_to_m00_couplers_RDATA),
        .S_AXI_rready(xbar_to_m00_couplers_RREADY),
        .S_AXI_rresp(xbar_to_m00_couplers_RRESP),
        .S_AXI_rvalid(xbar_to_m00_couplers_RVALID),
        .S_AXI_wdata(xbar_to_m00_couplers_WDATA),
        .S_AXI_wready(xbar_to_m00_couplers_WREADY),
        .S_AXI_wstrb(xbar_to_m00_couplers_WSTRB),
        .S_AXI_wvalid(xbar_to_m00_couplers_WVALID));
  m01_couplers_imp_I4GRPB m01_couplers
       (.M_ACLK(M01_ACLK_1),
        .M_ARESETN(M01_ARESETN_1),
        .M_AXI_araddr(m01_couplers_to_axi_interconnect_0_ARADDR),
        .M_AXI_arready(m01_couplers_to_axi_interconnect_0_ARREADY),
        .M_AXI_arvalid(m01_couplers_to_axi_interconnect_0_ARVALID),
        .M_AXI_awaddr(m01_couplers_to_axi_interconnect_0_AWADDR),
        .M_AXI_awready(m01_couplers_to_axi_interconnect_0_AWREADY),
        .M_AXI_awvalid(m01_couplers_to_axi_interconnect_0_AWVALID),
        .M_AXI_bready(m01_couplers_to_axi_interconnect_0_BREADY),
        .M_AXI_bresp(m01_couplers_to_axi_interconnect_0_BRESP),
        .M_AXI_bvalid(m01_couplers_to_axi_interconnect_0_BVALID),
        .M_AXI_rdata(m01_couplers_to_axi_interconnect_0_RDATA),
        .M_AXI_rready(m01_couplers_to_axi_interconnect_0_RREADY),
        .M_AXI_rresp(m01_couplers_to_axi_interconnect_0_RRESP),
        .M_AXI_rvalid(m01_couplers_to_axi_interconnect_0_RVALID),
        .M_AXI_wdata(m01_couplers_to_axi_interconnect_0_WDATA),
        .M_AXI_wready(m01_couplers_to_axi_interconnect_0_WREADY),
        .M_AXI_wstrb(m01_couplers_to_axi_interconnect_0_WSTRB),
        .M_AXI_wvalid(m01_couplers_to_axi_interconnect_0_WVALID),
        .S_ACLK(axi_interconnect_0_ACLK_net),
        .S_ARESETN(axi_interconnect_0_ARESETN_net),
        .S_AXI_araddr(xbar_to_m01_couplers_ARADDR),
        .S_AXI_arready(xbar_to_m01_couplers_ARREADY),
        .S_AXI_arvalid(xbar_to_m01_couplers_ARVALID),
        .S_AXI_awaddr(xbar_to_m01_couplers_AWADDR),
        .S_AXI_awready(xbar_to_m01_couplers_AWREADY),
        .S_AXI_awvalid(xbar_to_m01_couplers_AWVALID),
        .S_AXI_bready(xbar_to_m01_couplers_BREADY),
        .S_AXI_bresp(xbar_to_m01_couplers_BRESP),
        .S_AXI_bvalid(xbar_to_m01_couplers_BVALID),
        .S_AXI_rdata(xbar_to_m01_couplers_RDATA),
        .S_AXI_rready(xbar_to_m01_couplers_RREADY),
        .S_AXI_rresp(xbar_to_m01_couplers_RRESP),
        .S_AXI_rvalid(xbar_to_m01_couplers_RVALID),
        .S_AXI_wdata(xbar_to_m01_couplers_WDATA),
        .S_AXI_wready(xbar_to_m01_couplers_WREADY),
        .S_AXI_wstrb(xbar_to_m01_couplers_WSTRB),
        .S_AXI_wvalid(xbar_to_m01_couplers_WVALID));
  m02_couplers_imp_1BOGR4T m02_couplers
       (.M_ACLK(M02_ACLK_1),
        .M_ARESETN(M02_ARESETN_1),
        .M_AXI_araddr(m02_couplers_to_axi_interconnect_0_ARADDR),
        .M_AXI_arready(m02_couplers_to_axi_interconnect_0_ARREADY),
        .M_AXI_arvalid(m02_couplers_to_axi_interconnect_0_ARVALID),
        .M_AXI_awaddr(m02_couplers_to_axi_interconnect_0_AWADDR),
        .M_AXI_awready(m02_couplers_to_axi_interconnect_0_AWREADY),
        .M_AXI_awvalid(m02_couplers_to_axi_interconnect_0_AWVALID),
        .M_AXI_bready(m02_couplers_to_axi_interconnect_0_BREADY),
        .M_AXI_bresp(m02_couplers_to_axi_interconnect_0_BRESP),
        .M_AXI_bvalid(m02_couplers_to_axi_interconnect_0_BVALID),
        .M_AXI_rdata(m02_couplers_to_axi_interconnect_0_RDATA),
        .M_AXI_rready(m02_couplers_to_axi_interconnect_0_RREADY),
        .M_AXI_rresp(m02_couplers_to_axi_interconnect_0_RRESP),
        .M_AXI_rvalid(m02_couplers_to_axi_interconnect_0_RVALID),
        .M_AXI_wdata(m02_couplers_to_axi_interconnect_0_WDATA),
        .M_AXI_wready(m02_couplers_to_axi_interconnect_0_WREADY),
        .M_AXI_wstrb(m02_couplers_to_axi_interconnect_0_WSTRB),
        .M_AXI_wvalid(m02_couplers_to_axi_interconnect_0_WVALID),
        .S_ACLK(axi_interconnect_0_ACLK_net),
        .S_ARESETN(axi_interconnect_0_ARESETN_net),
        .S_AXI_araddr(xbar_to_m02_couplers_ARADDR),
        .S_AXI_arready(xbar_to_m02_couplers_ARREADY),
        .S_AXI_arvalid(xbar_to_m02_couplers_ARVALID),
        .S_AXI_awaddr(xbar_to_m02_couplers_AWADDR),
        .S_AXI_awready(xbar_to_m02_couplers_AWREADY),
        .S_AXI_awvalid(xbar_to_m02_couplers_AWVALID),
        .S_AXI_bready(xbar_to_m02_couplers_BREADY),
        .S_AXI_bresp(xbar_to_m02_couplers_BRESP),
        .S_AXI_bvalid(xbar_to_m02_couplers_BVALID),
        .S_AXI_rdata(xbar_to_m02_couplers_RDATA),
        .S_AXI_rready(xbar_to_m02_couplers_RREADY),
        .S_AXI_rresp(xbar_to_m02_couplers_RRESP),
        .S_AXI_rvalid(xbar_to_m02_couplers_RVALID),
        .S_AXI_wdata(xbar_to_m02_couplers_WDATA),
        .S_AXI_wready(xbar_to_m02_couplers_WREADY),
        .S_AXI_wstrb(xbar_to_m02_couplers_WSTRB),
        .S_AXI_wvalid(xbar_to_m02_couplers_WVALID));
  m03_couplers_imp_J0G1J0 m03_couplers
       (.M_ACLK(M03_ACLK_1),
        .M_ARESETN(M03_ARESETN_1),
        .M_AXI_araddr(m03_couplers_to_axi_interconnect_0_ARADDR),
        .M_AXI_arready(m03_couplers_to_axi_interconnect_0_ARREADY),
        .M_AXI_arvalid(m03_couplers_to_axi_interconnect_0_ARVALID),
        .M_AXI_awaddr(m03_couplers_to_axi_interconnect_0_AWADDR),
        .M_AXI_awready(m03_couplers_to_axi_interconnect_0_AWREADY),
        .M_AXI_awvalid(m03_couplers_to_axi_interconnect_0_AWVALID),
        .M_AXI_bready(m03_couplers_to_axi_interconnect_0_BREADY),
        .M_AXI_bresp(m03_couplers_to_axi_interconnect_0_BRESP),
        .M_AXI_bvalid(m03_couplers_to_axi_interconnect_0_BVALID),
        .M_AXI_rdata(m03_couplers_to_axi_interconnect_0_RDATA),
        .M_AXI_rready(m03_couplers_to_axi_interconnect_0_RREADY),
        .M_AXI_rresp(m03_couplers_to_axi_interconnect_0_RRESP),
        .M_AXI_rvalid(m03_couplers_to_axi_interconnect_0_RVALID),
        .M_AXI_wdata(m03_couplers_to_axi_interconnect_0_WDATA),
        .M_AXI_wready(m03_couplers_to_axi_interconnect_0_WREADY),
        .M_AXI_wstrb(m03_couplers_to_axi_interconnect_0_WSTRB),
        .M_AXI_wvalid(m03_couplers_to_axi_interconnect_0_WVALID),
        .S_ACLK(axi_interconnect_0_ACLK_net),
        .S_ARESETN(axi_interconnect_0_ARESETN_net),
        .S_AXI_araddr(xbar_to_m03_couplers_ARADDR),
        .S_AXI_arready(xbar_to_m03_couplers_ARREADY),
        .S_AXI_arvalid(xbar_to_m03_couplers_ARVALID),
        .S_AXI_awaddr(xbar_to_m03_couplers_AWADDR),
        .S_AXI_awready(xbar_to_m03_couplers_AWREADY),
        .S_AXI_awvalid(xbar_to_m03_couplers_AWVALID),
        .S_AXI_bready(xbar_to_m03_couplers_BREADY),
        .S_AXI_bresp(xbar_to_m03_couplers_BRESP),
        .S_AXI_bvalid(xbar_to_m03_couplers_BVALID),
        .S_AXI_rdata(xbar_to_m03_couplers_RDATA),
        .S_AXI_rready(xbar_to_m03_couplers_RREADY),
        .S_AXI_rresp(xbar_to_m03_couplers_RRESP),
        .S_AXI_rvalid(xbar_to_m03_couplers_RVALID),
        .S_AXI_wdata(xbar_to_m03_couplers_WDATA),
        .S_AXI_wready(xbar_to_m03_couplers_WREADY),
        .S_AXI_wstrb(xbar_to_m03_couplers_WSTRB),
        .S_AXI_wvalid(xbar_to_m03_couplers_WVALID));
  s00_couplers_imp_O7FAN0 s00_couplers
       (.M_ACLK(axi_interconnect_0_ACLK_net),
        .M_ARESETN(axi_interconnect_0_ARESETN_net),
        .M_AXI_araddr(s00_couplers_to_xbar_ARADDR),
        .M_AXI_arprot(s00_couplers_to_xbar_ARPROT),
        .M_AXI_arready(s00_couplers_to_xbar_ARREADY),
        .M_AXI_arvalid(s00_couplers_to_xbar_ARVALID),
        .M_AXI_awaddr(s00_couplers_to_xbar_AWADDR),
        .M_AXI_awprot(s00_couplers_to_xbar_AWPROT),
        .M_AXI_awready(s00_couplers_to_xbar_AWREADY),
        .M_AXI_awvalid(s00_couplers_to_xbar_AWVALID),
        .M_AXI_bready(s00_couplers_to_xbar_BREADY),
        .M_AXI_bresp(s00_couplers_to_xbar_BRESP),
        .M_AXI_bvalid(s00_couplers_to_xbar_BVALID),
        .M_AXI_rdata(s00_couplers_to_xbar_RDATA),
        .M_AXI_rready(s00_couplers_to_xbar_RREADY),
        .M_AXI_rresp(s00_couplers_to_xbar_RRESP),
        .M_AXI_rvalid(s00_couplers_to_xbar_RVALID),
        .M_AXI_wdata(s00_couplers_to_xbar_WDATA),
        .M_AXI_wready(s00_couplers_to_xbar_WREADY),
        .M_AXI_wstrb(s00_couplers_to_xbar_WSTRB),
        .M_AXI_wvalid(s00_couplers_to_xbar_WVALID),
        .S_ACLK(S00_ACLK_1),
        .S_ARESETN(S00_ARESETN_1),
        .S_AXI_araddr(axi_interconnect_0_to_s00_couplers_ARADDR),
        .S_AXI_arprot(axi_interconnect_0_to_s00_couplers_ARPROT),
        .S_AXI_arready(axi_interconnect_0_to_s00_couplers_ARREADY),
        .S_AXI_arvalid(axi_interconnect_0_to_s00_couplers_ARVALID),
        .S_AXI_awaddr(axi_interconnect_0_to_s00_couplers_AWADDR),
        .S_AXI_awprot(axi_interconnect_0_to_s00_couplers_AWPROT),
        .S_AXI_awready(axi_interconnect_0_to_s00_couplers_AWREADY),
        .S_AXI_awvalid(axi_interconnect_0_to_s00_couplers_AWVALID),
        .S_AXI_bready(axi_interconnect_0_to_s00_couplers_BREADY),
        .S_AXI_bresp(axi_interconnect_0_to_s00_couplers_BRESP),
        .S_AXI_bvalid(axi_interconnect_0_to_s00_couplers_BVALID),
        .S_AXI_rdata(axi_interconnect_0_to_s00_couplers_RDATA),
        .S_AXI_rready(axi_interconnect_0_to_s00_couplers_RREADY),
        .S_AXI_rresp(axi_interconnect_0_to_s00_couplers_RRESP),
        .S_AXI_rvalid(axi_interconnect_0_to_s00_couplers_RVALID),
        .S_AXI_wdata(axi_interconnect_0_to_s00_couplers_WDATA),
        .S_AXI_wready(axi_interconnect_0_to_s00_couplers_WREADY),
        .S_AXI_wstrb(axi_interconnect_0_to_s00_couplers_WSTRB),
        .S_AXI_wvalid(axi_interconnect_0_to_s00_couplers_WVALID));
  design_1_xbar_0 xbar
       (.aclk(axi_interconnect_0_ACLK_net),
        .aresetn(axi_interconnect_0_ARESETN_net),
        .m_axi_araddr({xbar_to_m03_couplers_ARADDR,xbar_to_m02_couplers_ARADDR,xbar_to_m01_couplers_ARADDR,xbar_to_m00_couplers_ARADDR}),
        .m_axi_arready({xbar_to_m03_couplers_ARREADY,xbar_to_m02_couplers_ARREADY,xbar_to_m01_couplers_ARREADY,xbar_to_m00_couplers_ARREADY}),
        .m_axi_arvalid({xbar_to_m03_couplers_ARVALID,xbar_to_m02_couplers_ARVALID,xbar_to_m01_couplers_ARVALID,xbar_to_m00_couplers_ARVALID}),
        .m_axi_awaddr({xbar_to_m03_couplers_AWADDR,xbar_to_m02_couplers_AWADDR,xbar_to_m01_couplers_AWADDR,xbar_to_m00_couplers_AWADDR}),
        .m_axi_awready({xbar_to_m03_couplers_AWREADY,xbar_to_m02_couplers_AWREADY,xbar_to_m01_couplers_AWREADY,xbar_to_m00_couplers_AWREADY}),
        .m_axi_awvalid({xbar_to_m03_couplers_AWVALID,xbar_to_m02_couplers_AWVALID,xbar_to_m01_couplers_AWVALID,xbar_to_m00_couplers_AWVALID}),
        .m_axi_bready({xbar_to_m03_couplers_BREADY,xbar_to_m02_couplers_BREADY,xbar_to_m01_couplers_BREADY,xbar_to_m00_couplers_BREADY}),
        .m_axi_bresp({xbar_to_m03_couplers_BRESP,xbar_to_m02_couplers_BRESP,xbar_to_m01_couplers_BRESP,xbar_to_m00_couplers_BRESP}),
        .m_axi_bvalid({xbar_to_m03_couplers_BVALID,xbar_to_m02_couplers_BVALID,xbar_to_m01_couplers_BVALID,xbar_to_m00_couplers_BVALID}),
        .m_axi_rdata({xbar_to_m03_couplers_RDATA,xbar_to_m02_couplers_RDATA,xbar_to_m01_couplers_RDATA,xbar_to_m00_couplers_RDATA}),
        .m_axi_rready({xbar_to_m03_couplers_RREADY,xbar_to_m02_couplers_RREADY,xbar_to_m01_couplers_RREADY,xbar_to_m00_couplers_RREADY}),
        .m_axi_rresp({xbar_to_m03_couplers_RRESP,xbar_to_m02_couplers_RRESP,xbar_to_m01_couplers_RRESP,xbar_to_m00_couplers_RRESP}),
        .m_axi_rvalid({xbar_to_m03_couplers_RVALID,xbar_to_m02_couplers_RVALID,xbar_to_m01_couplers_RVALID,xbar_to_m00_couplers_RVALID}),
        .m_axi_wdata({xbar_to_m03_couplers_WDATA,xbar_to_m02_couplers_WDATA,xbar_to_m01_couplers_WDATA,xbar_to_m00_couplers_WDATA}),
        .m_axi_wready({xbar_to_m03_couplers_WREADY,xbar_to_m02_couplers_WREADY,xbar_to_m01_couplers_WREADY,xbar_to_m00_couplers_WREADY}),
        .m_axi_wstrb({xbar_to_m03_couplers_WSTRB,xbar_to_m02_couplers_WSTRB,xbar_to_m01_couplers_WSTRB,xbar_to_m00_couplers_WSTRB}),
        .m_axi_wvalid({xbar_to_m03_couplers_WVALID,xbar_to_m02_couplers_WVALID,xbar_to_m01_couplers_WVALID,xbar_to_m00_couplers_WVALID}),
        .s_axi_araddr(s00_couplers_to_xbar_ARADDR),
        .s_axi_arprot(s00_couplers_to_xbar_ARPROT),
        .s_axi_arready(s00_couplers_to_xbar_ARREADY),
        .s_axi_arvalid(s00_couplers_to_xbar_ARVALID),
        .s_axi_awaddr(s00_couplers_to_xbar_AWADDR),
        .s_axi_awprot(s00_couplers_to_xbar_AWPROT),
        .s_axi_awready(s00_couplers_to_xbar_AWREADY),
        .s_axi_awvalid(s00_couplers_to_xbar_AWVALID),
        .s_axi_bready(s00_couplers_to_xbar_BREADY),
        .s_axi_bresp(s00_couplers_to_xbar_BRESP),
        .s_axi_bvalid(s00_couplers_to_xbar_BVALID),
        .s_axi_rdata(s00_couplers_to_xbar_RDATA),
        .s_axi_rready(s00_couplers_to_xbar_RREADY),
        .s_axi_rresp(s00_couplers_to_xbar_RRESP),
        .s_axi_rvalid(s00_couplers_to_xbar_RVALID),
        .s_axi_wdata(s00_couplers_to_xbar_WDATA),
        .s_axi_wready(s00_couplers_to_xbar_WREADY),
        .s_axi_wstrb(s00_couplers_to_xbar_WSTRB),
        .s_axi_wvalid(s00_couplers_to_xbar_WVALID));
endmodule

module m00_couplers_imp_1CA5Z32
   (M_ACLK,
    M_ARESETN,
    M_AXI_araddr,
    M_AXI_arready,
    M_AXI_arvalid,
    M_AXI_awaddr,
    M_AXI_awready,
    M_AXI_awvalid,
    M_AXI_bready,
    M_AXI_bresp,
    M_AXI_bvalid,
    M_AXI_rdata,
    M_AXI_rready,
    M_AXI_rresp,
    M_AXI_rvalid,
    M_AXI_wdata,
    M_AXI_wready,
    M_AXI_wstrb,
    M_AXI_wvalid,
    S_ACLK,
    S_ARESETN,
    S_AXI_araddr,
    S_AXI_arready,
    S_AXI_arvalid,
    S_AXI_awaddr,
    S_AXI_awready,
    S_AXI_awvalid,
    S_AXI_bready,
    S_AXI_bresp,
    S_AXI_bvalid,
    S_AXI_rdata,
    S_AXI_rready,
    S_AXI_rresp,
    S_AXI_rvalid,
    S_AXI_wdata,
    S_AXI_wready,
    S_AXI_wstrb,
    S_AXI_wvalid);
  input M_ACLK;
  input M_ARESETN;
  output [31:0]M_AXI_araddr;
  input M_AXI_arready;
  output M_AXI_arvalid;
  output [31:0]M_AXI_awaddr;
  input M_AXI_awready;
  output M_AXI_awvalid;
  output M_AXI_bready;
  input [1:0]M_AXI_bresp;
  input M_AXI_bvalid;
  input [31:0]M_AXI_rdata;
  output M_AXI_rready;
  input [1:0]M_AXI_rresp;
  input M_AXI_rvalid;
  output [31:0]M_AXI_wdata;
  input M_AXI_wready;
  output [3:0]M_AXI_wstrb;
  output M_AXI_wvalid;
  input S_ACLK;
  input S_ARESETN;
  input [31:0]S_AXI_araddr;
  output S_AXI_arready;
  input S_AXI_arvalid;
  input [31:0]S_AXI_awaddr;
  output S_AXI_awready;
  input S_AXI_awvalid;
  input S_AXI_bready;
  output [1:0]S_AXI_bresp;
  output S_AXI_bvalid;
  output [31:0]S_AXI_rdata;
  input S_AXI_rready;
  output [1:0]S_AXI_rresp;
  output S_AXI_rvalid;
  input [31:0]S_AXI_wdata;
  output S_AXI_wready;
  input [3:0]S_AXI_wstrb;
  input S_AXI_wvalid;

  wire [31:0]m00_couplers_to_m00_couplers_ARADDR;
  wire m00_couplers_to_m00_couplers_ARREADY;
  wire m00_couplers_to_m00_couplers_ARVALID;
  wire [31:0]m00_couplers_to_m00_couplers_AWADDR;
  wire m00_couplers_to_m00_couplers_AWREADY;
  wire m00_couplers_to_m00_couplers_AWVALID;
  wire m00_couplers_to_m00_couplers_BREADY;
  wire [1:0]m00_couplers_to_m00_couplers_BRESP;
  wire m00_couplers_to_m00_couplers_BVALID;
  wire [31:0]m00_couplers_to_m00_couplers_RDATA;
  wire m00_couplers_to_m00_couplers_RREADY;
  wire [1:0]m00_couplers_to_m00_couplers_RRESP;
  wire m00_couplers_to_m00_couplers_RVALID;
  wire [31:0]m00_couplers_to_m00_couplers_WDATA;
  wire m00_couplers_to_m00_couplers_WREADY;
  wire [3:0]m00_couplers_to_m00_couplers_WSTRB;
  wire m00_couplers_to_m00_couplers_WVALID;

  assign M_AXI_araddr[31:0] = m00_couplers_to_m00_couplers_ARADDR;
  assign M_AXI_arvalid = m00_couplers_to_m00_couplers_ARVALID;
  assign M_AXI_awaddr[31:0] = m00_couplers_to_m00_couplers_AWADDR;
  assign M_AXI_awvalid = m00_couplers_to_m00_couplers_AWVALID;
  assign M_AXI_bready = m00_couplers_to_m00_couplers_BREADY;
  assign M_AXI_rready = m00_couplers_to_m00_couplers_RREADY;
  assign M_AXI_wdata[31:0] = m00_couplers_to_m00_couplers_WDATA;
  assign M_AXI_wstrb[3:0] = m00_couplers_to_m00_couplers_WSTRB;
  assign M_AXI_wvalid = m00_couplers_to_m00_couplers_WVALID;
  assign S_AXI_arready = m00_couplers_to_m00_couplers_ARREADY;
  assign S_AXI_awready = m00_couplers_to_m00_couplers_AWREADY;
  assign S_AXI_bresp[1:0] = m00_couplers_to_m00_couplers_BRESP;
  assign S_AXI_bvalid = m00_couplers_to_m00_couplers_BVALID;
  assign S_AXI_rdata[31:0] = m00_couplers_to_m00_couplers_RDATA;
  assign S_AXI_rresp[1:0] = m00_couplers_to_m00_couplers_RRESP;
  assign S_AXI_rvalid = m00_couplers_to_m00_couplers_RVALID;
  assign S_AXI_wready = m00_couplers_to_m00_couplers_WREADY;
  assign m00_couplers_to_m00_couplers_ARADDR = S_AXI_araddr[31:0];
  assign m00_couplers_to_m00_couplers_ARREADY = M_AXI_arready;
  assign m00_couplers_to_m00_couplers_ARVALID = S_AXI_arvalid;
  assign m00_couplers_to_m00_couplers_AWADDR = S_AXI_awaddr[31:0];
  assign m00_couplers_to_m00_couplers_AWREADY = M_AXI_awready;
  assign m00_couplers_to_m00_couplers_AWVALID = S_AXI_awvalid;
  assign m00_couplers_to_m00_couplers_BREADY = S_AXI_bready;
  assign m00_couplers_to_m00_couplers_BRESP = M_AXI_bresp[1:0];
  assign m00_couplers_to_m00_couplers_BVALID = M_AXI_bvalid;
  assign m00_couplers_to_m00_couplers_RDATA = M_AXI_rdata[31:0];
  assign m00_couplers_to_m00_couplers_RREADY = S_AXI_rready;
  assign m00_couplers_to_m00_couplers_RRESP = M_AXI_rresp[1:0];
  assign m00_couplers_to_m00_couplers_RVALID = M_AXI_rvalid;
  assign m00_couplers_to_m00_couplers_WDATA = S_AXI_wdata[31:0];
  assign m00_couplers_to_m00_couplers_WREADY = M_AXI_wready;
  assign m00_couplers_to_m00_couplers_WSTRB = S_AXI_wstrb[3:0];
  assign m00_couplers_to_m00_couplers_WVALID = S_AXI_wvalid;
endmodule

module m01_couplers_imp_I4GRPB
   (M_ACLK,
    M_ARESETN,
    M_AXI_araddr,
    M_AXI_arready,
    M_AXI_arvalid,
    M_AXI_awaddr,
    M_AXI_awready,
    M_AXI_awvalid,
    M_AXI_bready,
    M_AXI_bresp,
    M_AXI_bvalid,
    M_AXI_rdata,
    M_AXI_rready,
    M_AXI_rresp,
    M_AXI_rvalid,
    M_AXI_wdata,
    M_AXI_wready,
    M_AXI_wstrb,
    M_AXI_wvalid,
    S_ACLK,
    S_ARESETN,
    S_AXI_araddr,
    S_AXI_arready,
    S_AXI_arvalid,
    S_AXI_awaddr,
    S_AXI_awready,
    S_AXI_awvalid,
    S_AXI_bready,
    S_AXI_bresp,
    S_AXI_bvalid,
    S_AXI_rdata,
    S_AXI_rready,
    S_AXI_rresp,
    S_AXI_rvalid,
    S_AXI_wdata,
    S_AXI_wready,
    S_AXI_wstrb,
    S_AXI_wvalid);
  input M_ACLK;
  input M_ARESETN;
  output [31:0]M_AXI_araddr;
  input M_AXI_arready;
  output M_AXI_arvalid;
  output [31:0]M_AXI_awaddr;
  input M_AXI_awready;
  output M_AXI_awvalid;
  output M_AXI_bready;
  input [1:0]M_AXI_bresp;
  input M_AXI_bvalid;
  input [31:0]M_AXI_rdata;
  output M_AXI_rready;
  input [1:0]M_AXI_rresp;
  input M_AXI_rvalid;
  output [31:0]M_AXI_wdata;
  input M_AXI_wready;
  output [3:0]M_AXI_wstrb;
  output M_AXI_wvalid;
  input S_ACLK;
  input S_ARESETN;
  input [31:0]S_AXI_araddr;
  output S_AXI_arready;
  input S_AXI_arvalid;
  input [31:0]S_AXI_awaddr;
  output S_AXI_awready;
  input S_AXI_awvalid;
  input S_AXI_bready;
  output [1:0]S_AXI_bresp;
  output S_AXI_bvalid;
  output [31:0]S_AXI_rdata;
  input S_AXI_rready;
  output [1:0]S_AXI_rresp;
  output S_AXI_rvalid;
  input [31:0]S_AXI_wdata;
  output S_AXI_wready;
  input [3:0]S_AXI_wstrb;
  input S_AXI_wvalid;

  wire [31:0]m01_couplers_to_m01_couplers_ARADDR;
  wire m01_couplers_to_m01_couplers_ARREADY;
  wire m01_couplers_to_m01_couplers_ARVALID;
  wire [31:0]m01_couplers_to_m01_couplers_AWADDR;
  wire m01_couplers_to_m01_couplers_AWREADY;
  wire m01_couplers_to_m01_couplers_AWVALID;
  wire m01_couplers_to_m01_couplers_BREADY;
  wire [1:0]m01_couplers_to_m01_couplers_BRESP;
  wire m01_couplers_to_m01_couplers_BVALID;
  wire [31:0]m01_couplers_to_m01_couplers_RDATA;
  wire m01_couplers_to_m01_couplers_RREADY;
  wire [1:0]m01_couplers_to_m01_couplers_RRESP;
  wire m01_couplers_to_m01_couplers_RVALID;
  wire [31:0]m01_couplers_to_m01_couplers_WDATA;
  wire m01_couplers_to_m01_couplers_WREADY;
  wire [3:0]m01_couplers_to_m01_couplers_WSTRB;
  wire m01_couplers_to_m01_couplers_WVALID;

  assign M_AXI_araddr[31:0] = m01_couplers_to_m01_couplers_ARADDR;
  assign M_AXI_arvalid = m01_couplers_to_m01_couplers_ARVALID;
  assign M_AXI_awaddr[31:0] = m01_couplers_to_m01_couplers_AWADDR;
  assign M_AXI_awvalid = m01_couplers_to_m01_couplers_AWVALID;
  assign M_AXI_bready = m01_couplers_to_m01_couplers_BREADY;
  assign M_AXI_rready = m01_couplers_to_m01_couplers_RREADY;
  assign M_AXI_wdata[31:0] = m01_couplers_to_m01_couplers_WDATA;
  assign M_AXI_wstrb[3:0] = m01_couplers_to_m01_couplers_WSTRB;
  assign M_AXI_wvalid = m01_couplers_to_m01_couplers_WVALID;
  assign S_AXI_arready = m01_couplers_to_m01_couplers_ARREADY;
  assign S_AXI_awready = m01_couplers_to_m01_couplers_AWREADY;
  assign S_AXI_bresp[1:0] = m01_couplers_to_m01_couplers_BRESP;
  assign S_AXI_bvalid = m01_couplers_to_m01_couplers_BVALID;
  assign S_AXI_rdata[31:0] = m01_couplers_to_m01_couplers_RDATA;
  assign S_AXI_rresp[1:0] = m01_couplers_to_m01_couplers_RRESP;
  assign S_AXI_rvalid = m01_couplers_to_m01_couplers_RVALID;
  assign S_AXI_wready = m01_couplers_to_m01_couplers_WREADY;
  assign m01_couplers_to_m01_couplers_ARADDR = S_AXI_araddr[31:0];
  assign m01_couplers_to_m01_couplers_ARREADY = M_AXI_arready;
  assign m01_couplers_to_m01_couplers_ARVALID = S_AXI_arvalid;
  assign m01_couplers_to_m01_couplers_AWADDR = S_AXI_awaddr[31:0];
  assign m01_couplers_to_m01_couplers_AWREADY = M_AXI_awready;
  assign m01_couplers_to_m01_couplers_AWVALID = S_AXI_awvalid;
  assign m01_couplers_to_m01_couplers_BREADY = S_AXI_bready;
  assign m01_couplers_to_m01_couplers_BRESP = M_AXI_bresp[1:0];
  assign m01_couplers_to_m01_couplers_BVALID = M_AXI_bvalid;
  assign m01_couplers_to_m01_couplers_RDATA = M_AXI_rdata[31:0];
  assign m01_couplers_to_m01_couplers_RREADY = S_AXI_rready;
  assign m01_couplers_to_m01_couplers_RRESP = M_AXI_rresp[1:0];
  assign m01_couplers_to_m01_couplers_RVALID = M_AXI_rvalid;
  assign m01_couplers_to_m01_couplers_WDATA = S_AXI_wdata[31:0];
  assign m01_couplers_to_m01_couplers_WREADY = M_AXI_wready;
  assign m01_couplers_to_m01_couplers_WSTRB = S_AXI_wstrb[3:0];
  assign m01_couplers_to_m01_couplers_WVALID = S_AXI_wvalid;
endmodule

module m02_couplers_imp_1BOGR4T
   (M_ACLK,
    M_ARESETN,
    M_AXI_araddr,
    M_AXI_arready,
    M_AXI_arvalid,
    M_AXI_awaddr,
    M_AXI_awready,
    M_AXI_awvalid,
    M_AXI_bready,
    M_AXI_bresp,
    M_AXI_bvalid,
    M_AXI_rdata,
    M_AXI_rready,
    M_AXI_rresp,
    M_AXI_rvalid,
    M_AXI_wdata,
    M_AXI_wready,
    M_AXI_wstrb,
    M_AXI_wvalid,
    S_ACLK,
    S_ARESETN,
    S_AXI_araddr,
    S_AXI_arready,
    S_AXI_arvalid,
    S_AXI_awaddr,
    S_AXI_awready,
    S_AXI_awvalid,
    S_AXI_bready,
    S_AXI_bresp,
    S_AXI_bvalid,
    S_AXI_rdata,
    S_AXI_rready,
    S_AXI_rresp,
    S_AXI_rvalid,
    S_AXI_wdata,
    S_AXI_wready,
    S_AXI_wstrb,
    S_AXI_wvalid);
  input M_ACLK;
  input M_ARESETN;
  output [31:0]M_AXI_araddr;
  input M_AXI_arready;
  output M_AXI_arvalid;
  output [31:0]M_AXI_awaddr;
  input M_AXI_awready;
  output M_AXI_awvalid;
  output M_AXI_bready;
  input [1:0]M_AXI_bresp;
  input M_AXI_bvalid;
  input [31:0]M_AXI_rdata;
  output M_AXI_rready;
  input [1:0]M_AXI_rresp;
  input M_AXI_rvalid;
  output [31:0]M_AXI_wdata;
  input M_AXI_wready;
  output [3:0]M_AXI_wstrb;
  output M_AXI_wvalid;
  input S_ACLK;
  input S_ARESETN;
  input [31:0]S_AXI_araddr;
  output S_AXI_arready;
  input S_AXI_arvalid;
  input [31:0]S_AXI_awaddr;
  output S_AXI_awready;
  input S_AXI_awvalid;
  input S_AXI_bready;
  output [1:0]S_AXI_bresp;
  output S_AXI_bvalid;
  output [31:0]S_AXI_rdata;
  input S_AXI_rready;
  output [1:0]S_AXI_rresp;
  output S_AXI_rvalid;
  input [31:0]S_AXI_wdata;
  output S_AXI_wready;
  input [3:0]S_AXI_wstrb;
  input S_AXI_wvalid;

  wire [31:0]m02_couplers_to_m02_couplers_ARADDR;
  wire m02_couplers_to_m02_couplers_ARREADY;
  wire m02_couplers_to_m02_couplers_ARVALID;
  wire [31:0]m02_couplers_to_m02_couplers_AWADDR;
  wire m02_couplers_to_m02_couplers_AWREADY;
  wire m02_couplers_to_m02_couplers_AWVALID;
  wire m02_couplers_to_m02_couplers_BREADY;
  wire [1:0]m02_couplers_to_m02_couplers_BRESP;
  wire m02_couplers_to_m02_couplers_BVALID;
  wire [31:0]m02_couplers_to_m02_couplers_RDATA;
  wire m02_couplers_to_m02_couplers_RREADY;
  wire [1:0]m02_couplers_to_m02_couplers_RRESP;
  wire m02_couplers_to_m02_couplers_RVALID;
  wire [31:0]m02_couplers_to_m02_couplers_WDATA;
  wire m02_couplers_to_m02_couplers_WREADY;
  wire [3:0]m02_couplers_to_m02_couplers_WSTRB;
  wire m02_couplers_to_m02_couplers_WVALID;

  assign M_AXI_araddr[31:0] = m02_couplers_to_m02_couplers_ARADDR;
  assign M_AXI_arvalid = m02_couplers_to_m02_couplers_ARVALID;
  assign M_AXI_awaddr[31:0] = m02_couplers_to_m02_couplers_AWADDR;
  assign M_AXI_awvalid = m02_couplers_to_m02_couplers_AWVALID;
  assign M_AXI_bready = m02_couplers_to_m02_couplers_BREADY;
  assign M_AXI_rready = m02_couplers_to_m02_couplers_RREADY;
  assign M_AXI_wdata[31:0] = m02_couplers_to_m02_couplers_WDATA;
  assign M_AXI_wstrb[3:0] = m02_couplers_to_m02_couplers_WSTRB;
  assign M_AXI_wvalid = m02_couplers_to_m02_couplers_WVALID;
  assign S_AXI_arready = m02_couplers_to_m02_couplers_ARREADY;
  assign S_AXI_awready = m02_couplers_to_m02_couplers_AWREADY;
  assign S_AXI_bresp[1:0] = m02_couplers_to_m02_couplers_BRESP;
  assign S_AXI_bvalid = m02_couplers_to_m02_couplers_BVALID;
  assign S_AXI_rdata[31:0] = m02_couplers_to_m02_couplers_RDATA;
  assign S_AXI_rresp[1:0] = m02_couplers_to_m02_couplers_RRESP;
  assign S_AXI_rvalid = m02_couplers_to_m02_couplers_RVALID;
  assign S_AXI_wready = m02_couplers_to_m02_couplers_WREADY;
  assign m02_couplers_to_m02_couplers_ARADDR = S_AXI_araddr[31:0];
  assign m02_couplers_to_m02_couplers_ARREADY = M_AXI_arready;
  assign m02_couplers_to_m02_couplers_ARVALID = S_AXI_arvalid;
  assign m02_couplers_to_m02_couplers_AWADDR = S_AXI_awaddr[31:0];
  assign m02_couplers_to_m02_couplers_AWREADY = M_AXI_awready;
  assign m02_couplers_to_m02_couplers_AWVALID = S_AXI_awvalid;
  assign m02_couplers_to_m02_couplers_BREADY = S_AXI_bready;
  assign m02_couplers_to_m02_couplers_BRESP = M_AXI_bresp[1:0];
  assign m02_couplers_to_m02_couplers_BVALID = M_AXI_bvalid;
  assign m02_couplers_to_m02_couplers_RDATA = M_AXI_rdata[31:0];
  assign m02_couplers_to_m02_couplers_RREADY = S_AXI_rready;
  assign m02_couplers_to_m02_couplers_RRESP = M_AXI_rresp[1:0];
  assign m02_couplers_to_m02_couplers_RVALID = M_AXI_rvalid;
  assign m02_couplers_to_m02_couplers_WDATA = S_AXI_wdata[31:0];
  assign m02_couplers_to_m02_couplers_WREADY = M_AXI_wready;
  assign m02_couplers_to_m02_couplers_WSTRB = S_AXI_wstrb[3:0];
  assign m02_couplers_to_m02_couplers_WVALID = S_AXI_wvalid;
endmodule

module m03_couplers_imp_J0G1J0
   (M_ACLK,
    M_ARESETN,
    M_AXI_araddr,
    M_AXI_arready,
    M_AXI_arvalid,
    M_AXI_awaddr,
    M_AXI_awready,
    M_AXI_awvalid,
    M_AXI_bready,
    M_AXI_bresp,
    M_AXI_bvalid,
    M_AXI_rdata,
    M_AXI_rready,
    M_AXI_rresp,
    M_AXI_rvalid,
    M_AXI_wdata,
    M_AXI_wready,
    M_AXI_wstrb,
    M_AXI_wvalid,
    S_ACLK,
    S_ARESETN,
    S_AXI_araddr,
    S_AXI_arready,
    S_AXI_arvalid,
    S_AXI_awaddr,
    S_AXI_awready,
    S_AXI_awvalid,
    S_AXI_bready,
    S_AXI_bresp,
    S_AXI_bvalid,
    S_AXI_rdata,
    S_AXI_rready,
    S_AXI_rresp,
    S_AXI_rvalid,
    S_AXI_wdata,
    S_AXI_wready,
    S_AXI_wstrb,
    S_AXI_wvalid);
  input M_ACLK;
  input M_ARESETN;
  output [31:0]M_AXI_araddr;
  input M_AXI_arready;
  output M_AXI_arvalid;
  output [31:0]M_AXI_awaddr;
  input M_AXI_awready;
  output M_AXI_awvalid;
  output M_AXI_bready;
  input [1:0]M_AXI_bresp;
  input M_AXI_bvalid;
  input [31:0]M_AXI_rdata;
  output M_AXI_rready;
  input [1:0]M_AXI_rresp;
  input M_AXI_rvalid;
  output [31:0]M_AXI_wdata;
  input M_AXI_wready;
  output [3:0]M_AXI_wstrb;
  output M_AXI_wvalid;
  input S_ACLK;
  input S_ARESETN;
  input [31:0]S_AXI_araddr;
  output S_AXI_arready;
  input S_AXI_arvalid;
  input [31:0]S_AXI_awaddr;
  output S_AXI_awready;
  input S_AXI_awvalid;
  input S_AXI_bready;
  output [1:0]S_AXI_bresp;
  output S_AXI_bvalid;
  output [31:0]S_AXI_rdata;
  input S_AXI_rready;
  output [1:0]S_AXI_rresp;
  output S_AXI_rvalid;
  input [31:0]S_AXI_wdata;
  output S_AXI_wready;
  input [3:0]S_AXI_wstrb;
  input S_AXI_wvalid;

  wire [31:0]m03_couplers_to_m03_couplers_ARADDR;
  wire m03_couplers_to_m03_couplers_ARREADY;
  wire m03_couplers_to_m03_couplers_ARVALID;
  wire [31:0]m03_couplers_to_m03_couplers_AWADDR;
  wire m03_couplers_to_m03_couplers_AWREADY;
  wire m03_couplers_to_m03_couplers_AWVALID;
  wire m03_couplers_to_m03_couplers_BREADY;
  wire [1:0]m03_couplers_to_m03_couplers_BRESP;
  wire m03_couplers_to_m03_couplers_BVALID;
  wire [31:0]m03_couplers_to_m03_couplers_RDATA;
  wire m03_couplers_to_m03_couplers_RREADY;
  wire [1:0]m03_couplers_to_m03_couplers_RRESP;
  wire m03_couplers_to_m03_couplers_RVALID;
  wire [31:0]m03_couplers_to_m03_couplers_WDATA;
  wire m03_couplers_to_m03_couplers_WREADY;
  wire [3:0]m03_couplers_to_m03_couplers_WSTRB;
  wire m03_couplers_to_m03_couplers_WVALID;

  assign M_AXI_araddr[31:0] = m03_couplers_to_m03_couplers_ARADDR;
  assign M_AXI_arvalid = m03_couplers_to_m03_couplers_ARVALID;
  assign M_AXI_awaddr[31:0] = m03_couplers_to_m03_couplers_AWADDR;
  assign M_AXI_awvalid = m03_couplers_to_m03_couplers_AWVALID;
  assign M_AXI_bready = m03_couplers_to_m03_couplers_BREADY;
  assign M_AXI_rready = m03_couplers_to_m03_couplers_RREADY;
  assign M_AXI_wdata[31:0] = m03_couplers_to_m03_couplers_WDATA;
  assign M_AXI_wstrb[3:0] = m03_couplers_to_m03_couplers_WSTRB;
  assign M_AXI_wvalid = m03_couplers_to_m03_couplers_WVALID;
  assign S_AXI_arready = m03_couplers_to_m03_couplers_ARREADY;
  assign S_AXI_awready = m03_couplers_to_m03_couplers_AWREADY;
  assign S_AXI_bresp[1:0] = m03_couplers_to_m03_couplers_BRESP;
  assign S_AXI_bvalid = m03_couplers_to_m03_couplers_BVALID;
  assign S_AXI_rdata[31:0] = m03_couplers_to_m03_couplers_RDATA;
  assign S_AXI_rresp[1:0] = m03_couplers_to_m03_couplers_RRESP;
  assign S_AXI_rvalid = m03_couplers_to_m03_couplers_RVALID;
  assign S_AXI_wready = m03_couplers_to_m03_couplers_WREADY;
  assign m03_couplers_to_m03_couplers_ARADDR = S_AXI_araddr[31:0];
  assign m03_couplers_to_m03_couplers_ARREADY = M_AXI_arready;
  assign m03_couplers_to_m03_couplers_ARVALID = S_AXI_arvalid;
  assign m03_couplers_to_m03_couplers_AWADDR = S_AXI_awaddr[31:0];
  assign m03_couplers_to_m03_couplers_AWREADY = M_AXI_awready;
  assign m03_couplers_to_m03_couplers_AWVALID = S_AXI_awvalid;
  assign m03_couplers_to_m03_couplers_BREADY = S_AXI_bready;
  assign m03_couplers_to_m03_couplers_BRESP = M_AXI_bresp[1:0];
  assign m03_couplers_to_m03_couplers_BVALID = M_AXI_bvalid;
  assign m03_couplers_to_m03_couplers_RDATA = M_AXI_rdata[31:0];
  assign m03_couplers_to_m03_couplers_RREADY = S_AXI_rready;
  assign m03_couplers_to_m03_couplers_RRESP = M_AXI_rresp[1:0];
  assign m03_couplers_to_m03_couplers_RVALID = M_AXI_rvalid;
  assign m03_couplers_to_m03_couplers_WDATA = S_AXI_wdata[31:0];
  assign m03_couplers_to_m03_couplers_WREADY = M_AXI_wready;
  assign m03_couplers_to_m03_couplers_WSTRB = S_AXI_wstrb[3:0];
  assign m03_couplers_to_m03_couplers_WVALID = S_AXI_wvalid;
endmodule

module microblaze_0_local_memory_imp_1K0VQXK
   (Clk,
    DLMB_abus,
    DLMB_addrstrobe,
    DLMB_be,
    DLMB_ce,
    DLMB_readdbus,
    DLMB_readstrobe,
    DLMB_ready,
    DLMB_ue,
    DLMB_wait,
    DLMB_writedbus,
    DLMB_writestrobe,
    ILMB_abus,
    ILMB_addrstrobe,
    ILMB_ce,
    ILMB_readdbus,
    ILMB_readstrobe,
    ILMB_ready,
    ILMB_ue,
    ILMB_wait,
    SYS_Rst);
  input Clk;
  input [0:31]DLMB_abus;
  input DLMB_addrstrobe;
  input [0:3]DLMB_be;
  output DLMB_ce;
  output [0:31]DLMB_readdbus;
  input DLMB_readstrobe;
  output DLMB_ready;
  output DLMB_ue;
  output DLMB_wait;
  input [0:31]DLMB_writedbus;
  input DLMB_writestrobe;
  input [0:31]ILMB_abus;
  input ILMB_addrstrobe;
  output ILMB_ce;
  output [0:31]ILMB_readdbus;
  input ILMB_readstrobe;
  output ILMB_ready;
  output ILMB_ue;
  output ILMB_wait;
  input SYS_Rst;

  wire SYS_Rst_1;
  wire microblaze_0_Clk;
  wire [0:31]microblaze_0_dlmb_ABUS;
  wire microblaze_0_dlmb_ADDRSTROBE;
  wire [0:3]microblaze_0_dlmb_BE;
  wire microblaze_0_dlmb_CE;
  wire [0:31]microblaze_0_dlmb_READDBUS;
  wire microblaze_0_dlmb_READSTROBE;
  wire microblaze_0_dlmb_READY;
  wire microblaze_0_dlmb_UE;
  wire microblaze_0_dlmb_WAIT;
  wire [0:31]microblaze_0_dlmb_WRITEDBUS;
  wire microblaze_0_dlmb_WRITESTROBE;
  wire [0:31]microblaze_0_dlmb_bus_ABUS;
  wire microblaze_0_dlmb_bus_ADDRSTROBE;
  wire [0:3]microblaze_0_dlmb_bus_BE;
  wire microblaze_0_dlmb_bus_CE;
  wire [0:31]microblaze_0_dlmb_bus_READDBUS;
  wire microblaze_0_dlmb_bus_READSTROBE;
  wire microblaze_0_dlmb_bus_READY;
  wire microblaze_0_dlmb_bus_UE;
  wire microblaze_0_dlmb_bus_WAIT;
  wire [0:31]microblaze_0_dlmb_bus_WRITEDBUS;
  wire microblaze_0_dlmb_bus_WRITESTROBE;
  wire [0:31]microblaze_0_dlmb_cntlr_ADDR;
  wire microblaze_0_dlmb_cntlr_CLK;
  wire [0:31]microblaze_0_dlmb_cntlr_DIN;
  wire [31:0]microblaze_0_dlmb_cntlr_DOUT;
  wire microblaze_0_dlmb_cntlr_EN;
  wire microblaze_0_dlmb_cntlr_RST;
  wire [0:3]microblaze_0_dlmb_cntlr_WE;
  wire [0:31]microblaze_0_ilmb_ABUS;
  wire microblaze_0_ilmb_ADDRSTROBE;
  wire microblaze_0_ilmb_CE;
  wire [0:31]microblaze_0_ilmb_READDBUS;
  wire microblaze_0_ilmb_READSTROBE;
  wire microblaze_0_ilmb_READY;
  wire microblaze_0_ilmb_UE;
  wire microblaze_0_ilmb_WAIT;
  wire [0:31]microblaze_0_ilmb_bus_ABUS;
  wire microblaze_0_ilmb_bus_ADDRSTROBE;
  wire [0:3]microblaze_0_ilmb_bus_BE;
  wire microblaze_0_ilmb_bus_CE;
  wire [0:31]microblaze_0_ilmb_bus_READDBUS;
  wire microblaze_0_ilmb_bus_READSTROBE;
  wire microblaze_0_ilmb_bus_READY;
  wire microblaze_0_ilmb_bus_UE;
  wire microblaze_0_ilmb_bus_WAIT;
  wire [0:31]microblaze_0_ilmb_bus_WRITEDBUS;
  wire microblaze_0_ilmb_bus_WRITESTROBE;
  wire [0:31]microblaze_0_ilmb_cntlr_ADDR;
  wire microblaze_0_ilmb_cntlr_CLK;
  wire [0:31]microblaze_0_ilmb_cntlr_DIN;
  wire [31:0]microblaze_0_ilmb_cntlr_DOUT;
  wire microblaze_0_ilmb_cntlr_EN;
  wire microblaze_0_ilmb_cntlr_RST;
  wire [0:3]microblaze_0_ilmb_cntlr_WE;

  assign DLMB_ce = microblaze_0_dlmb_CE;
  assign DLMB_readdbus[0:31] = microblaze_0_dlmb_READDBUS;
  assign DLMB_ready = microblaze_0_dlmb_READY;
  assign DLMB_ue = microblaze_0_dlmb_UE;
  assign DLMB_wait = microblaze_0_dlmb_WAIT;
  assign ILMB_ce = microblaze_0_ilmb_CE;
  assign ILMB_readdbus[0:31] = microblaze_0_ilmb_READDBUS;
  assign ILMB_ready = microblaze_0_ilmb_READY;
  assign ILMB_ue = microblaze_0_ilmb_UE;
  assign ILMB_wait = microblaze_0_ilmb_WAIT;
  assign SYS_Rst_1 = SYS_Rst;
  assign microblaze_0_Clk = Clk;
  assign microblaze_0_dlmb_ABUS = DLMB_abus[0:31];
  assign microblaze_0_dlmb_ADDRSTROBE = DLMB_addrstrobe;
  assign microblaze_0_dlmb_BE = DLMB_be[0:3];
  assign microblaze_0_dlmb_READSTROBE = DLMB_readstrobe;
  assign microblaze_0_dlmb_WRITEDBUS = DLMB_writedbus[0:31];
  assign microblaze_0_dlmb_WRITESTROBE = DLMB_writestrobe;
  assign microblaze_0_ilmb_ABUS = ILMB_abus[0:31];
  assign microblaze_0_ilmb_ADDRSTROBE = ILMB_addrstrobe;
  assign microblaze_0_ilmb_READSTROBE = ILMB_readstrobe;
  (* BMM_INFO_ADDRESS_SPACE = "byte  0x00000000 32 > design_1 microblaze_0_local_memory/lmb_bram" *) 
  (* KEEP_HIERARCHY = "yes" *) 
  design_1_dlmb_bram_if_cntlr_1 dlmb_bram_if_cntlr
       (.BRAM_Addr_A(microblaze_0_dlmb_cntlr_ADDR),
        .BRAM_Clk_A(microblaze_0_dlmb_cntlr_CLK),
        .BRAM_Din_A({microblaze_0_dlmb_cntlr_DOUT[31],microblaze_0_dlmb_cntlr_DOUT[30],microblaze_0_dlmb_cntlr_DOUT[29],microblaze_0_dlmb_cntlr_DOUT[28],microblaze_0_dlmb_cntlr_DOUT[27],microblaze_0_dlmb_cntlr_DOUT[26],microblaze_0_dlmb_cntlr_DOUT[25],microblaze_0_dlmb_cntlr_DOUT[24],microblaze_0_dlmb_cntlr_DOUT[23],microblaze_0_dlmb_cntlr_DOUT[22],microblaze_0_dlmb_cntlr_DOUT[21],microblaze_0_dlmb_cntlr_DOUT[20],microblaze_0_dlmb_cntlr_DOUT[19],microblaze_0_dlmb_cntlr_DOUT[18],microblaze_0_dlmb_cntlr_DOUT[17],microblaze_0_dlmb_cntlr_DOUT[16],microblaze_0_dlmb_cntlr_DOUT[15],microblaze_0_dlmb_cntlr_DOUT[14],microblaze_0_dlmb_cntlr_DOUT[13],microblaze_0_dlmb_cntlr_DOUT[12],microblaze_0_dlmb_cntlr_DOUT[11],microblaze_0_dlmb_cntlr_DOUT[10],microblaze_0_dlmb_cntlr_DOUT[9],microblaze_0_dlmb_cntlr_DOUT[8],microblaze_0_dlmb_cntlr_DOUT[7],microblaze_0_dlmb_cntlr_DOUT[6],microblaze_0_dlmb_cntlr_DOUT[5],microblaze_0_dlmb_cntlr_DOUT[4],microblaze_0_dlmb_cntlr_DOUT[3],microblaze_0_dlmb_cntlr_DOUT[2],microblaze_0_dlmb_cntlr_DOUT[1],microblaze_0_dlmb_cntlr_DOUT[0]}),
        .BRAM_Dout_A(microblaze_0_dlmb_cntlr_DIN),
        .BRAM_EN_A(microblaze_0_dlmb_cntlr_EN),
        .BRAM_Rst_A(microblaze_0_dlmb_cntlr_RST),
        .BRAM_WEN_A(microblaze_0_dlmb_cntlr_WE),
        .LMB_ABus(microblaze_0_dlmb_bus_ABUS),
        .LMB_AddrStrobe(microblaze_0_dlmb_bus_ADDRSTROBE),
        .LMB_BE(microblaze_0_dlmb_bus_BE),
        .LMB_Clk(microblaze_0_Clk),
        .LMB_ReadStrobe(microblaze_0_dlmb_bus_READSTROBE),
        .LMB_Rst(SYS_Rst_1),
        .LMB_WriteDBus(microblaze_0_dlmb_bus_WRITEDBUS),
        .LMB_WriteStrobe(microblaze_0_dlmb_bus_WRITESTROBE),
        .Sl_CE(microblaze_0_dlmb_bus_CE),
        .Sl_DBus(microblaze_0_dlmb_bus_READDBUS),
        .Sl_Ready(microblaze_0_dlmb_bus_READY),
        .Sl_UE(microblaze_0_dlmb_bus_UE),
        .Sl_Wait(microblaze_0_dlmb_bus_WAIT));
  design_1_dlmb_v10_1 dlmb_v10
       (.LMB_ABus(microblaze_0_dlmb_bus_ABUS),
        .LMB_AddrStrobe(microblaze_0_dlmb_bus_ADDRSTROBE),
        .LMB_BE(microblaze_0_dlmb_bus_BE),
        .LMB_CE(microblaze_0_dlmb_CE),
        .LMB_Clk(microblaze_0_Clk),
        .LMB_ReadDBus(microblaze_0_dlmb_READDBUS),
        .LMB_ReadStrobe(microblaze_0_dlmb_bus_READSTROBE),
        .LMB_Ready(microblaze_0_dlmb_READY),
        .LMB_UE(microblaze_0_dlmb_UE),
        .LMB_Wait(microblaze_0_dlmb_WAIT),
        .LMB_WriteDBus(microblaze_0_dlmb_bus_WRITEDBUS),
        .LMB_WriteStrobe(microblaze_0_dlmb_bus_WRITESTROBE),
        .M_ABus(microblaze_0_dlmb_ABUS),
        .M_AddrStrobe(microblaze_0_dlmb_ADDRSTROBE),
        .M_BE(microblaze_0_dlmb_BE),
        .M_DBus(microblaze_0_dlmb_WRITEDBUS),
        .M_ReadStrobe(microblaze_0_dlmb_READSTROBE),
        .M_WriteStrobe(microblaze_0_dlmb_WRITESTROBE),
        .SYS_Rst(SYS_Rst_1),
        .Sl_CE(microblaze_0_dlmb_bus_CE),
        .Sl_DBus(microblaze_0_dlmb_bus_READDBUS),
        .Sl_Ready(microblaze_0_dlmb_bus_READY),
        .Sl_UE(microblaze_0_dlmb_bus_UE),
        .Sl_Wait(microblaze_0_dlmb_bus_WAIT));
  design_1_ilmb_bram_if_cntlr_1 ilmb_bram_if_cntlr
       (.BRAM_Addr_A(microblaze_0_ilmb_cntlr_ADDR),
        .BRAM_Clk_A(microblaze_0_ilmb_cntlr_CLK),
        .BRAM_Din_A({microblaze_0_ilmb_cntlr_DOUT[31],microblaze_0_ilmb_cntlr_DOUT[30],microblaze_0_ilmb_cntlr_DOUT[29],microblaze_0_ilmb_cntlr_DOUT[28],microblaze_0_ilmb_cntlr_DOUT[27],microblaze_0_ilmb_cntlr_DOUT[26],microblaze_0_ilmb_cntlr_DOUT[25],microblaze_0_ilmb_cntlr_DOUT[24],microblaze_0_ilmb_cntlr_DOUT[23],microblaze_0_ilmb_cntlr_DOUT[22],microblaze_0_ilmb_cntlr_DOUT[21],microblaze_0_ilmb_cntlr_DOUT[20],microblaze_0_ilmb_cntlr_DOUT[19],microblaze_0_ilmb_cntlr_DOUT[18],microblaze_0_ilmb_cntlr_DOUT[17],microblaze_0_ilmb_cntlr_DOUT[16],microblaze_0_ilmb_cntlr_DOUT[15],microblaze_0_ilmb_cntlr_DOUT[14],microblaze_0_ilmb_cntlr_DOUT[13],microblaze_0_ilmb_cntlr_DOUT[12],microblaze_0_ilmb_cntlr_DOUT[11],microblaze_0_ilmb_cntlr_DOUT[10],microblaze_0_ilmb_cntlr_DOUT[9],microblaze_0_ilmb_cntlr_DOUT[8],microblaze_0_ilmb_cntlr_DOUT[7],microblaze_0_ilmb_cntlr_DOUT[6],microblaze_0_ilmb_cntlr_DOUT[5],microblaze_0_ilmb_cntlr_DOUT[4],microblaze_0_ilmb_cntlr_DOUT[3],microblaze_0_ilmb_cntlr_DOUT[2],microblaze_0_ilmb_cntlr_DOUT[1],microblaze_0_ilmb_cntlr_DOUT[0]}),
        .BRAM_Dout_A(microblaze_0_ilmb_cntlr_DIN),
        .BRAM_EN_A(microblaze_0_ilmb_cntlr_EN),
        .BRAM_Rst_A(microblaze_0_ilmb_cntlr_RST),
        .BRAM_WEN_A(microblaze_0_ilmb_cntlr_WE),
        .LMB_ABus(microblaze_0_ilmb_bus_ABUS),
        .LMB_AddrStrobe(microblaze_0_ilmb_bus_ADDRSTROBE),
        .LMB_BE(microblaze_0_ilmb_bus_BE),
        .LMB_Clk(microblaze_0_Clk),
        .LMB_ReadStrobe(microblaze_0_ilmb_bus_READSTROBE),
        .LMB_Rst(SYS_Rst_1),
        .LMB_WriteDBus(microblaze_0_ilmb_bus_WRITEDBUS),
        .LMB_WriteStrobe(microblaze_0_ilmb_bus_WRITESTROBE),
        .Sl_CE(microblaze_0_ilmb_bus_CE),
        .Sl_DBus(microblaze_0_ilmb_bus_READDBUS),
        .Sl_Ready(microblaze_0_ilmb_bus_READY),
        .Sl_UE(microblaze_0_ilmb_bus_UE),
        .Sl_Wait(microblaze_0_ilmb_bus_WAIT));
  design_1_ilmb_v10_1 ilmb_v10
       (.LMB_ABus(microblaze_0_ilmb_bus_ABUS),
        .LMB_AddrStrobe(microblaze_0_ilmb_bus_ADDRSTROBE),
        .LMB_BE(microblaze_0_ilmb_bus_BE),
        .LMB_CE(microblaze_0_ilmb_CE),
        .LMB_Clk(microblaze_0_Clk),
        .LMB_ReadDBus(microblaze_0_ilmb_READDBUS),
        .LMB_ReadStrobe(microblaze_0_ilmb_bus_READSTROBE),
        .LMB_Ready(microblaze_0_ilmb_READY),
        .LMB_UE(microblaze_0_ilmb_UE),
        .LMB_Wait(microblaze_0_ilmb_WAIT),
        .LMB_WriteDBus(microblaze_0_ilmb_bus_WRITEDBUS),
        .LMB_WriteStrobe(microblaze_0_ilmb_bus_WRITESTROBE),
        .M_ABus(microblaze_0_ilmb_ABUS),
        .M_AddrStrobe(microblaze_0_ilmb_ADDRSTROBE),
        .M_BE({1'b0,1'b0,1'b0,1'b0}),
        .M_DBus({1'b0,1'b0,1'b0,1'b0,1'b0,1'b0,1'b0,1'b0,1'b0,1'b0,1'b0,1'b0,1'b0,1'b0,1'b0,1'b0,1'b0,1'b0,1'b0,1'b0,1'b0,1'b0,1'b0,1'b0,1'b0,1'b0,1'b0,1'b0,1'b0,1'b0,1'b0,1'b0}),
        .M_ReadStrobe(microblaze_0_ilmb_READSTROBE),
        .M_WriteStrobe(1'b0),
        .SYS_Rst(SYS_Rst_1),
        .Sl_CE(microblaze_0_ilmb_bus_CE),
        .Sl_DBus(microblaze_0_ilmb_bus_READDBUS),
        .Sl_Ready(microblaze_0_ilmb_bus_READY),
        .Sl_UE(microblaze_0_ilmb_bus_UE),
        .Sl_Wait(microblaze_0_ilmb_bus_WAIT));
  design_1_lmb_bram_1 lmb_bram
       (.addra({microblaze_0_dlmb_cntlr_ADDR[0],microblaze_0_dlmb_cntlr_ADDR[1],microblaze_0_dlmb_cntlr_ADDR[2],microblaze_0_dlmb_cntlr_ADDR[3],microblaze_0_dlmb_cntlr_ADDR[4],microblaze_0_dlmb_cntlr_ADDR[5],microblaze_0_dlmb_cntlr_ADDR[6],microblaze_0_dlmb_cntlr_ADDR[7],microblaze_0_dlmb_cntlr_ADDR[8],microblaze_0_dlmb_cntlr_ADDR[9],microblaze_0_dlmb_cntlr_ADDR[10],microblaze_0_dlmb_cntlr_ADDR[11],microblaze_0_dlmb_cntlr_ADDR[12],microblaze_0_dlmb_cntlr_ADDR[13],microblaze_0_dlmb_cntlr_ADDR[14],microblaze_0_dlmb_cntlr_ADDR[15],microblaze_0_dlmb_cntlr_ADDR[16],microblaze_0_dlmb_cntlr_ADDR[17],microblaze_0_dlmb_cntlr_ADDR[18],microblaze_0_dlmb_cntlr_ADDR[19],microblaze_0_dlmb_cntlr_ADDR[20],microblaze_0_dlmb_cntlr_ADDR[21],microblaze_0_dlmb_cntlr_ADDR[22],microblaze_0_dlmb_cntlr_ADDR[23],microblaze_0_dlmb_cntlr_ADDR[24],microblaze_0_dlmb_cntlr_ADDR[25],microblaze_0_dlmb_cntlr_ADDR[26],microblaze_0_dlmb_cntlr_ADDR[27],microblaze_0_dlmb_cntlr_ADDR[28],microblaze_0_dlmb_cntlr_ADDR[29],microblaze_0_dlmb_cntlr_ADDR[30],microblaze_0_dlmb_cntlr_ADDR[31]}),
        .addrb({microblaze_0_ilmb_cntlr_ADDR[0],microblaze_0_ilmb_cntlr_ADDR[1],microblaze_0_ilmb_cntlr_ADDR[2],microblaze_0_ilmb_cntlr_ADDR[3],microblaze_0_ilmb_cntlr_ADDR[4],microblaze_0_ilmb_cntlr_ADDR[5],microblaze_0_ilmb_cntlr_ADDR[6],microblaze_0_ilmb_cntlr_ADDR[7],microblaze_0_ilmb_cntlr_ADDR[8],microblaze_0_ilmb_cntlr_ADDR[9],microblaze_0_ilmb_cntlr_ADDR[10],microblaze_0_ilmb_cntlr_ADDR[11],microblaze_0_ilmb_cntlr_ADDR[12],microblaze_0_ilmb_cntlr_ADDR[13],microblaze_0_ilmb_cntlr_ADDR[14],microblaze_0_ilmb_cntlr_ADDR[15],microblaze_0_ilmb_cntlr_ADDR[16],microblaze_0_ilmb_cntlr_ADDR[17],microblaze_0_ilmb_cntlr_ADDR[18],microblaze_0_ilmb_cntlr_ADDR[19],microblaze_0_ilmb_cntlr_ADDR[20],microblaze_0_ilmb_cntlr_ADDR[21],microblaze_0_ilmb_cntlr_ADDR[22],microblaze_0_ilmb_cntlr_ADDR[23],microblaze_0_ilmb_cntlr_ADDR[24],microblaze_0_ilmb_cntlr_ADDR[25],microblaze_0_ilmb_cntlr_ADDR[26],microblaze_0_ilmb_cntlr_ADDR[27],microblaze_0_ilmb_cntlr_ADDR[28],microblaze_0_ilmb_cntlr_ADDR[29],microblaze_0_ilmb_cntlr_ADDR[30],microblaze_0_ilmb_cntlr_ADDR[31]}),
        .clka(microblaze_0_dlmb_cntlr_CLK),
        .clkb(microblaze_0_ilmb_cntlr_CLK),
        .dina({microblaze_0_dlmb_cntlr_DIN[0],microblaze_0_dlmb_cntlr_DIN[1],microblaze_0_dlmb_cntlr_DIN[2],microblaze_0_dlmb_cntlr_DIN[3],microblaze_0_dlmb_cntlr_DIN[4],microblaze_0_dlmb_cntlr_DIN[5],microblaze_0_dlmb_cntlr_DIN[6],microblaze_0_dlmb_cntlr_DIN[7],microblaze_0_dlmb_cntlr_DIN[8],microblaze_0_dlmb_cntlr_DIN[9],microblaze_0_dlmb_cntlr_DIN[10],microblaze_0_dlmb_cntlr_DIN[11],microblaze_0_dlmb_cntlr_DIN[12],microblaze_0_dlmb_cntlr_DIN[13],microblaze_0_dlmb_cntlr_DIN[14],microblaze_0_dlmb_cntlr_DIN[15],microblaze_0_dlmb_cntlr_DIN[16],microblaze_0_dlmb_cntlr_DIN[17],microblaze_0_dlmb_cntlr_DIN[18],microblaze_0_dlmb_cntlr_DIN[19],microblaze_0_dlmb_cntlr_DIN[20],microblaze_0_dlmb_cntlr_DIN[21],microblaze_0_dlmb_cntlr_DIN[22],microblaze_0_dlmb_cntlr_DIN[23],microblaze_0_dlmb_cntlr_DIN[24],microblaze_0_dlmb_cntlr_DIN[25],microblaze_0_dlmb_cntlr_DIN[26],microblaze_0_dlmb_cntlr_DIN[27],microblaze_0_dlmb_cntlr_DIN[28],microblaze_0_dlmb_cntlr_DIN[29],microblaze_0_dlmb_cntlr_DIN[30],microblaze_0_dlmb_cntlr_DIN[31]}),
        .dinb({microblaze_0_ilmb_cntlr_DIN[0],microblaze_0_ilmb_cntlr_DIN[1],microblaze_0_ilmb_cntlr_DIN[2],microblaze_0_ilmb_cntlr_DIN[3],microblaze_0_ilmb_cntlr_DIN[4],microblaze_0_ilmb_cntlr_DIN[5],microblaze_0_ilmb_cntlr_DIN[6],microblaze_0_ilmb_cntlr_DIN[7],microblaze_0_ilmb_cntlr_DIN[8],microblaze_0_ilmb_cntlr_DIN[9],microblaze_0_ilmb_cntlr_DIN[10],microblaze_0_ilmb_cntlr_DIN[11],microblaze_0_ilmb_cntlr_DIN[12],microblaze_0_ilmb_cntlr_DIN[13],microblaze_0_ilmb_cntlr_DIN[14],microblaze_0_ilmb_cntlr_DIN[15],microblaze_0_ilmb_cntlr_DIN[16],microblaze_0_ilmb_cntlr_DIN[17],microblaze_0_ilmb_cntlr_DIN[18],microblaze_0_ilmb_cntlr_DIN[19],microblaze_0_ilmb_cntlr_DIN[20],microblaze_0_ilmb_cntlr_DIN[21],microblaze_0_ilmb_cntlr_DIN[22],microblaze_0_ilmb_cntlr_DIN[23],microblaze_0_ilmb_cntlr_DIN[24],microblaze_0_ilmb_cntlr_DIN[25],microblaze_0_ilmb_cntlr_DIN[26],microblaze_0_ilmb_cntlr_DIN[27],microblaze_0_ilmb_cntlr_DIN[28],microblaze_0_ilmb_cntlr_DIN[29],microblaze_0_ilmb_cntlr_DIN[30],microblaze_0_ilmb_cntlr_DIN[31]}),
        .douta(microblaze_0_dlmb_cntlr_DOUT),
        .doutb(microblaze_0_ilmb_cntlr_DOUT),
        .ena(microblaze_0_dlmb_cntlr_EN),
        .enb(microblaze_0_ilmb_cntlr_EN),
        .rsta(microblaze_0_dlmb_cntlr_RST),
        .rstb(microblaze_0_ilmb_cntlr_RST),
        .wea({microblaze_0_dlmb_cntlr_WE[0],microblaze_0_dlmb_cntlr_WE[1],microblaze_0_dlmb_cntlr_WE[2],microblaze_0_dlmb_cntlr_WE[3]}),
        .web({microblaze_0_ilmb_cntlr_WE[0],microblaze_0_ilmb_cntlr_WE[1],microblaze_0_ilmb_cntlr_WE[2],microblaze_0_ilmb_cntlr_WE[3]}));
endmodule

module s00_couplers_imp_O7FAN0
   (M_ACLK,
    M_ARESETN,
    M_AXI_araddr,
    M_AXI_arprot,
    M_AXI_arready,
    M_AXI_arvalid,
    M_AXI_awaddr,
    M_AXI_awprot,
    M_AXI_awready,
    M_AXI_awvalid,
    M_AXI_bready,
    M_AXI_bresp,
    M_AXI_bvalid,
    M_AXI_rdata,
    M_AXI_rready,
    M_AXI_rresp,
    M_AXI_rvalid,
    M_AXI_wdata,
    M_AXI_wready,
    M_AXI_wstrb,
    M_AXI_wvalid,
    S_ACLK,
    S_ARESETN,
    S_AXI_araddr,
    S_AXI_arprot,
    S_AXI_arready,
    S_AXI_arvalid,
    S_AXI_awaddr,
    S_AXI_awprot,
    S_AXI_awready,
    S_AXI_awvalid,
    S_AXI_bready,
    S_AXI_bresp,
    S_AXI_bvalid,
    S_AXI_rdata,
    S_AXI_rready,
    S_AXI_rresp,
    S_AXI_rvalid,
    S_AXI_wdata,
    S_AXI_wready,
    S_AXI_wstrb,
    S_AXI_wvalid);
  input M_ACLK;
  input M_ARESETN;
  output [31:0]M_AXI_araddr;
  output [2:0]M_AXI_arprot;
  input [0:0]M_AXI_arready;
  output [0:0]M_AXI_arvalid;
  output [31:0]M_AXI_awaddr;
  output [2:0]M_AXI_awprot;
  input [0:0]M_AXI_awready;
  output [0:0]M_AXI_awvalid;
  output [0:0]M_AXI_bready;
  input [1:0]M_AXI_bresp;
  input [0:0]M_AXI_bvalid;
  input [31:0]M_AXI_rdata;
  output [0:0]M_AXI_rready;
  input [1:0]M_AXI_rresp;
  input [0:0]M_AXI_rvalid;
  output [31:0]M_AXI_wdata;
  input [0:0]M_AXI_wready;
  output [3:0]M_AXI_wstrb;
  output [0:0]M_AXI_wvalid;
  input S_ACLK;
  input S_ARESETN;
  input [31:0]S_AXI_araddr;
  input [2:0]S_AXI_arprot;
  output [0:0]S_AXI_arready;
  input [0:0]S_AXI_arvalid;
  input [31:0]S_AXI_awaddr;
  input [2:0]S_AXI_awprot;
  output [0:0]S_AXI_awready;
  input [0:0]S_AXI_awvalid;
  input [0:0]S_AXI_bready;
  output [1:0]S_AXI_bresp;
  output [0:0]S_AXI_bvalid;
  output [31:0]S_AXI_rdata;
  input [0:0]S_AXI_rready;
  output [1:0]S_AXI_rresp;
  output [0:0]S_AXI_rvalid;
  input [31:0]S_AXI_wdata;
  output [0:0]S_AXI_wready;
  input [3:0]S_AXI_wstrb;
  input [0:0]S_AXI_wvalid;

  wire [31:0]s00_couplers_to_s00_couplers_ARADDR;
  wire [2:0]s00_couplers_to_s00_couplers_ARPROT;
  wire [0:0]s00_couplers_to_s00_couplers_ARREADY;
  wire [0:0]s00_couplers_to_s00_couplers_ARVALID;
  wire [31:0]s00_couplers_to_s00_couplers_AWADDR;
  wire [2:0]s00_couplers_to_s00_couplers_AWPROT;
  wire [0:0]s00_couplers_to_s00_couplers_AWREADY;
  wire [0:0]s00_couplers_to_s00_couplers_AWVALID;
  wire [0:0]s00_couplers_to_s00_couplers_BREADY;
  wire [1:0]s00_couplers_to_s00_couplers_BRESP;
  wire [0:0]s00_couplers_to_s00_couplers_BVALID;
  wire [31:0]s00_couplers_to_s00_couplers_RDATA;
  wire [0:0]s00_couplers_to_s00_couplers_RREADY;
  wire [1:0]s00_couplers_to_s00_couplers_RRESP;
  wire [0:0]s00_couplers_to_s00_couplers_RVALID;
  wire [31:0]s00_couplers_to_s00_couplers_WDATA;
  wire [0:0]s00_couplers_to_s00_couplers_WREADY;
  wire [3:0]s00_couplers_to_s00_couplers_WSTRB;
  wire [0:0]s00_couplers_to_s00_couplers_WVALID;

  assign M_AXI_araddr[31:0] = s00_couplers_to_s00_couplers_ARADDR;
  assign M_AXI_arprot[2:0] = s00_couplers_to_s00_couplers_ARPROT;
  assign M_AXI_arvalid[0] = s00_couplers_to_s00_couplers_ARVALID;
  assign M_AXI_awaddr[31:0] = s00_couplers_to_s00_couplers_AWADDR;
  assign M_AXI_awprot[2:0] = s00_couplers_to_s00_couplers_AWPROT;
  assign M_AXI_awvalid[0] = s00_couplers_to_s00_couplers_AWVALID;
  assign M_AXI_bready[0] = s00_couplers_to_s00_couplers_BREADY;
  assign M_AXI_rready[0] = s00_couplers_to_s00_couplers_RREADY;
  assign M_AXI_wdata[31:0] = s00_couplers_to_s00_couplers_WDATA;
  assign M_AXI_wstrb[3:0] = s00_couplers_to_s00_couplers_WSTRB;
  assign M_AXI_wvalid[0] = s00_couplers_to_s00_couplers_WVALID;
  assign S_AXI_arready[0] = s00_couplers_to_s00_couplers_ARREADY;
  assign S_AXI_awready[0] = s00_couplers_to_s00_couplers_AWREADY;
  assign S_AXI_bresp[1:0] = s00_couplers_to_s00_couplers_BRESP;
  assign S_AXI_bvalid[0] = s00_couplers_to_s00_couplers_BVALID;
  assign S_AXI_rdata[31:0] = s00_couplers_to_s00_couplers_RDATA;
  assign S_AXI_rresp[1:0] = s00_couplers_to_s00_couplers_RRESP;
  assign S_AXI_rvalid[0] = s00_couplers_to_s00_couplers_RVALID;
  assign S_AXI_wready[0] = s00_couplers_to_s00_couplers_WREADY;
  assign s00_couplers_to_s00_couplers_ARADDR = S_AXI_araddr[31:0];
  assign s00_couplers_to_s00_couplers_ARPROT = S_AXI_arprot[2:0];
  assign s00_couplers_to_s00_couplers_ARREADY = M_AXI_arready[0];
  assign s00_couplers_to_s00_couplers_ARVALID = S_AXI_arvalid[0];
  assign s00_couplers_to_s00_couplers_AWADDR = S_AXI_awaddr[31:0];
  assign s00_couplers_to_s00_couplers_AWPROT = S_AXI_awprot[2:0];
  assign s00_couplers_to_s00_couplers_AWREADY = M_AXI_awready[0];
  assign s00_couplers_to_s00_couplers_AWVALID = S_AXI_awvalid[0];
  assign s00_couplers_to_s00_couplers_BREADY = S_AXI_bready[0];
  assign s00_couplers_to_s00_couplers_BRESP = M_AXI_bresp[1:0];
  assign s00_couplers_to_s00_couplers_BVALID = M_AXI_bvalid[0];
  assign s00_couplers_to_s00_couplers_RDATA = M_AXI_rdata[31:0];
  assign s00_couplers_to_s00_couplers_RREADY = S_AXI_rready[0];
  assign s00_couplers_to_s00_couplers_RRESP = M_AXI_rresp[1:0];
  assign s00_couplers_to_s00_couplers_RVALID = M_AXI_rvalid[0];
  assign s00_couplers_to_s00_couplers_WDATA = S_AXI_wdata[31:0];
  assign s00_couplers_to_s00_couplers_WREADY = M_AXI_wready[0];
  assign s00_couplers_to_s00_couplers_WSTRB = S_AXI_wstrb[3:0];
  assign s00_couplers_to_s00_couplers_WVALID = S_AXI_wvalid[0];
endmodule
